OmniboxCreator/OmniBox/firmware/README.md

# OmniBox firmware

Bare-metal STM32H723 firmware for the OmniBox V1 board.

Version: 0.1 dev.

Public features:

- J2534 vendor bulk transport over WinUSB.
- ELM327-compatible CDC serial interface.
- USB identity selector with three empty public vendor slots.
- Board drivers for CAN/CAN-FD, K-line, J1850/SWCAN, FEPS and the routing matrix.

Current development status:

- Stable development path: J2534 CAN and ISO15765 over classic CAN.
- Implemented host/firmware capability negotiation for OmniBox protocol v2.
- Implemented OmniBox channel configuration hooks for physical bus selection,
  OBD routing, CAN termination, CAN polarity swap, SWCAN mode and CAN-FD flags.
- Implemented STM32 FDCAN and MCP2518FD CAN-FD framing paths with 64-byte DLC
  mapping and BRS/FDF flag propagation.
- Implemented ELM327 CAN single-frame transmit and multi-frame ISO-TP response
  reassembly.
- K-line init IOCTLs are wired through the host/firmware protocol; physical
  slow-init and fast-init timing still require bench validation.
- J1850, SWCAN and CAN-FD remain experimental until their physical-layer paths
  are validated on hardware.

The empty slots are intentionally protocol-free. They are placeholders for
non-commercial experiments without shipping any private identity implementation.

## Build

Prerequisites: `arm-none-eabi-gcc`, CMake and Ninja.

```bash
cmake -B build -G Ninja -DCMAKE_TOOLCHAIN_FILE=cmake/arm-gcc.cmake
cmake --build build
```

The first configure downloads CMSIS, STM32H7 HAL and TinyUSB through CMake
FetchContent. For offline builds, pre-populate `extern/` with the pinned
dependencies and configure with `-DFETCHCONTENT_FULLY_DISCONNECTED=ON`.
