OmniboxCreator/OmniBox/docs/README.md

# Public notes

This directory is reserved for public OmniBox notes. Private research material is
not part of this repository.
