OmniboxCreator/OmniBox/hardware/omnibox-v1/enclosure/sheetmetal/README.md

# Sheet-Metal Enclosure

This directory contains the V1 sheet-metal enclosure files:

- `out/bac.step`: base tray.
- `out/capot.step`: top cover.
- `out/laser_marking_capot.dxf`: laser-marking drawing.
- `preview.png`: generated preview.

Check connector clearances and bend constraints with the enclosure supplier
before ordering.
