OmniboxCreator/OmniBox/hardware/omnibox-v1/enclosure/sheetmetal/out/laser_marking_preview.png

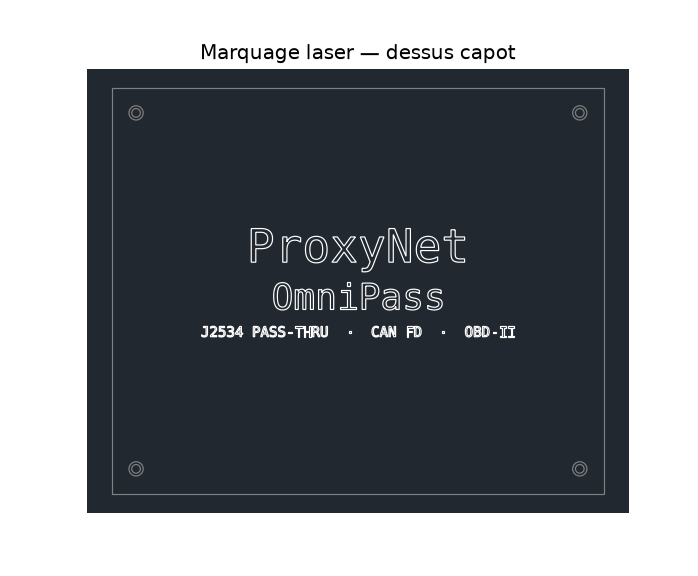
hardware/omnibox-v1/enclosure/sheetmetal/out/laser_marking_preview.png
