OmniboxCreator/OmniBox/hardware/omnibox-v1/enclosure/sheetmetal/preview.png

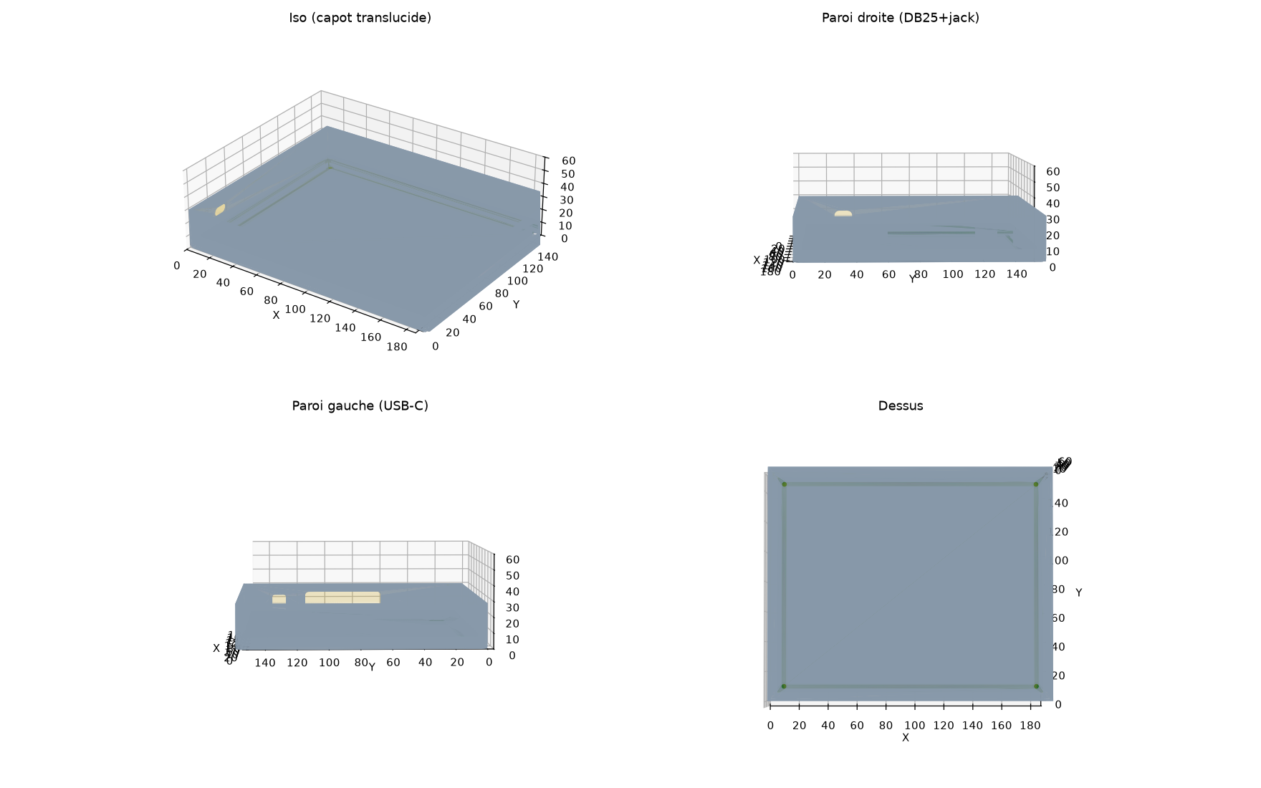
hardware/omnibox-v1/enclosure/sheetmetal/preview.png
