OmniboxCreator/OmniBox/hardware/omnibox-v1/enclosure/print3d/out/panneau.step

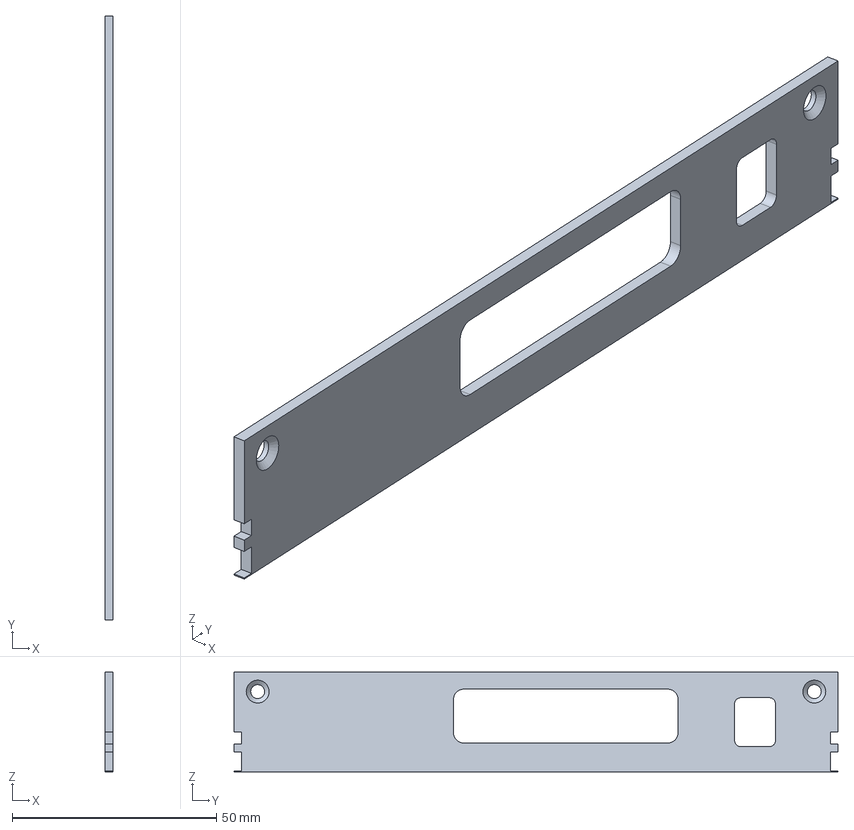
[picture p4: CAD file, 2026-07-20]
hardware/omnibox-v1/enclosure/print3d/out/panneau.step
2.00 x 148.0 x 24.5 mm
