OmniboxCreator/OmniBox/hardware/omnibox-v1/enclosure/sheetmetal/out/laser_marking_capot.dxf

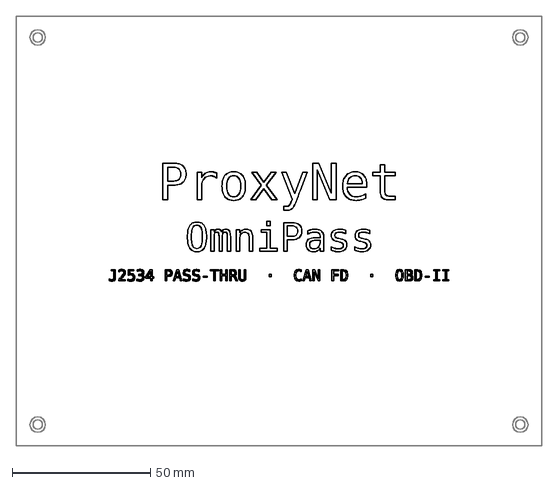
[picture p5: CAD file, 2026-07-20]
hardware/omnibox-v1/enclosure/sheetmetal/out/laser_marking_capot.dxf
189.8 x 155.3 mm
