OmniboxCreator/OmniBox/hardware/omnibox-v1/enclosure/print3d/out/fourreau.step

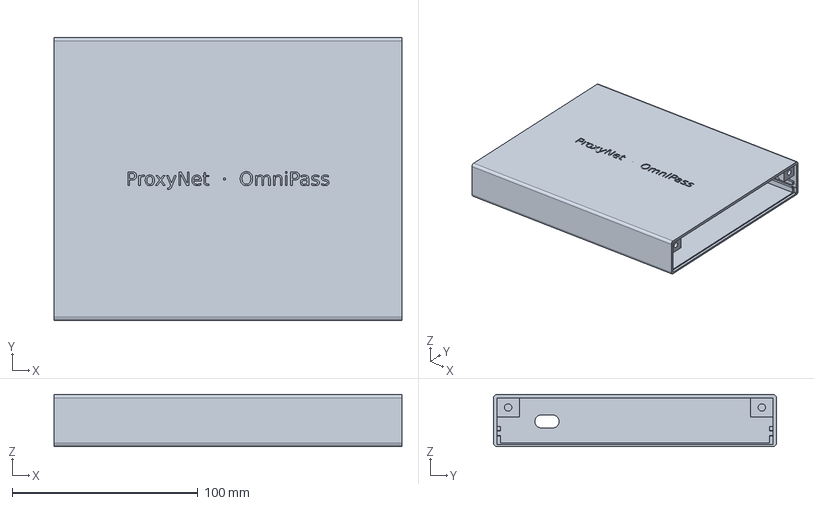
[picture p6: CAD file, 2026-07-20]
hardware/omnibox-v1/enclosure/print3d/out/fourreau.step
187.2 x 152.4 x 28.0 mm
