OmniboxCreator/OmniBox/hardware/omnibox-v1/enclosure/sheetmetal/out/capot.step

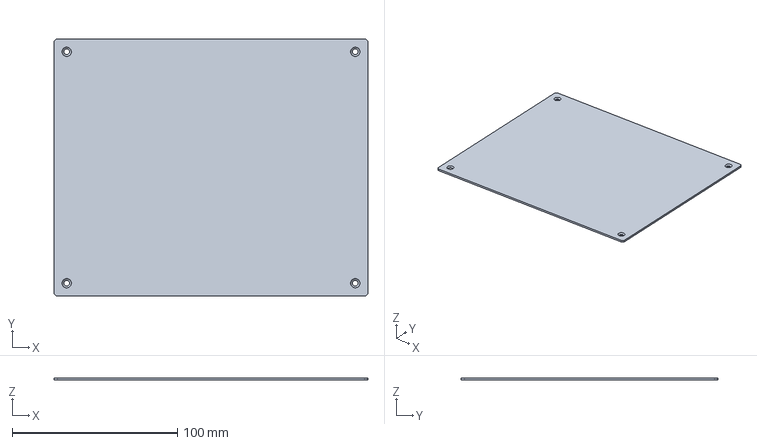
[picture p7: CAD file, 2026-07-20]
hardware/omnibox-v1/enclosure/sheetmetal/out/capot.step
189.8 x 155.3 x 1.50 mm
