OmniboxCreator/OmniBox/hardware/omnibox-v1/enclosure/sheetmetal/out/bac.step

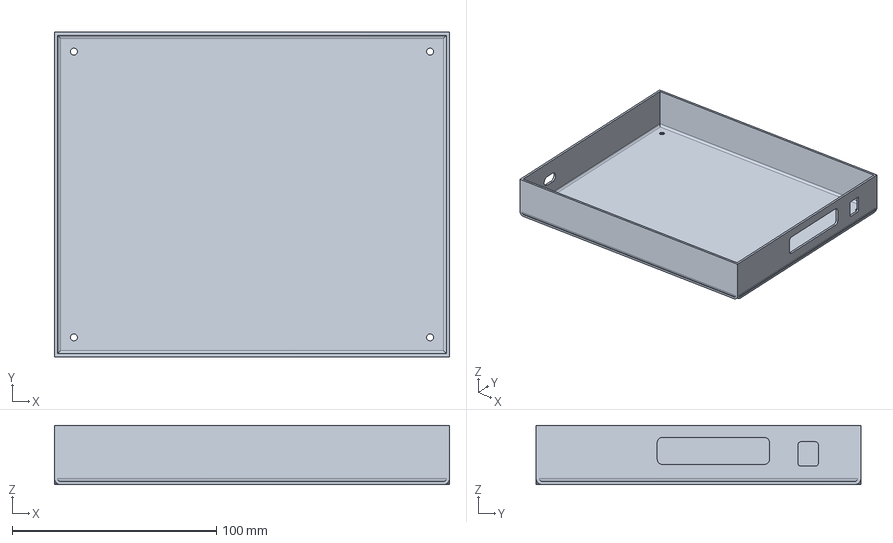
[picture p8: CAD file, 2026-07-20]
hardware/omnibox-v1/enclosure/sheetmetal/out/bac.step
193.4 x 158.9 x 29.0 mm
