OmniboxCreator/OmniBox/(list of files, cad)

Other CAD files:
hardware/omnibox-v1/enclosure/print3d/out/fourreau.stl
hardware/omnibox-v1/enclosure/print3d/out/panneau.stl
hardware/omnibox-v1/enclosure/sheetmetal/out/bac.stl
hardware/omnibox-v1/enclosure/sheetmetal/out/capot.stl
