OmniboxCreator/OmniBox/hardware/omnibox-v1/enclosure/print3d/README.md

# 3D-Printed Accessories

This directory contains auxiliary printable enclosure parts:

- `out/fourreau.step` / `out/fourreau.stl`
- `out/panneau.step` / `out/panneau.stl`

These parts complement the sheet-metal enclosure and should be checked against
the assembled PCB before production.
