OmniboxCreator/OmniBox/hardware/omnibox-v1/production/j2534-schematics.pdf

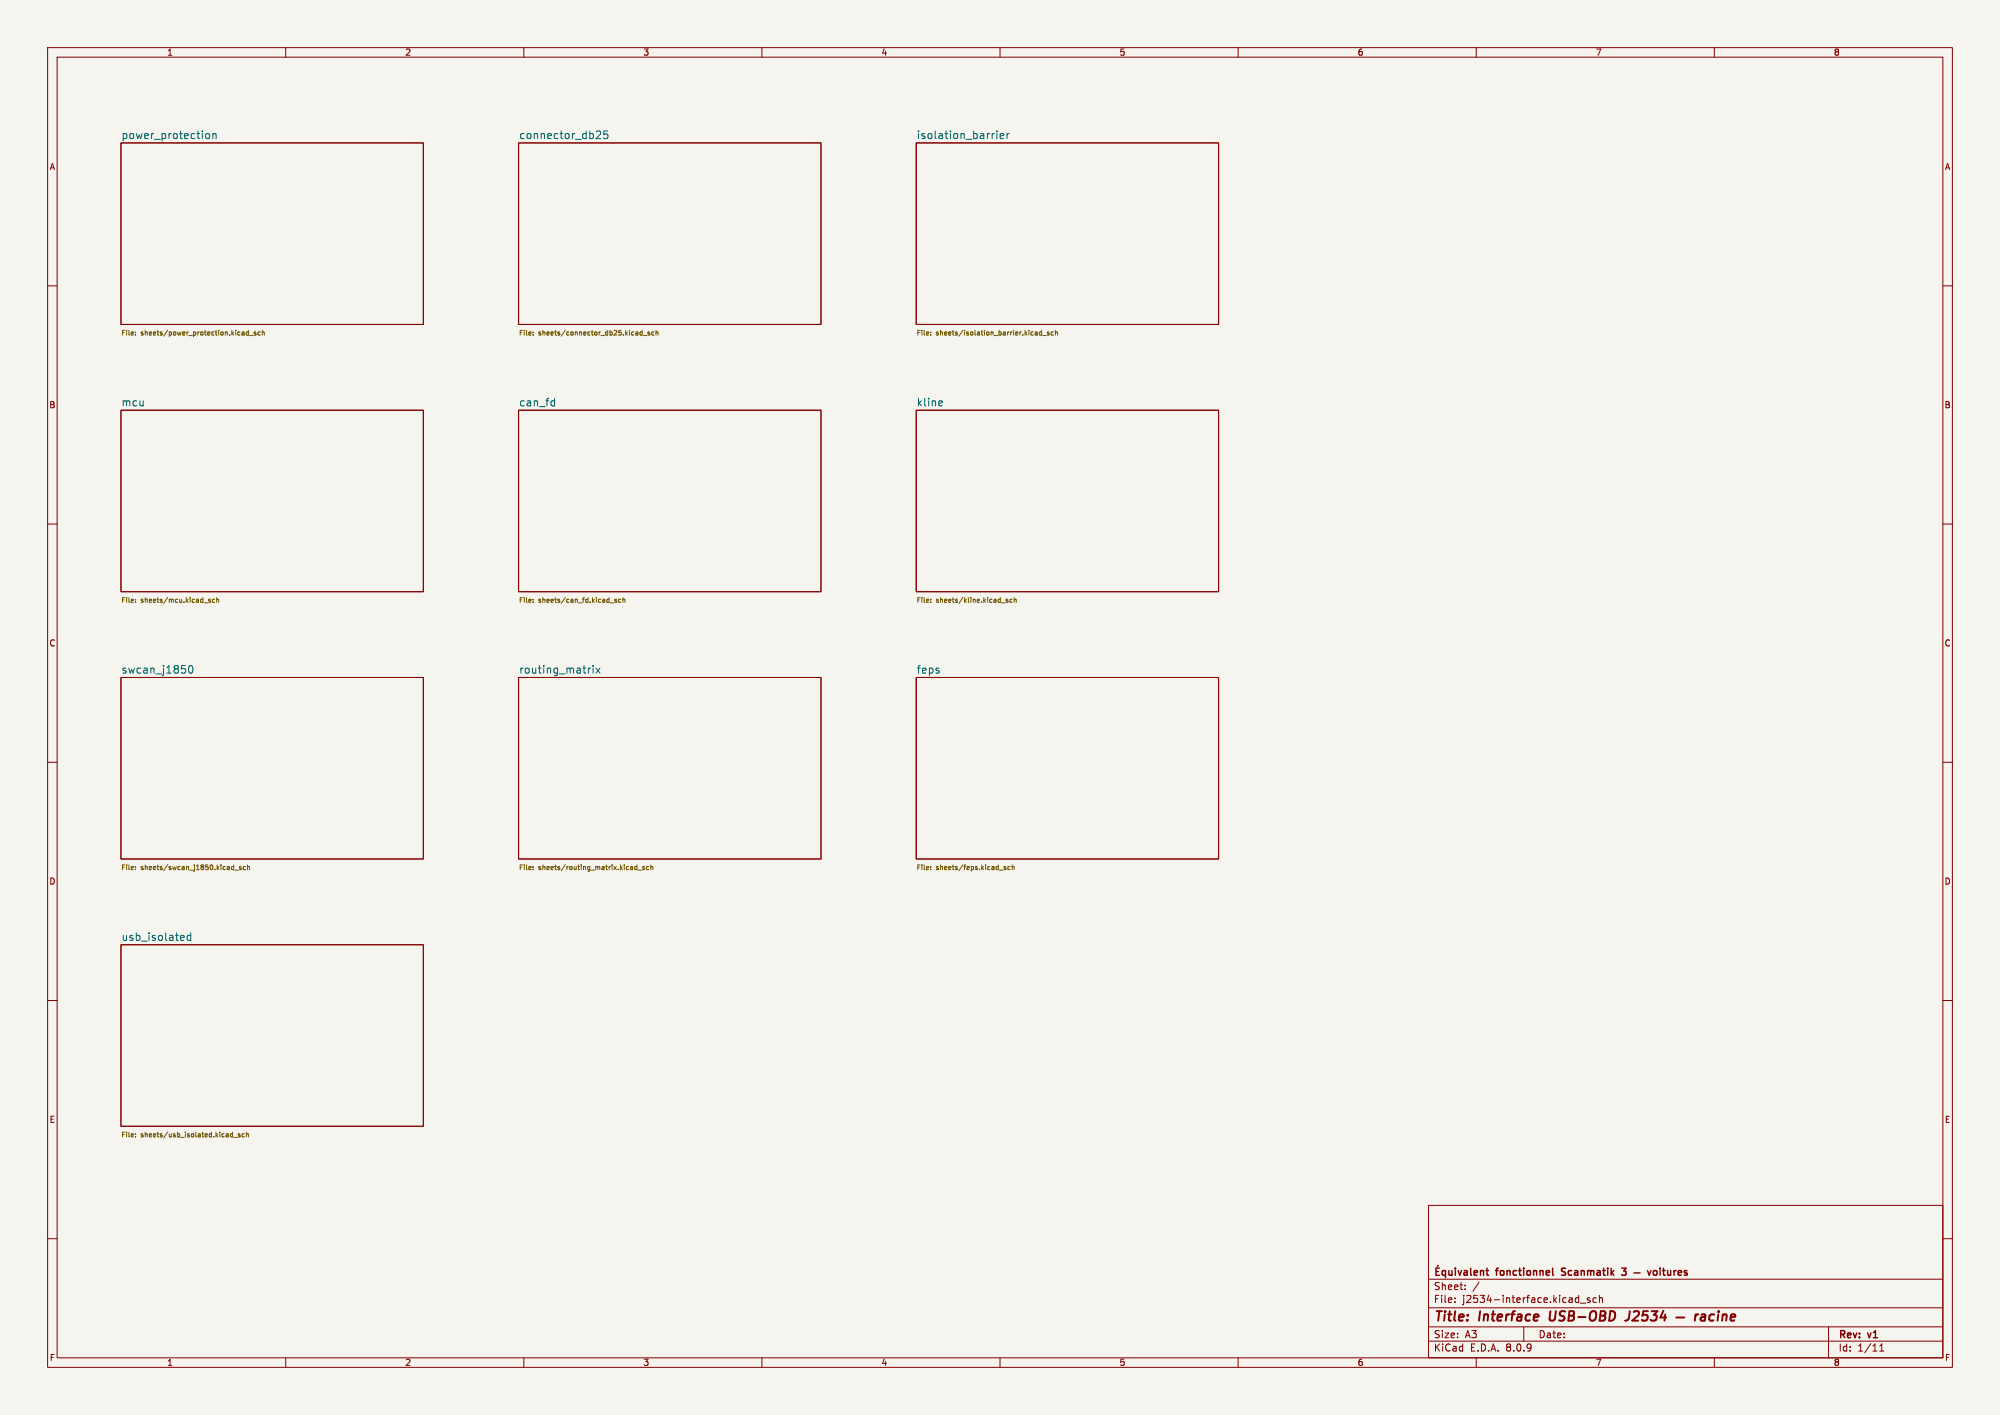
[picture p9: page 1]

Id: 1/11 Title: Interface USB-OBD J2534 þÿ racine

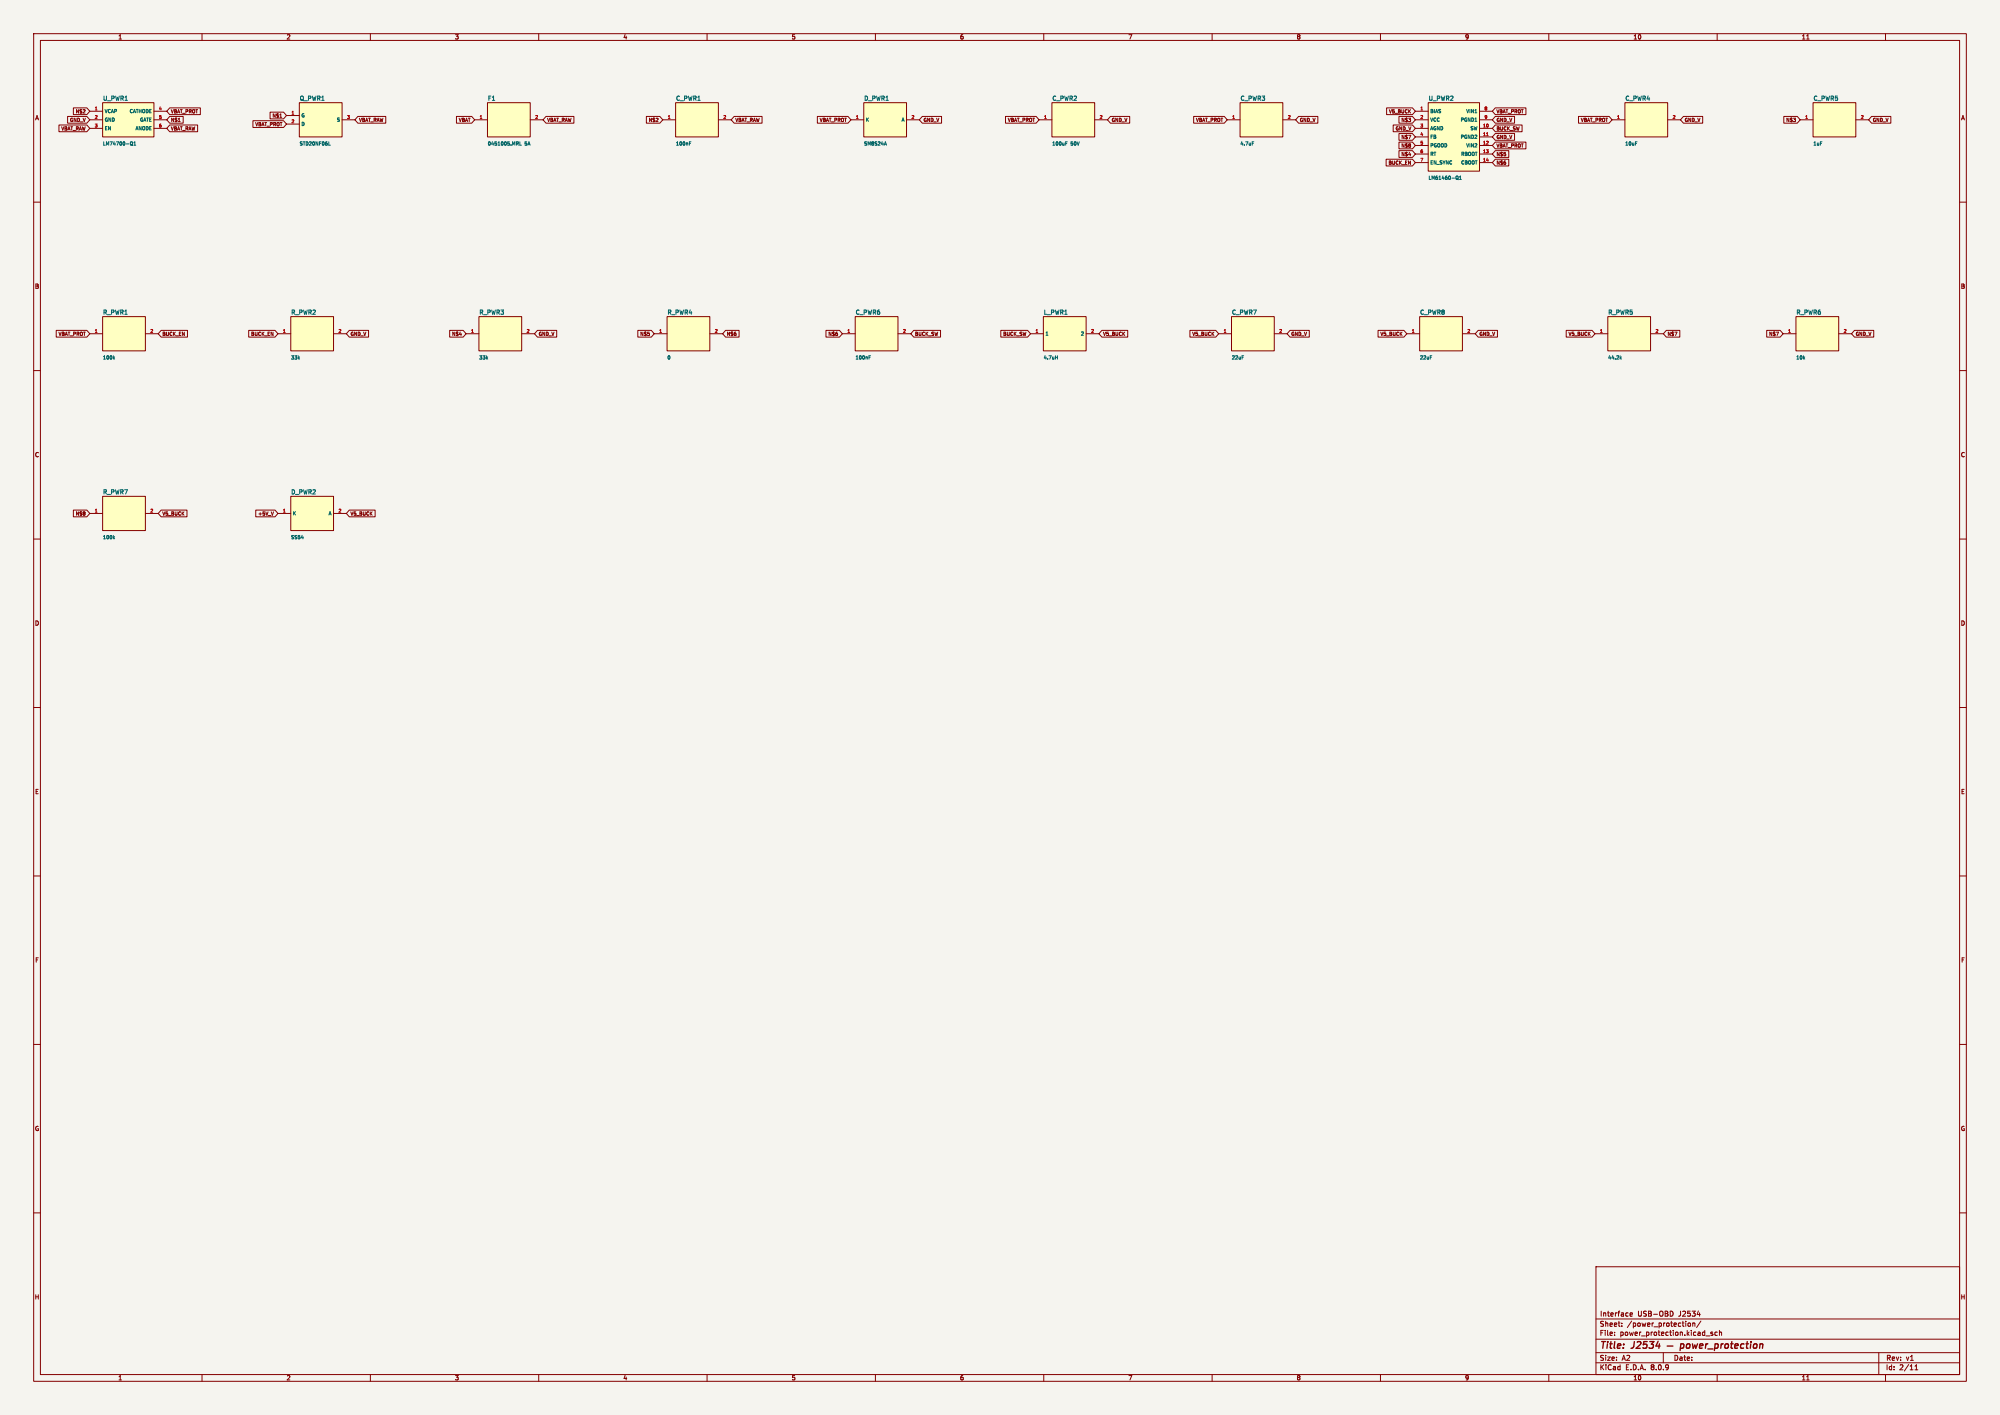
[picture p10: page 2]

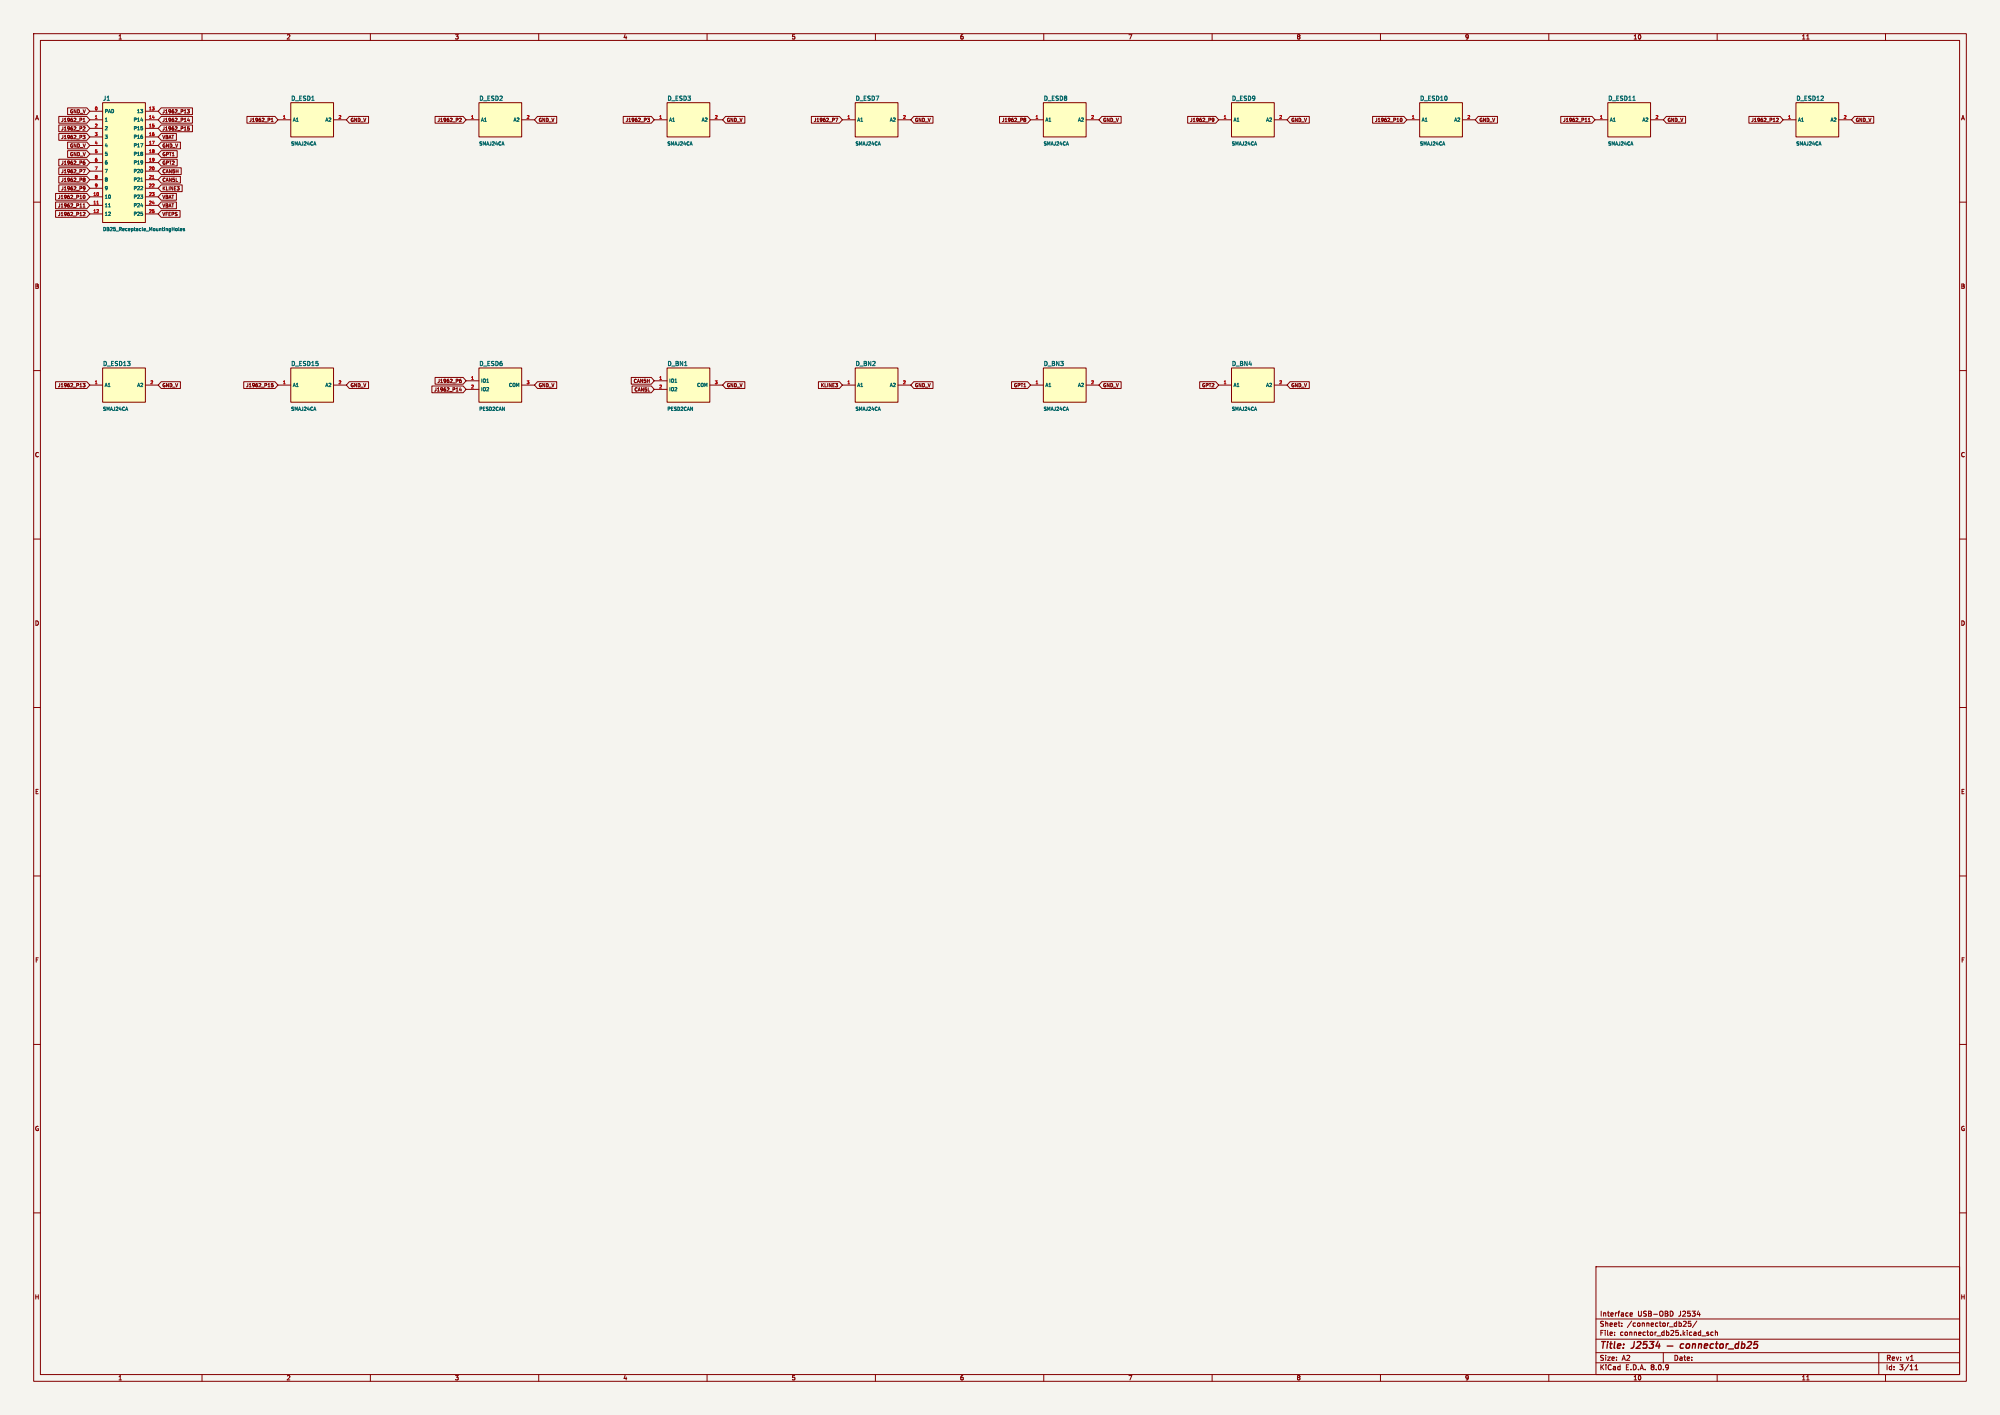
[picture p11: page 3]

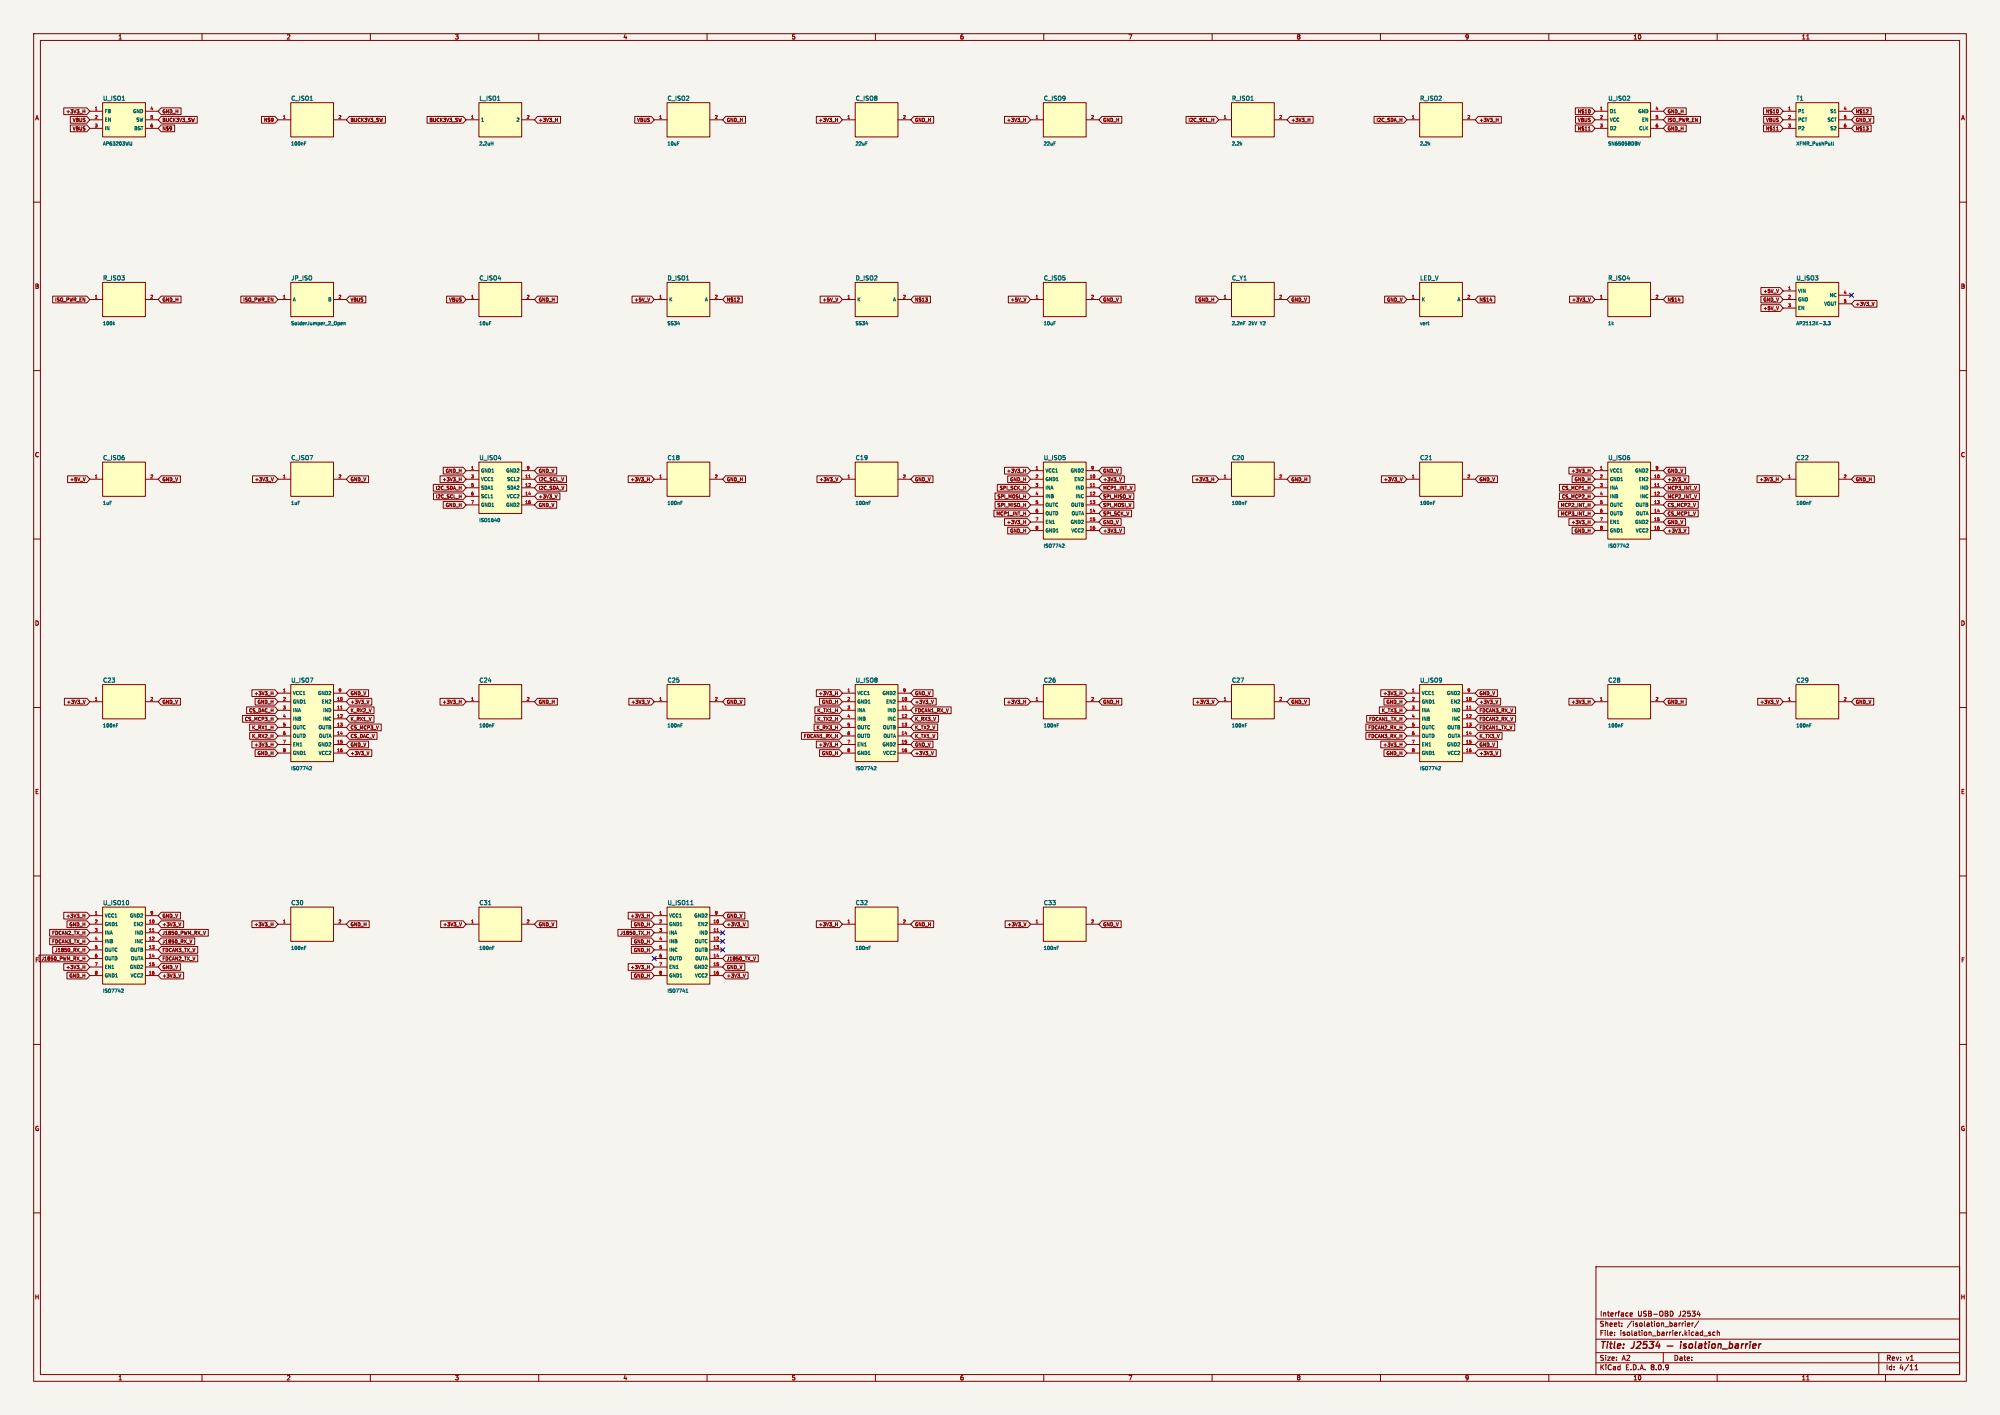
[picture p12: page 4]

IND 11 OUTC 12 OUTB 13 OUTA 14 GND2 15 VCC2 16 GND1 2
INA 3
INB 4

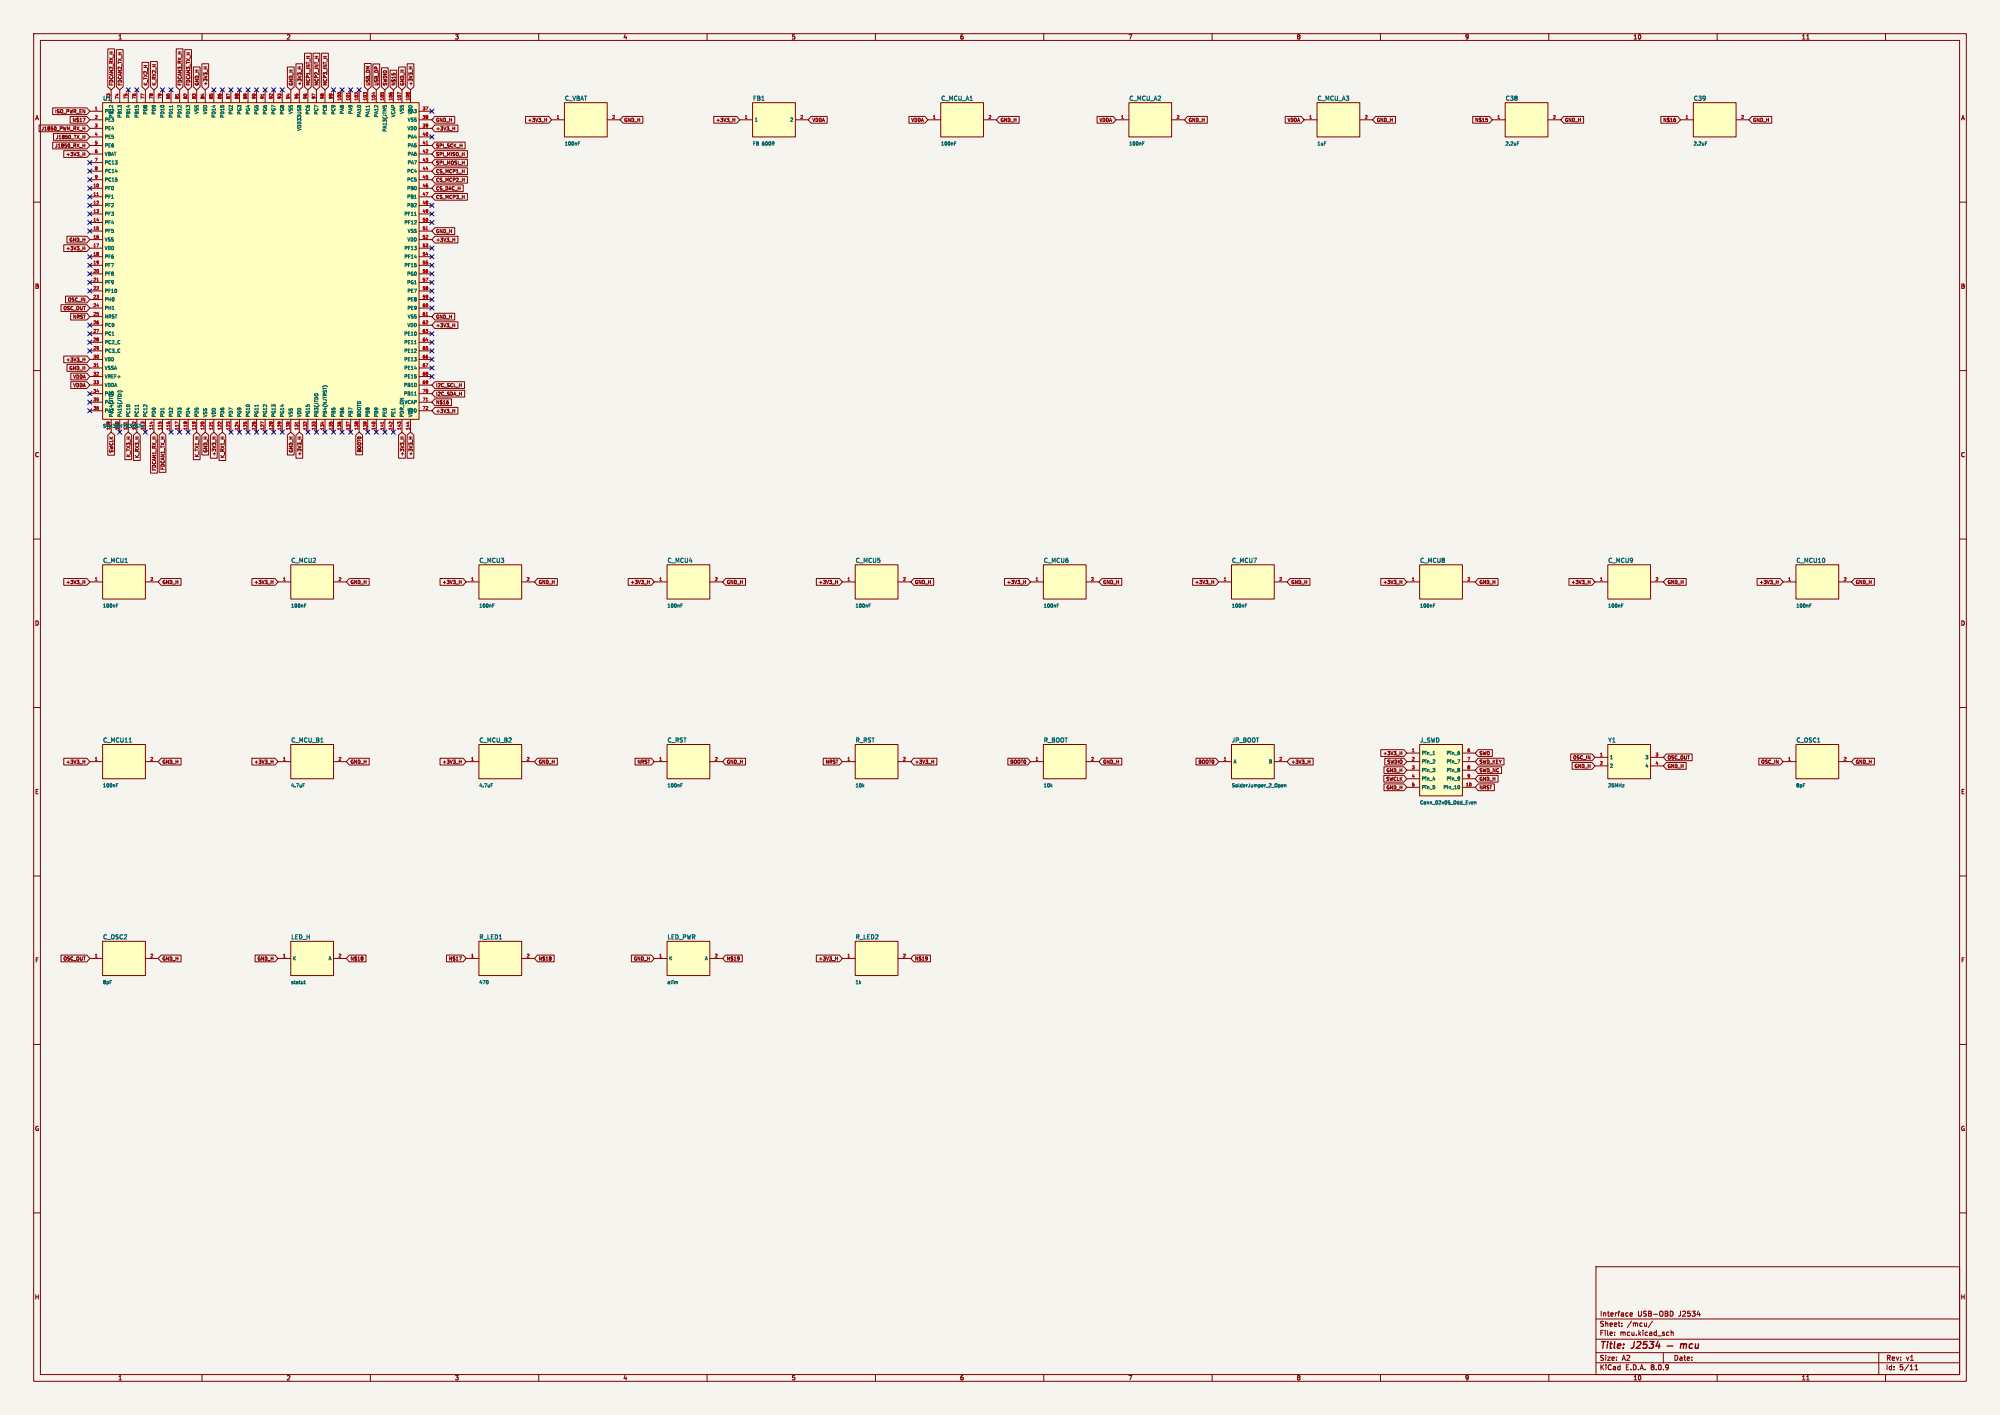
[picture p13: page 5]

File: mcu.kicad_sch Sheet: /mcu/

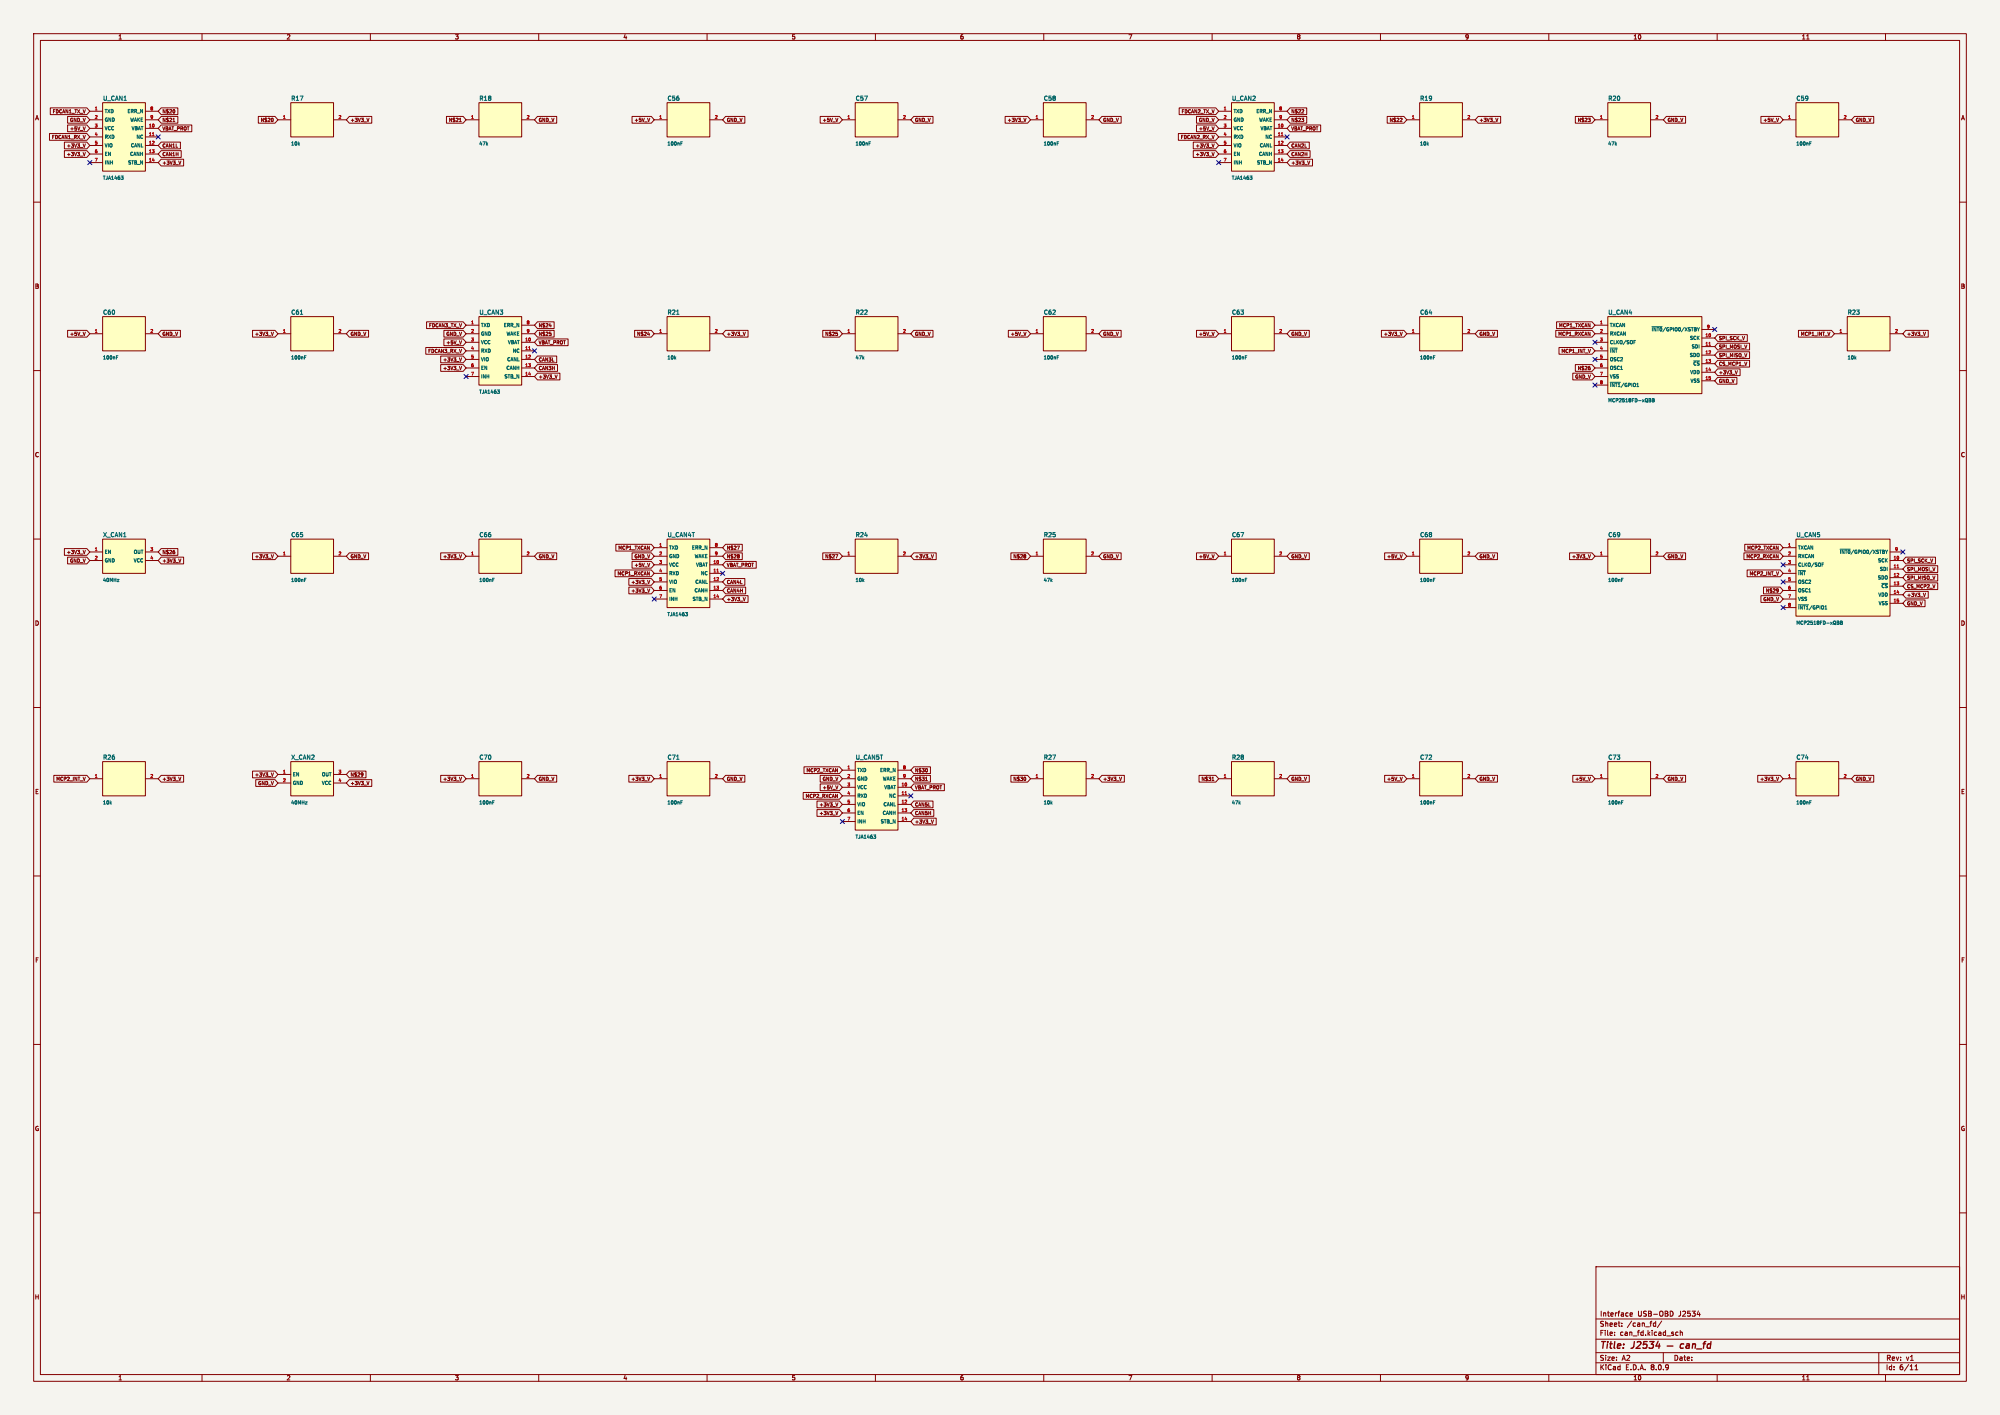
[picture p14: page 6]

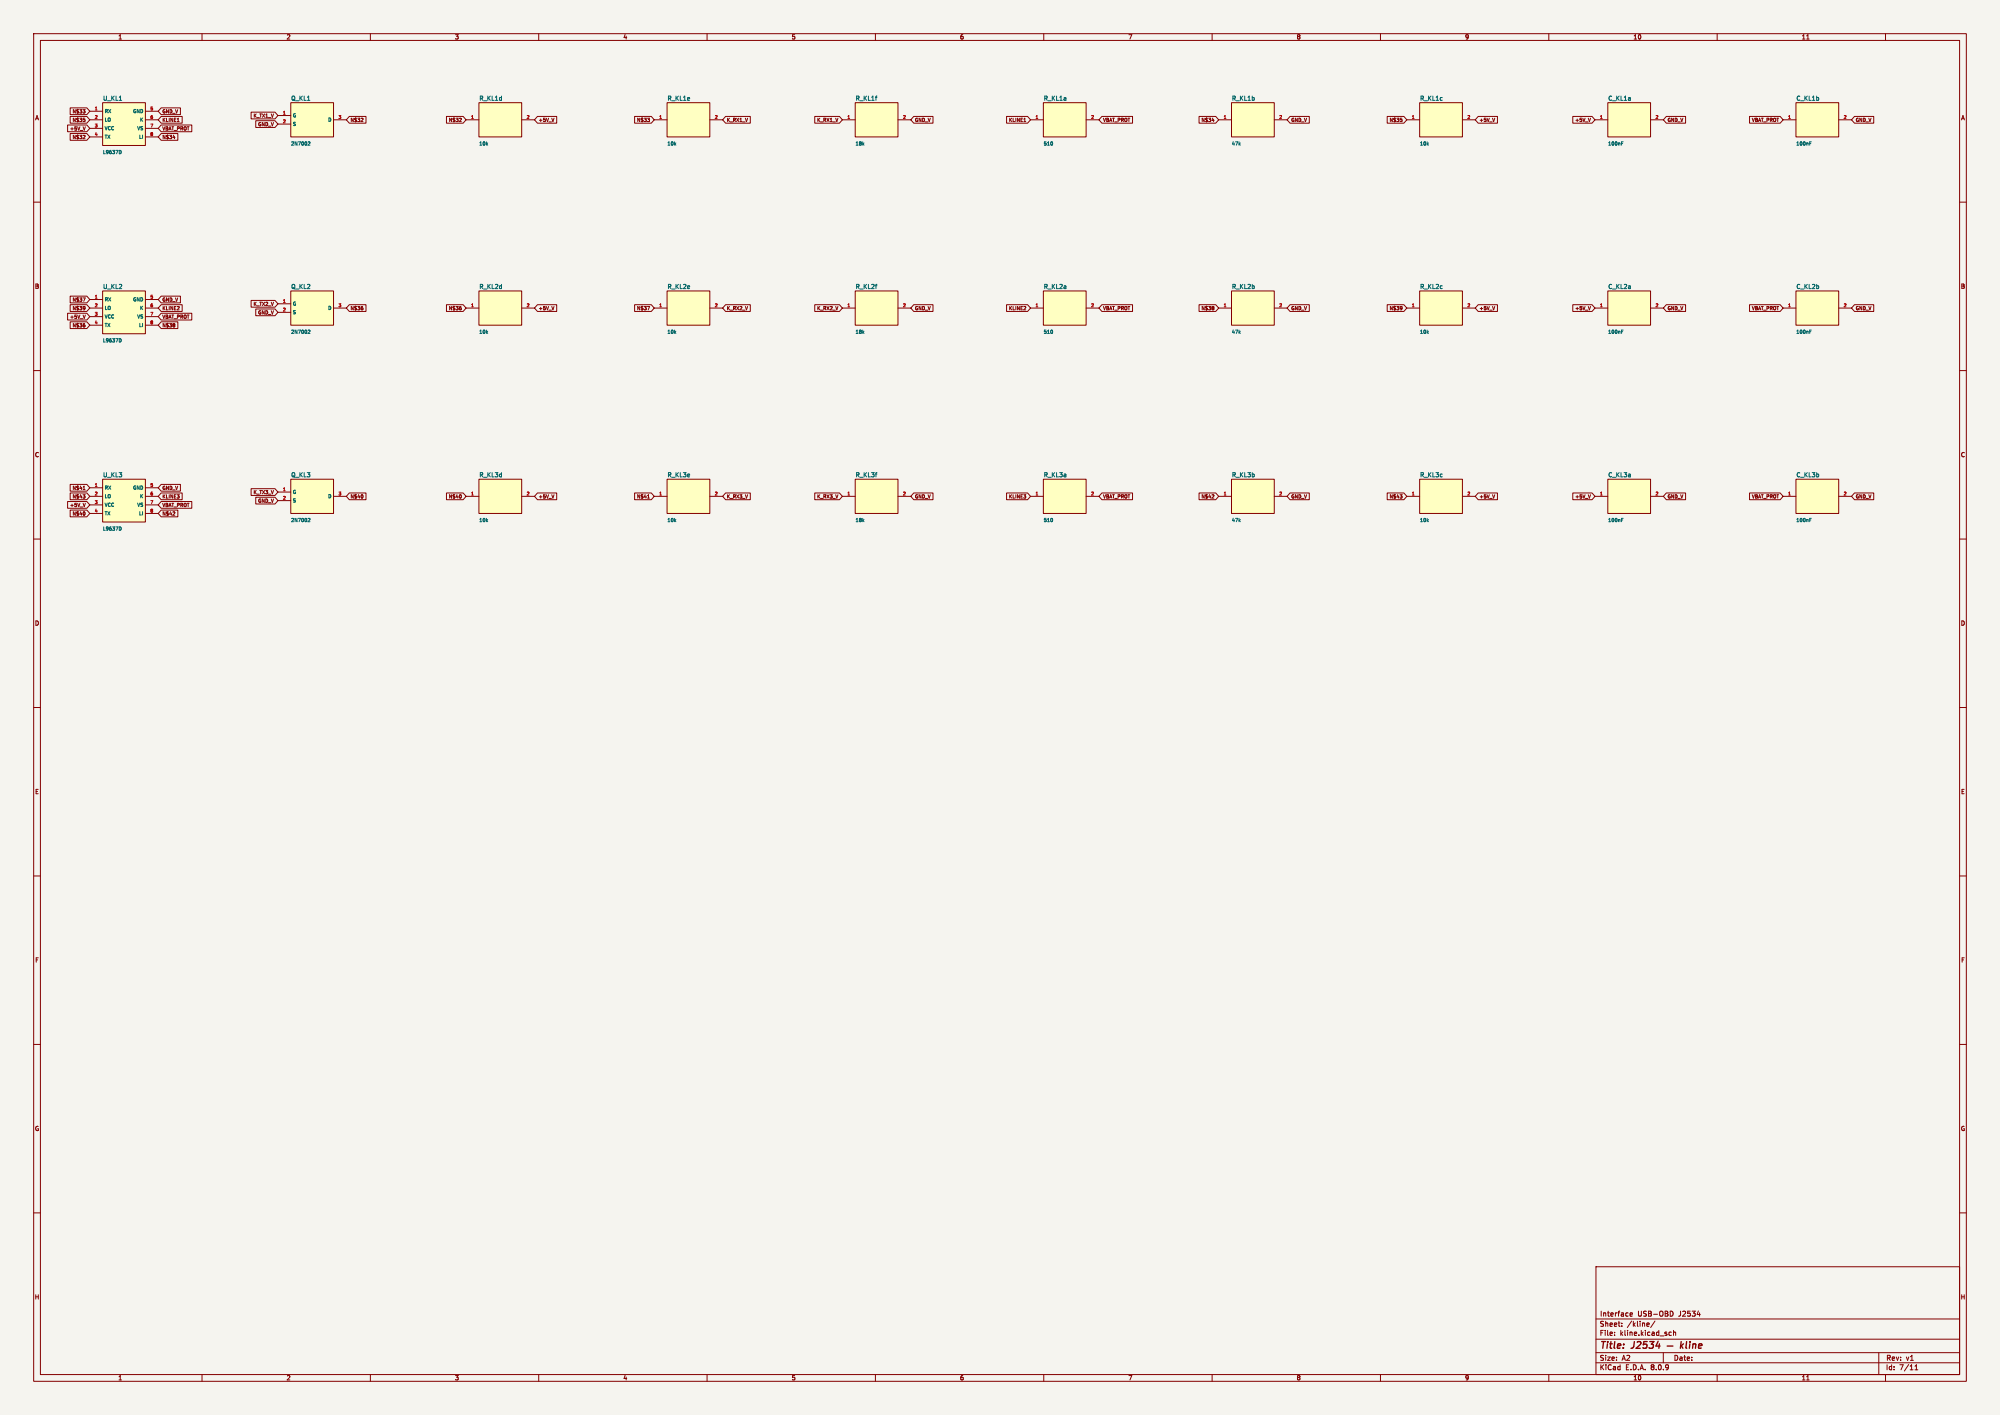
[picture p15: page 7]

File: kline.kicad_sch Sheet: /kline/

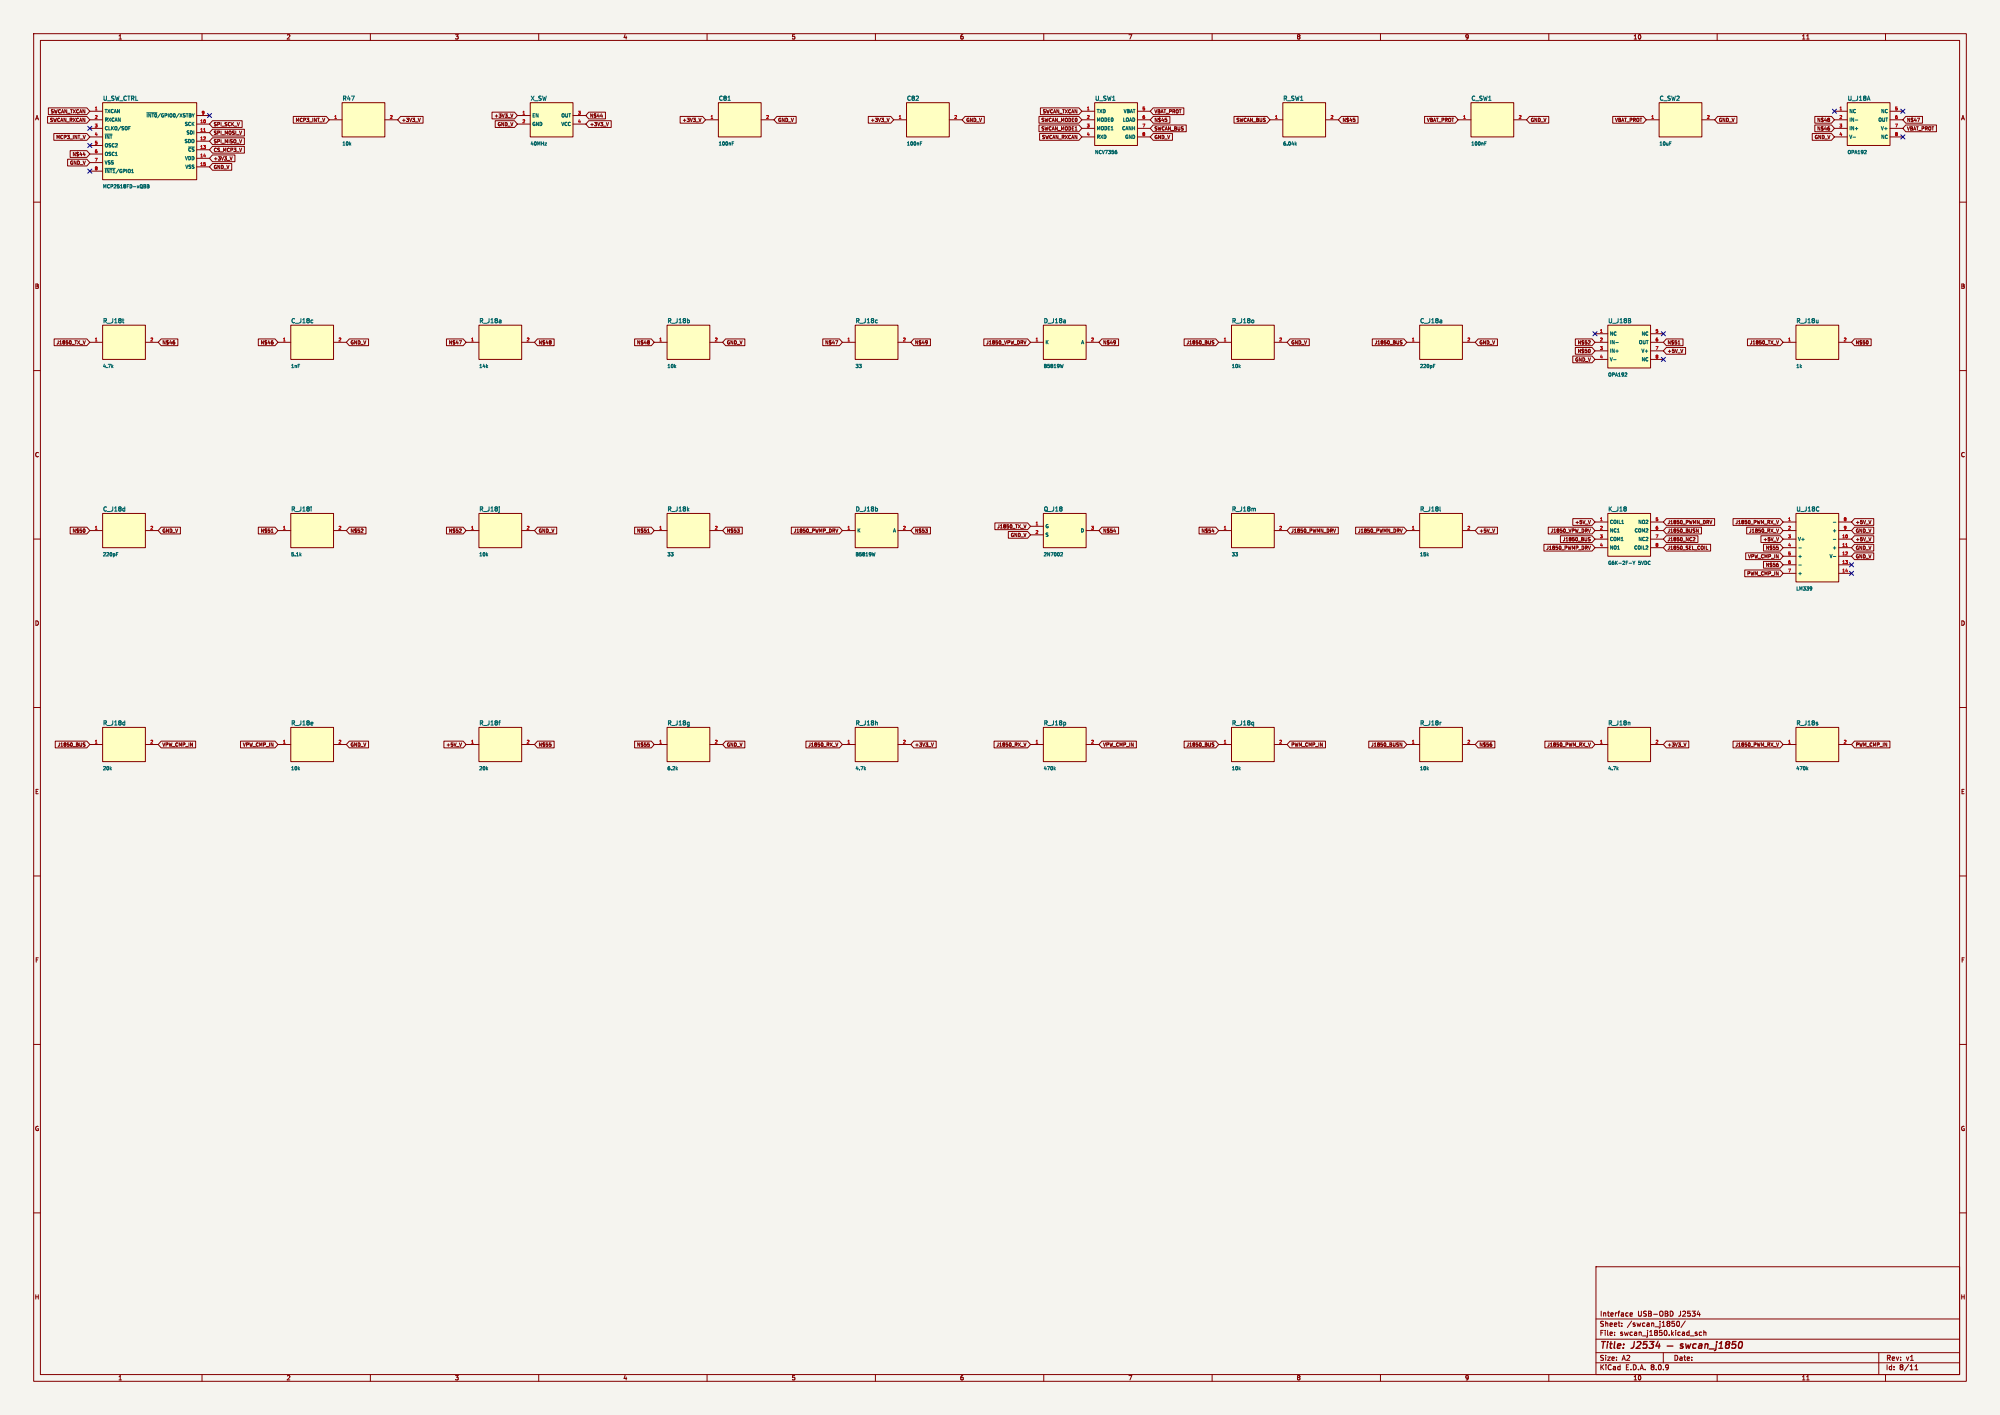
[picture p16: page 8]

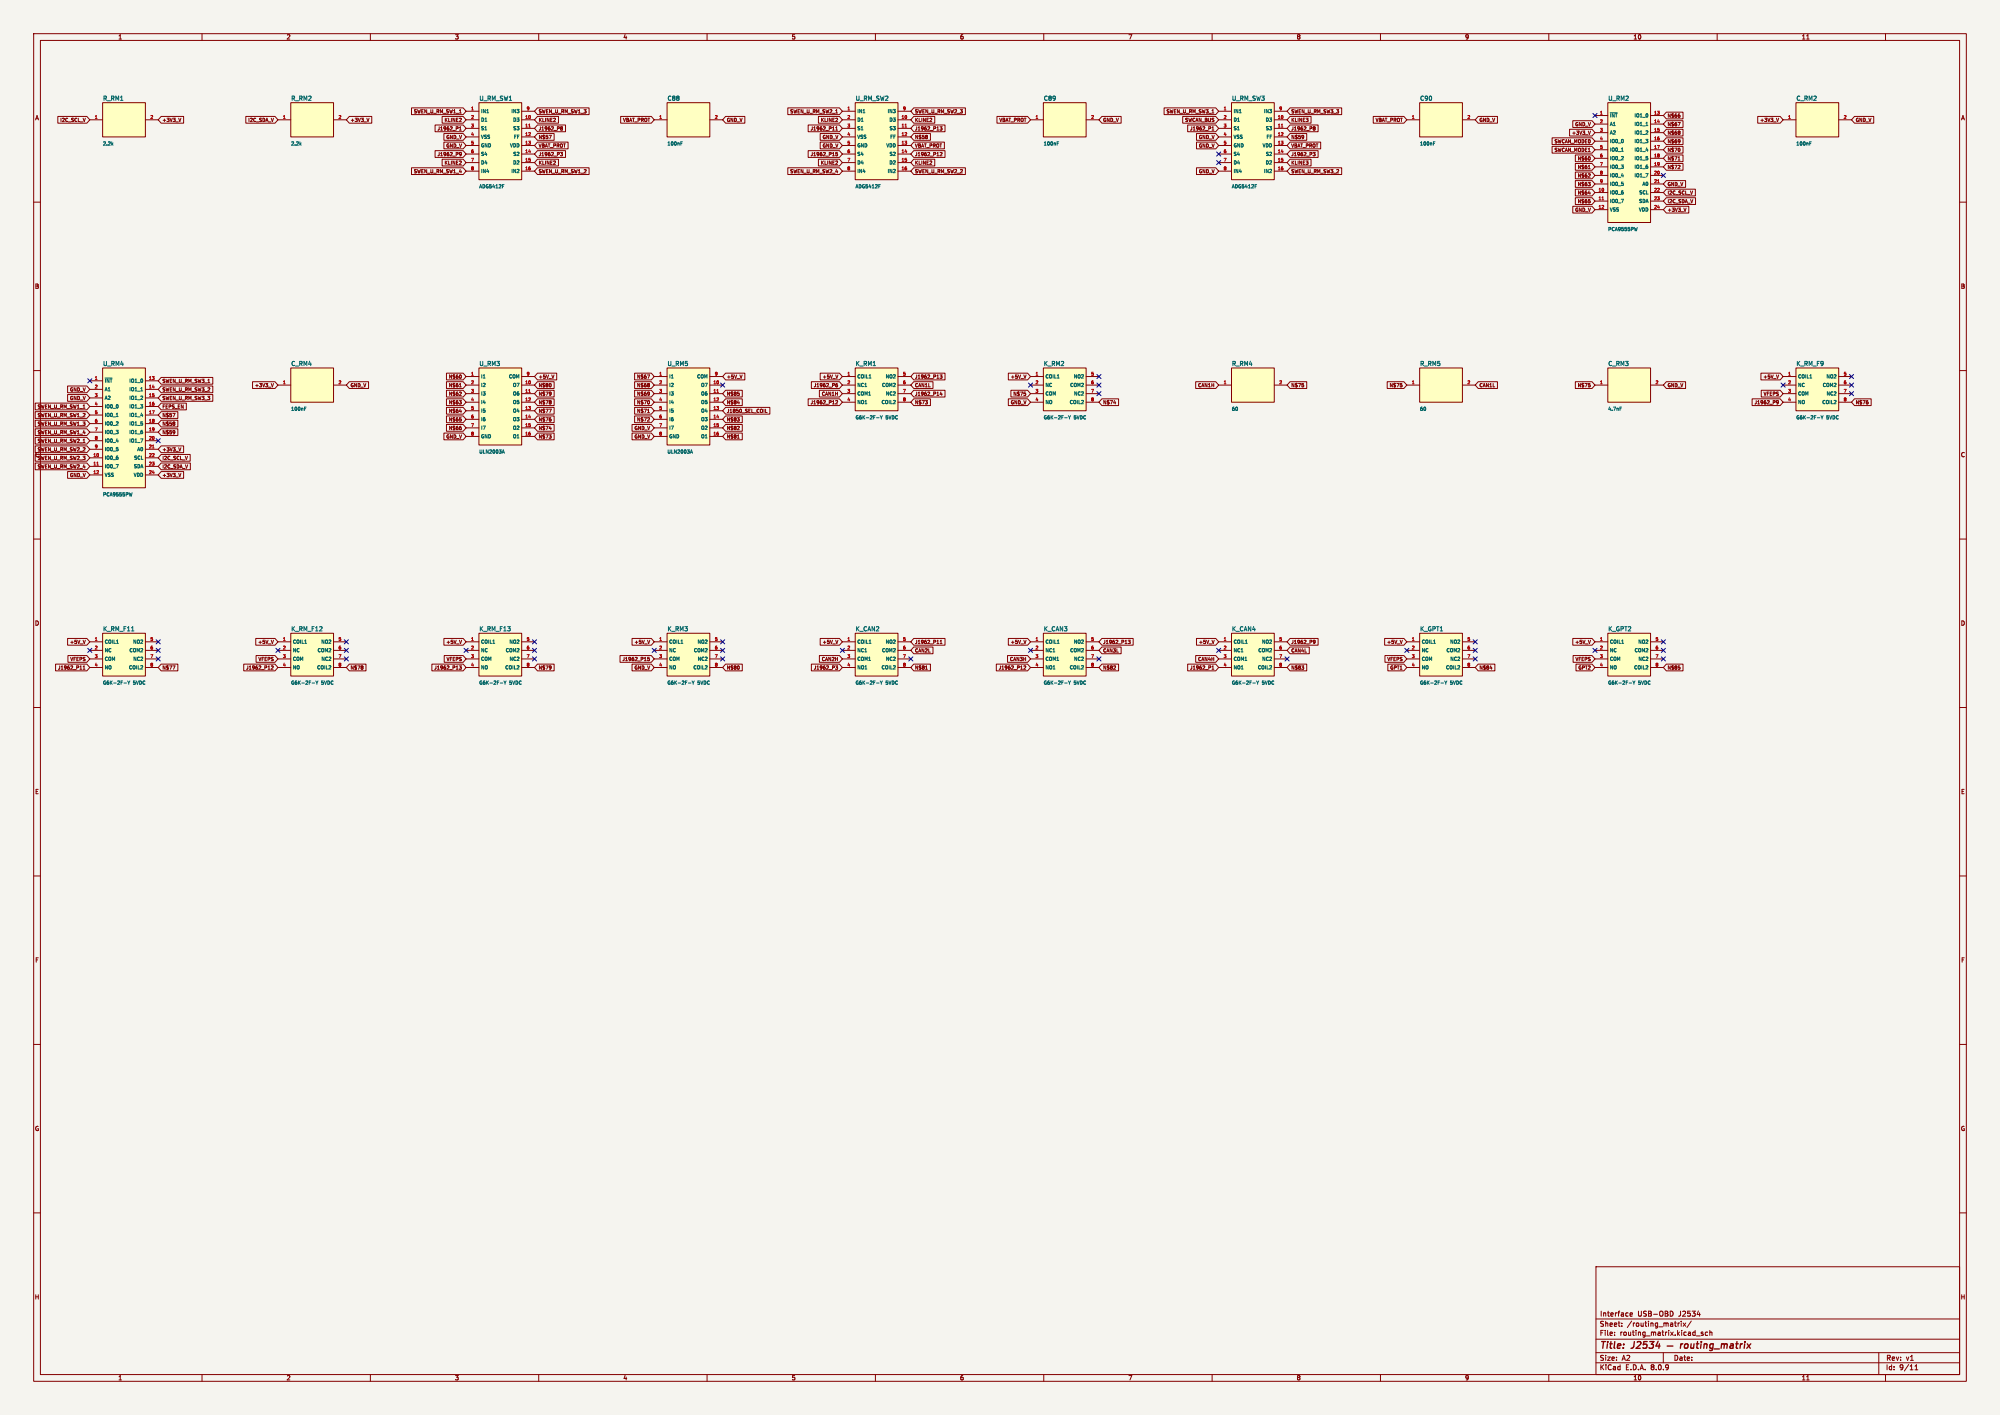
[picture p17: page 9]

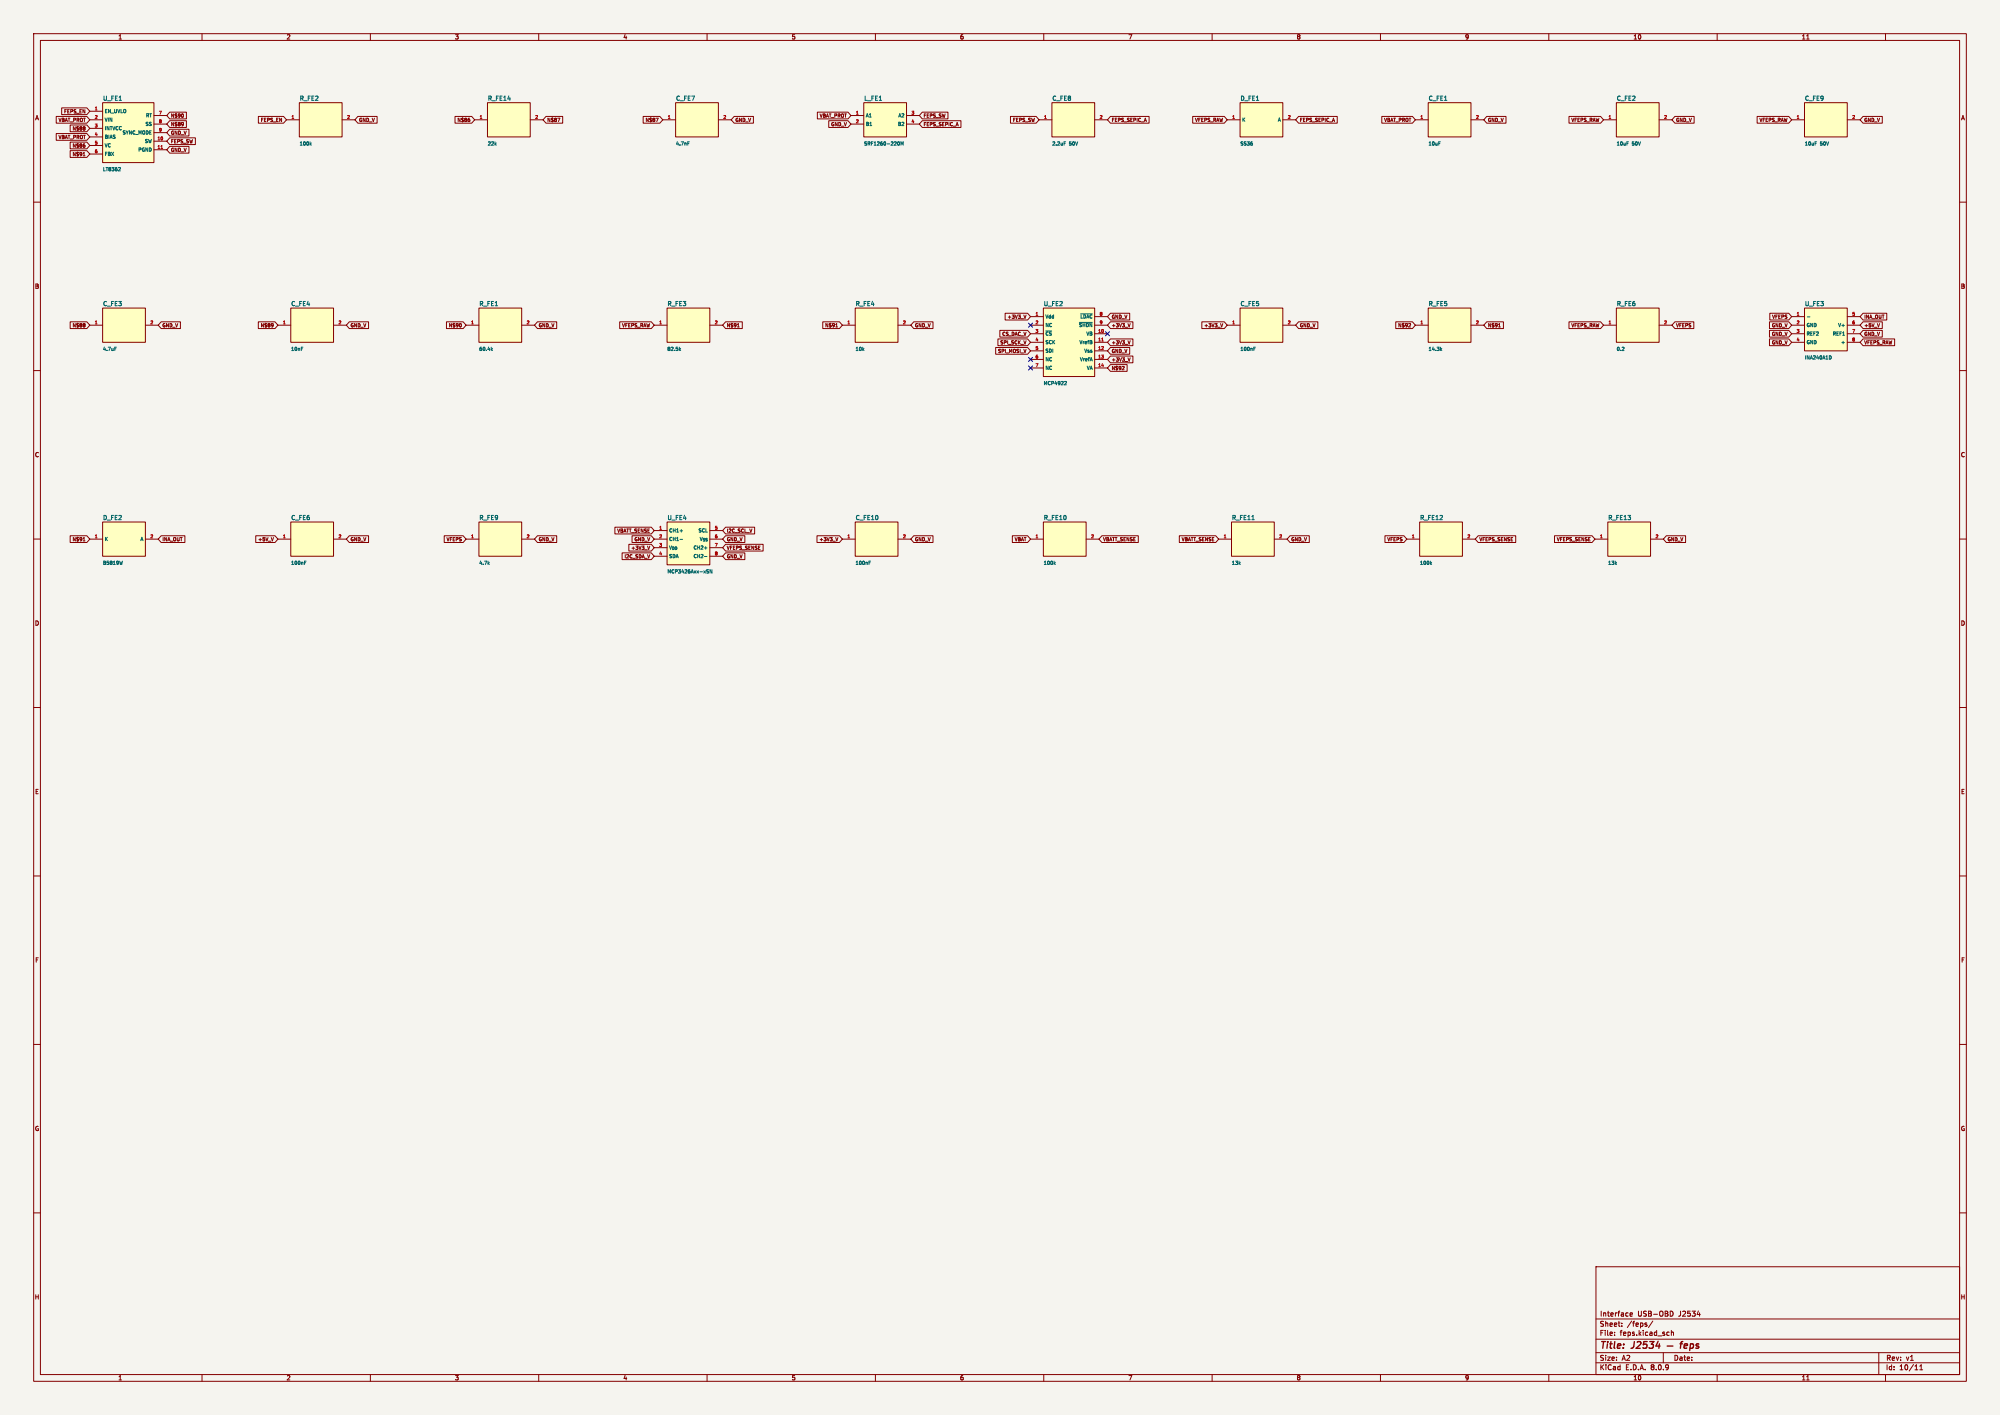
[picture p18: page 10]

File: feps.kicad_sch Sheet: /feps/

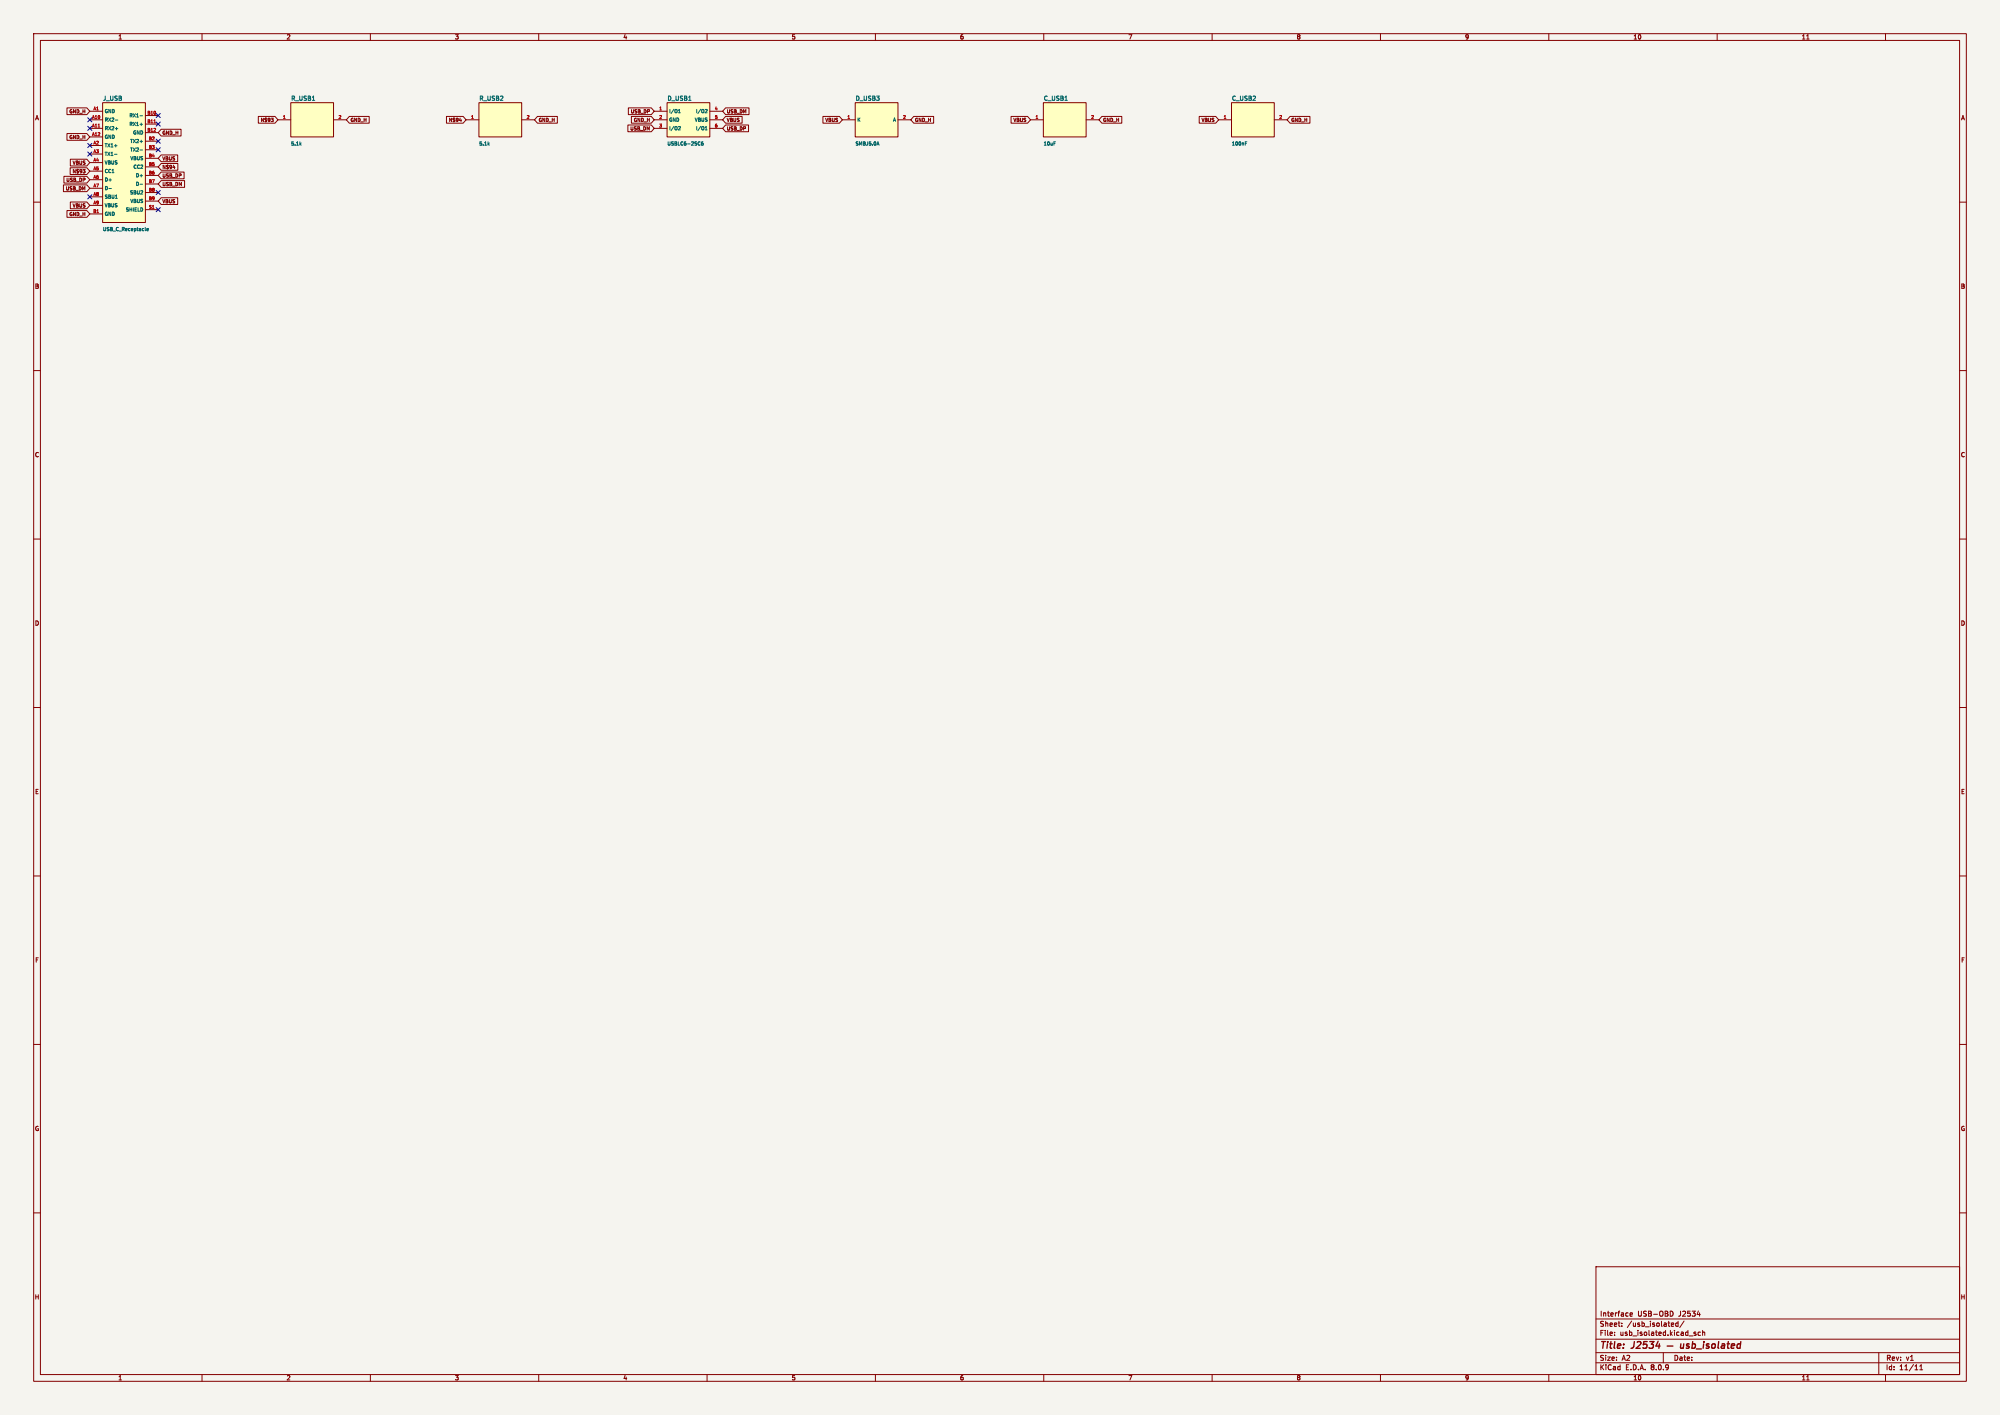
[picture p19: page 11]
