OmniboxCreator/OmniBox/hardware/omnibox-v1/sheets/can_fd.kicad_sch

## KiCad design hardware/omnibox-v1/sheets/can_fd.kicad_sch (2026-07-20)

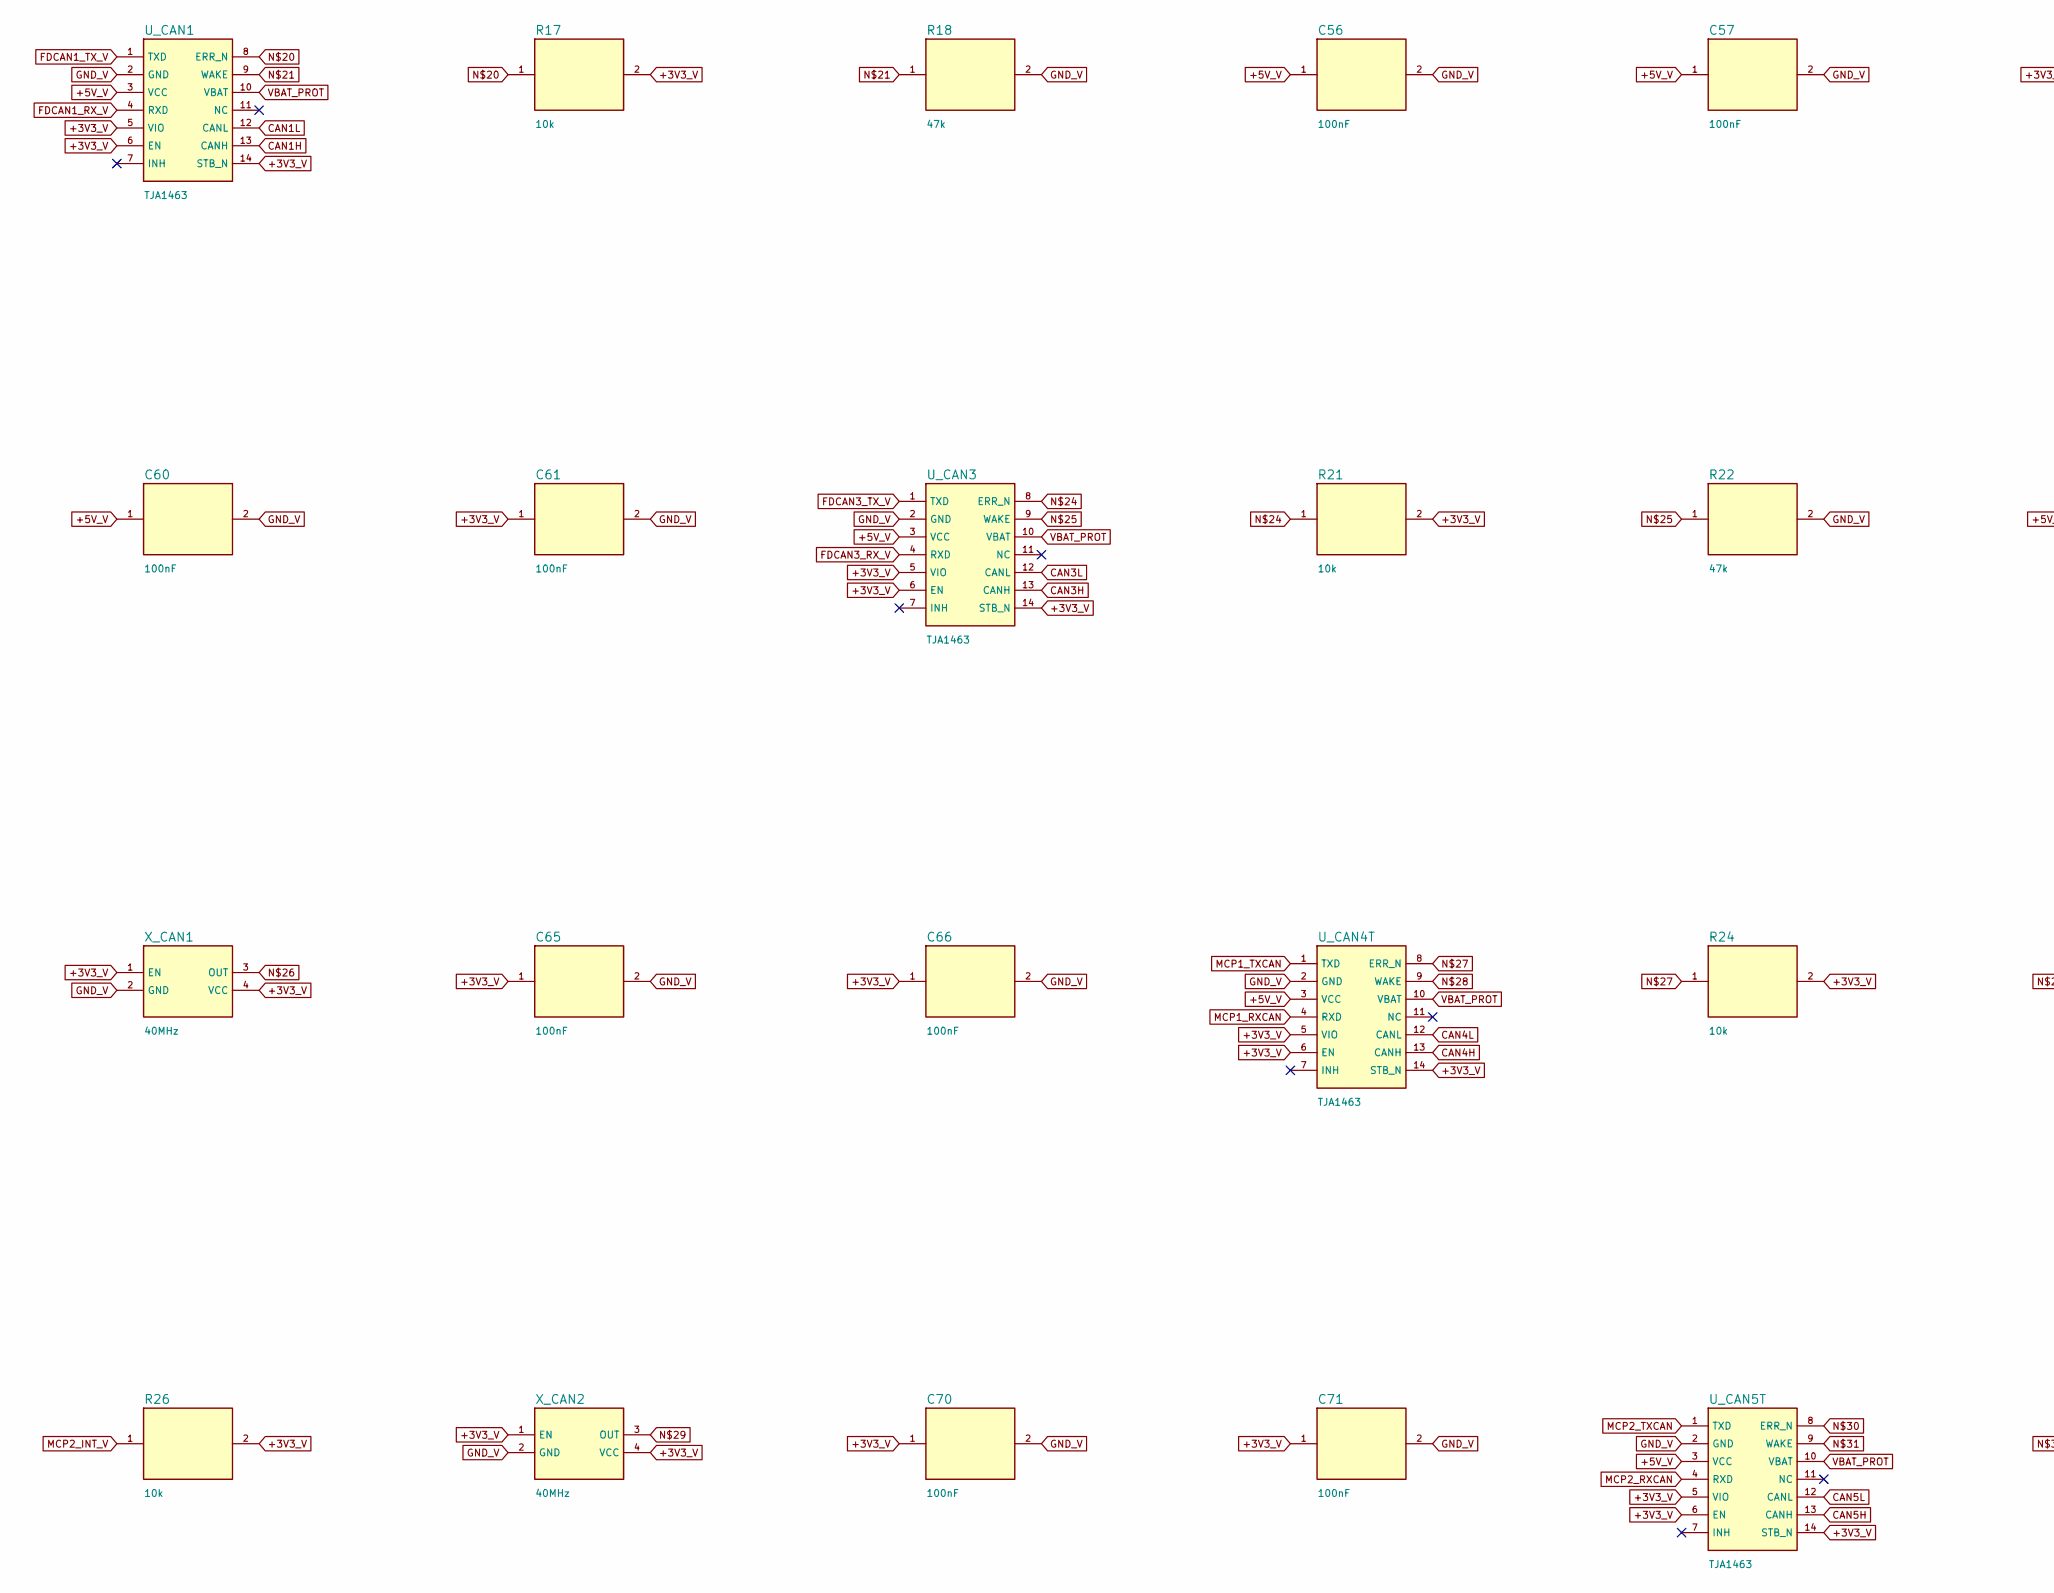
[picture p20: schematic can_fd.kicad_sch, part in row 1, column 1]

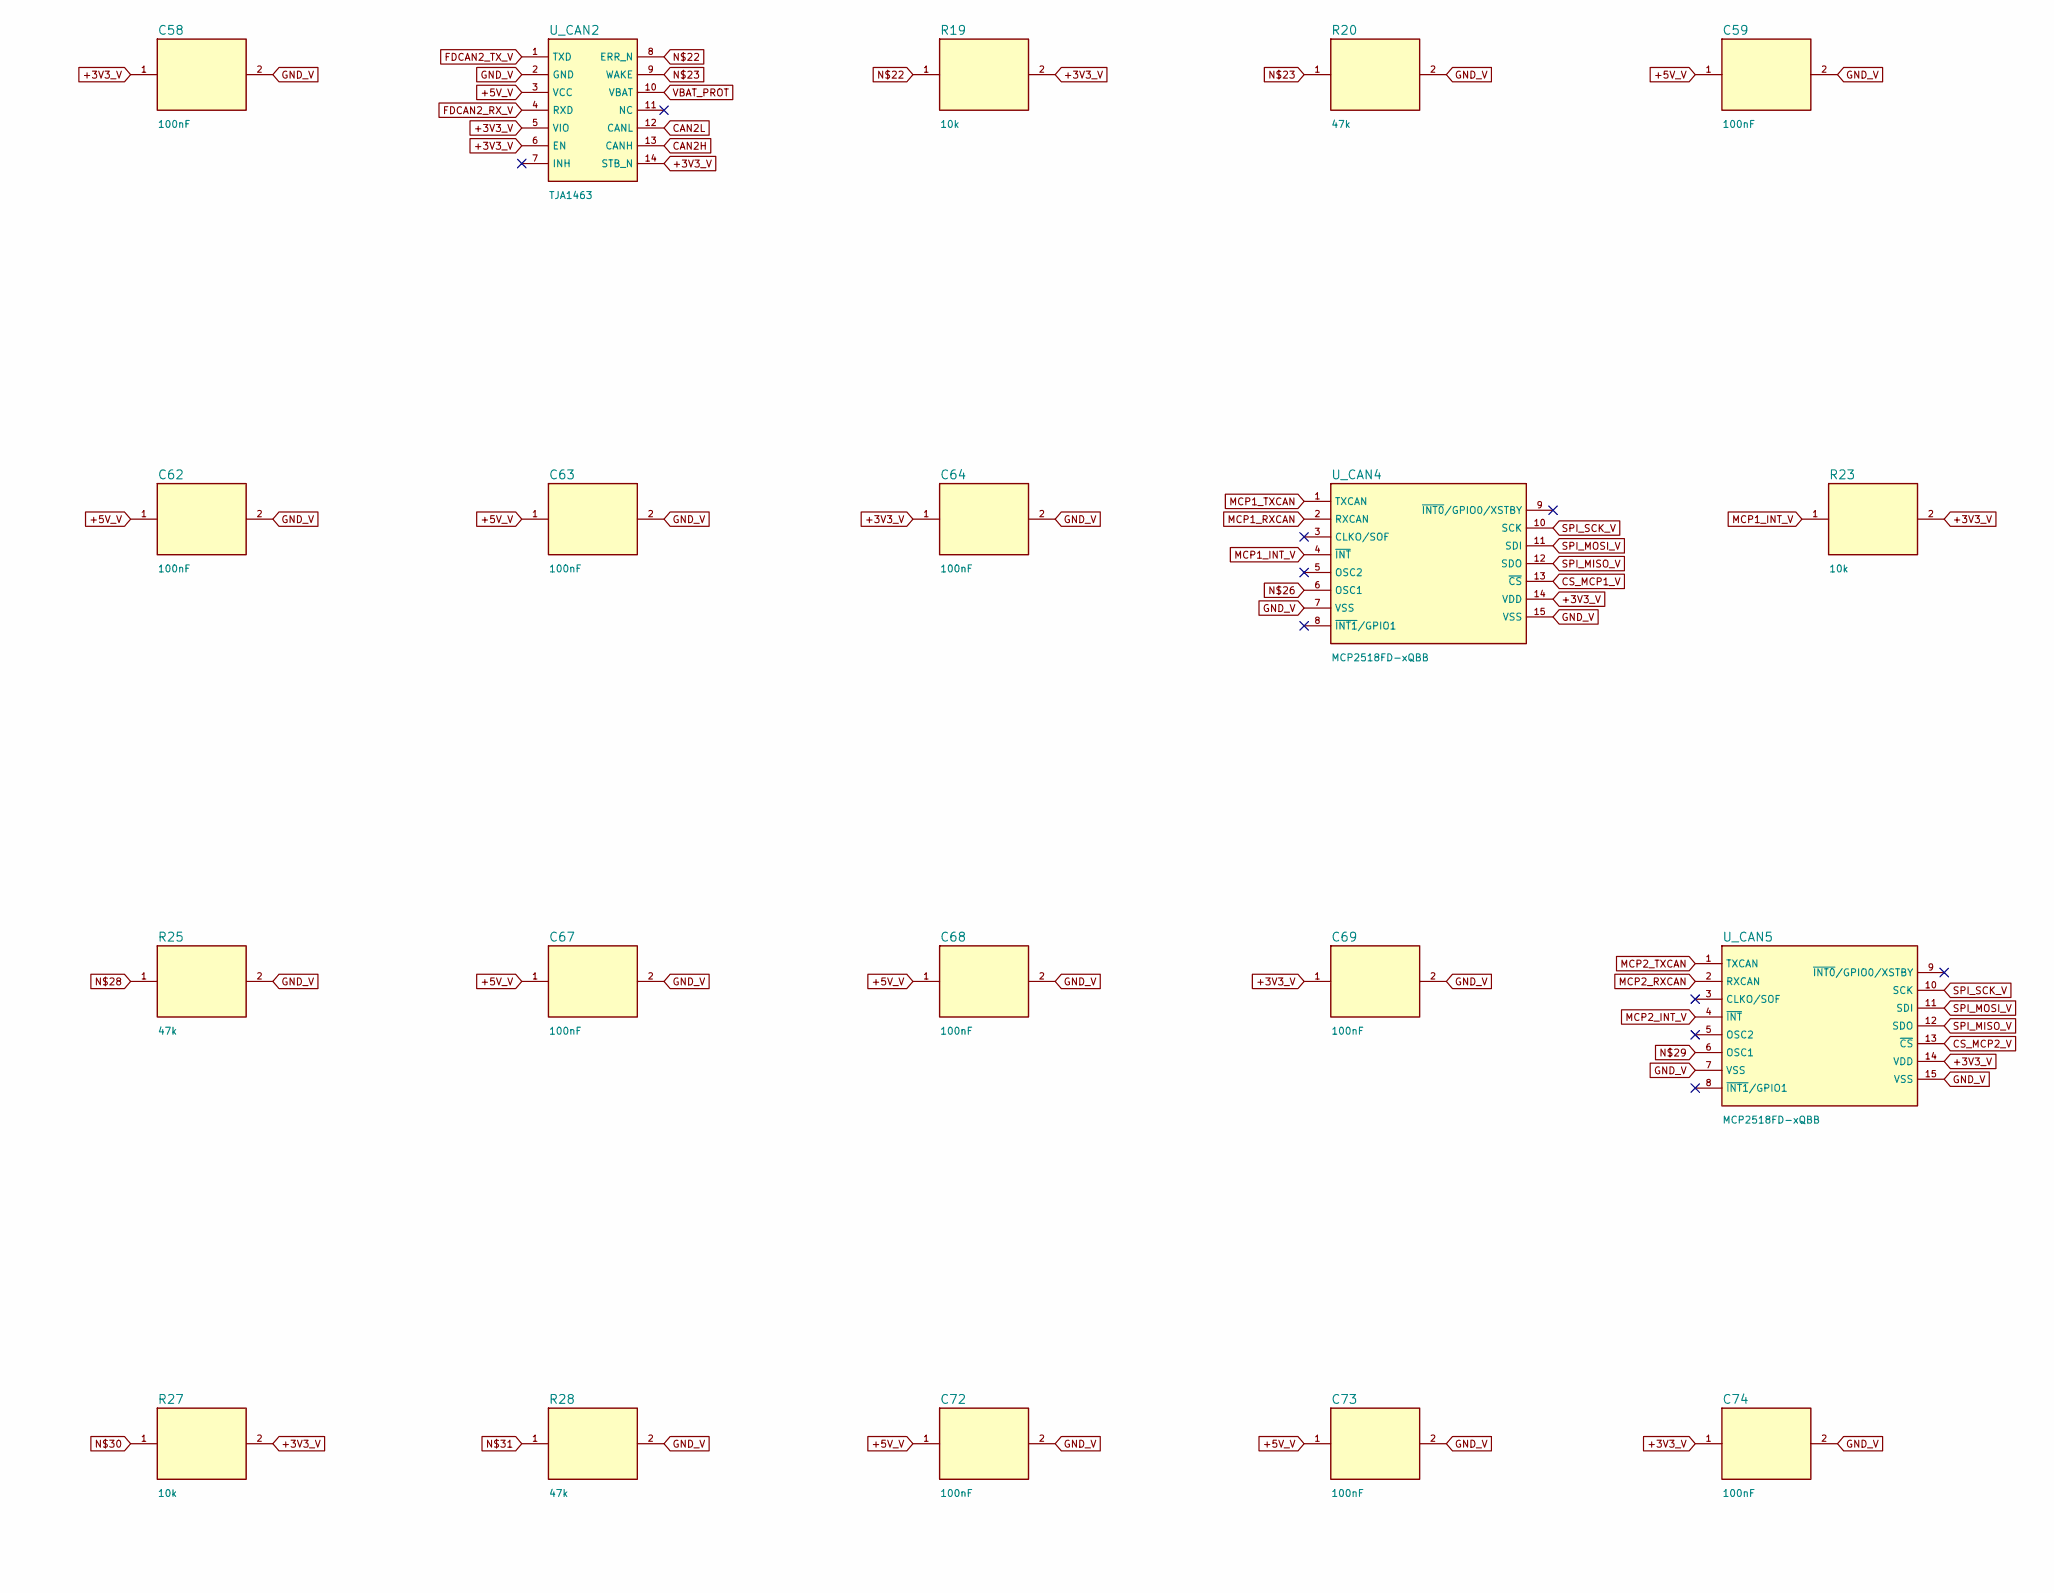
[picture p21: schematic can_fd.kicad_sch, part in row 1, column 2]

Parts:
C56, C57, C58, C59, C60, C61, C62, C63, C64, C65, C66, C67, C68, C69, C70, C71, C72, C73, C74: 100nF; C_0603_1608Metric
R17, R19, R21, R23, R24, R26, R27: 10k; R_0603_1608Metric
R18, R20, R22, R25, R28: 47k; R_0603_1608Metric
U_CAN1, U_CAN2, U_CAN3, U_CAN4T, U_CAN5T: TJA1463; SOIC-14_3.9x8.7mm_P1.27mm
U_CAN4, U_CAN5: MCP2518FD-xQBB; SOIC-14_3.9x8.7mm_P1.27mm
X_CAN1, X_CAN2: 40MHz; Oscillator_SMD_Abracon_ASE-4Pin_3.2x2.5mm

Connections:
+3V3_V: C58.1, C61.1, C64.1, C65.1, C66.1, C69.1, C70.1, C71.1, C74.1, R17.2, R19.2, R21.2, R23.2, R24.2, R26.2, R27.2, U_CAN1.5 (VIO), U_CAN1.6 (EN), U_CAN1.14 (STB_N), U_CAN2.5 (VIO), U_CAN2.6 (EN), U_CAN2.14 (STB_N), U_CAN3.5 (VIO), U_CAN3.6 (EN), U_CAN3.14 (STB_N), U_CAN4.14 (VDD), U_CAN4T.5 (VIO), U_CAN4T.6 (EN), U_CAN4T.14 (STB_N), U_CAN5.14 (VDD), U_CAN5T.5 (VIO), U_CAN5T.6 (EN), U_CAN5T.14 (STB_N), X_CAN1.1 (EN), X_CAN1.4 (VCC), X_CAN2.1 (EN), X_CAN2.4 (VCC)
+5V_V: C56.1, C57.1, C59.1, C60.1, C62.1, C63.1, C67.1, C68.1, C72.1, C73.1, U_CAN1.3 (VCC), U_CAN2.3 (VCC), U_CAN3.3 (VCC), U_CAN4T.3 (VCC), U_CAN5T.3 (VCC)
CAN1H: U_CAN1.13 (CANH)
CAN1L: U_CAN1.12 (CANL)
CAN2H: U_CAN2.13 (CANH)
CAN2L: U_CAN2.12 (CANL)
CAN3H: U_CAN3.13 (CANH)
CAN3L: U_CAN3.12 (CANL)
CAN4H: U_CAN4T.13 (CANH)
CAN4L: U_CAN4T.12 (CANL)
CAN5H: U_CAN5T.13 (CANH)
CAN5L: U_CAN5T.12 (CANL)
CS_MCP1_V: U_CAN4.13 (~CS)
CS_MCP2_V: U_CAN5.13 (~CS)
FDCAN1_RX_V: U_CAN1.4 (RXD)
FDCAN1_TX_V: U_CAN1.1 (TXD)
FDCAN2_RX_V: U_CAN2.4 (RXD)
FDCAN2_TX_V: U_CAN2.1 (TXD)
FDCAN3_RX_V: U_CAN3.4 (RXD)
FDCAN3_TX_V: U_CAN3.1 (TXD)
GND_V: C56.2, C57.2, C58.2, C59.2, C60.2, C61.2, C62.2, C63.2, C64.2, C65.2, C66.2, C67.2, C68.2, C69.2, C70.2, C71.2, C72.2, C73.2, C74.2, R18.2, R20.2, R22.2, R25.2, R28.2, U_CAN1.2 (GND), U_CAN2.2 (GND), U_CAN3.2 (GND), U_CAN4.7 (VSS), U_CAN4.15 (VSS), U_CAN4T.2 (GND), U_CAN5.7 (VSS), U_CAN5.15 (VSS), U_CAN5T.2 (GND), X_CAN1.2 (GND), X_CAN2.2 (GND)
MCP1_INT_V: R23.1, U_CAN4.4 (~INT)
MCP1_RXCAN: U_CAN4.2 (RXCAN), U_CAN4T.4 (RXD)
MCP1_TXCAN: U_CAN4.1 (TXCAN), U_CAN4T.1 (TXD)
MCP2_INT_V: R26.1, U_CAN5.4 (~INT)
MCP2_RXCAN: U_CAN5.2 (RXCAN), U_CAN5T.4 (RXD)
MCP2_TXCAN: U_CAN5.1 (TXCAN), U_CAN5T.1 (TXD)
unnamed: R17.1, U_CAN1.8 (ERR_N)
unnamed: R18.1, U_CAN1.9 (WAKE)
unnamed: R19.1, U_CAN2.8 (ERR_N)
unnamed: R20.1, U_CAN2.9 (WAKE)
unnamed: R21.1, U_CAN3.8 (ERR_N)
unnamed: R22.1, U_CAN3.9 (WAKE)
unnamed: U_CAN4.6 (OSC1), X_CAN1.3 (OUT)
unnamed: R24.1, U_CAN4T.8 (ERR_N)
unnamed: R25.1, U_CAN4T.9 (WAKE)
unnamed: U_CAN5.6 (OSC1), X_CAN2.3 (OUT)
unnamed: R27.1, U_CAN5T.8 (ERR_N)
unnamed: R28.1, U_CAN5T.9 (WAKE)
SPI_MISO_V: U_CAN4.12 (SDO), U_CAN5.12 (SDO)
SPI_MOSI_V: U_CAN4.11 (SDI), U_CAN5.11 (SDI)
SPI_SCK_V: U_CAN4.10 (SCK), U_CAN5.10 (SCK)
VBAT_PROT: U_CAN1.10 (VBAT), U_CAN2.10 (VBAT), U_CAN3.10 (VBAT), U_CAN4T.10 (VBAT), U_CAN5T.10 (VBAT)
