OmniboxCreator/OmniBox/hardware/omnibox-v1/sheets/connector_db25.kicad_sch

## KiCad design hardware/omnibox-v1/sheets/connector_db25.kicad_sch (2026-07-20)

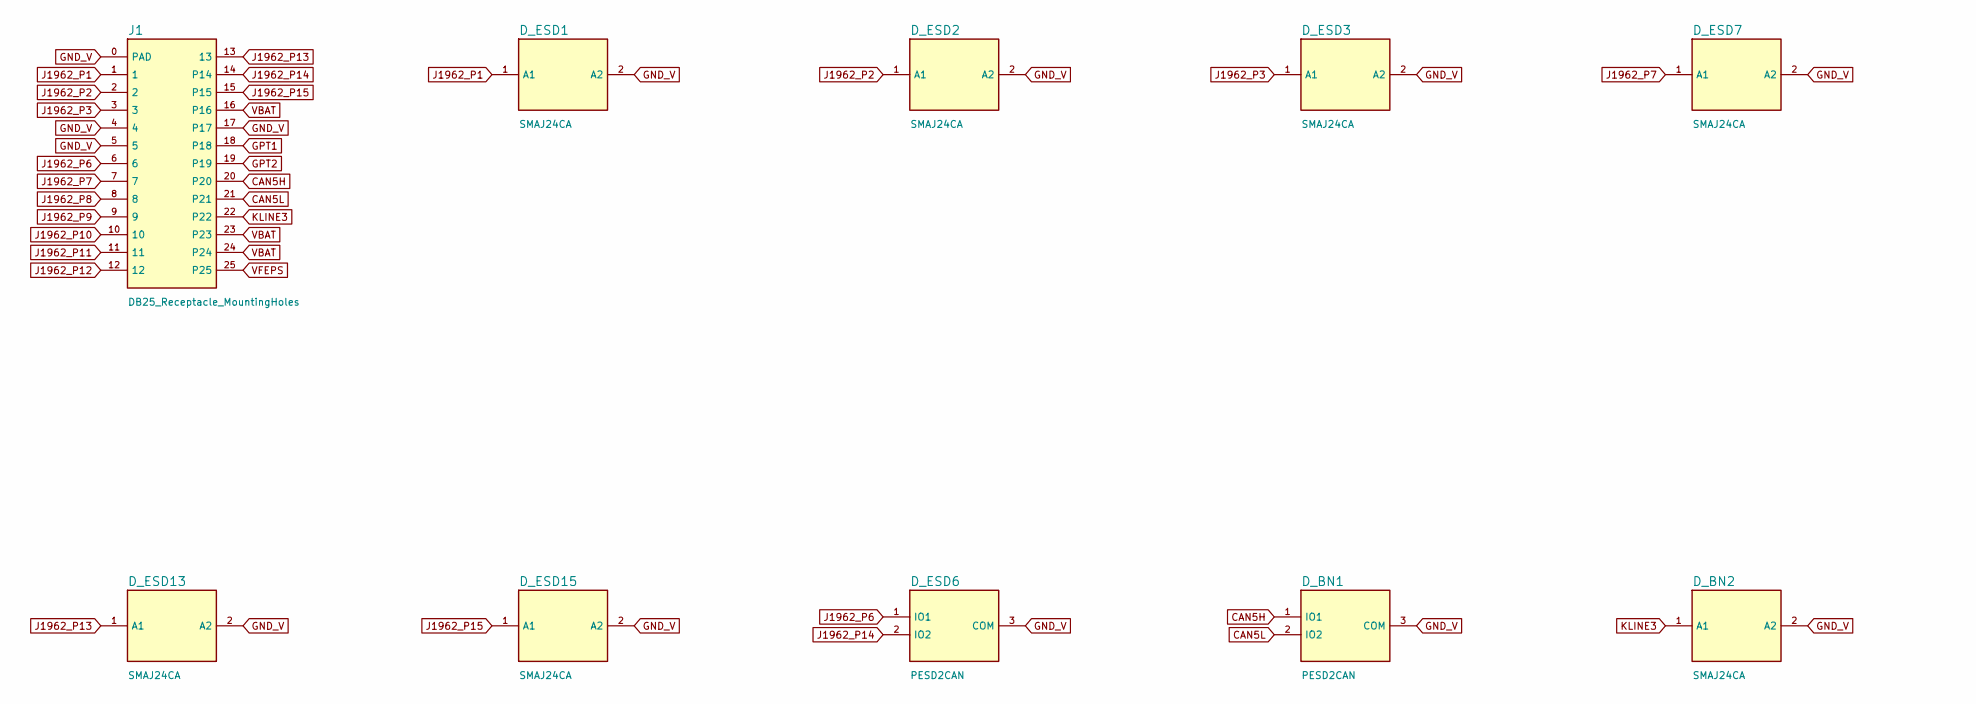
[picture p22: schematic connector_db25.kicad_sch, part in row 1, column 1]

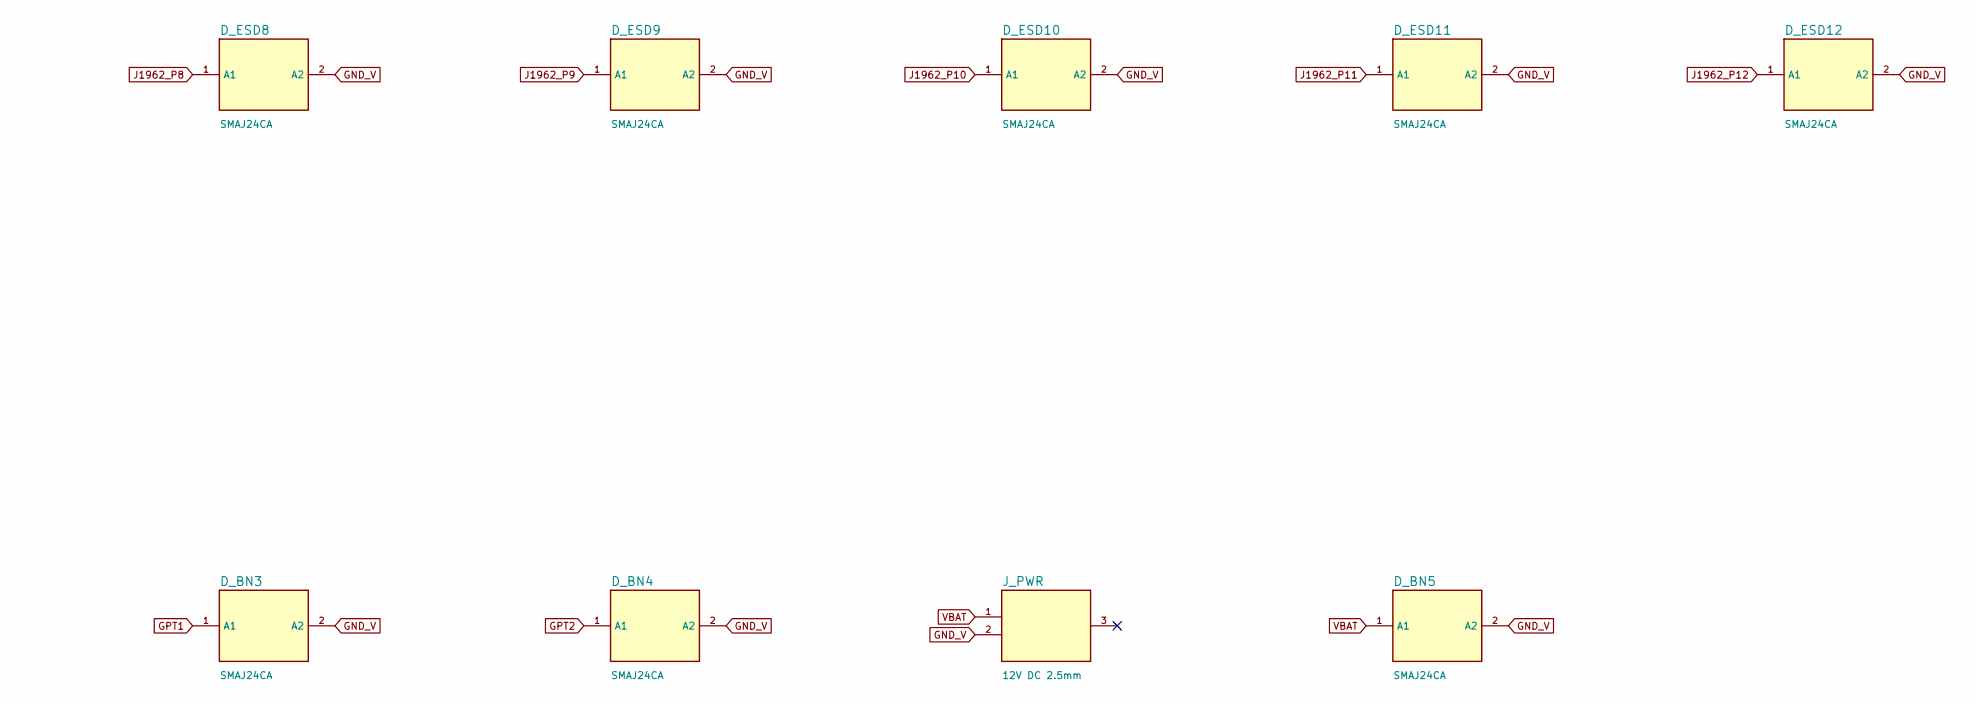
[picture p23: schematic connector_db25.kicad_sch, part in row 1, column 2]

Parts:
D_BN1: PESD2CAN; SOT-23
D_BN2, D_BN3, D_BN4, D_BN5: SMAJ24CA; D_SMB
D_ESD1, D_ESD2, D_ESD3, D_ESD7, D_ESD8, D_ESD9, D_ESD10, D_ESD11, D_ESD12, D_ESD13, D_ESD15: SMAJ24CA; D_SMB
D_ESD6: PESD2CAN; SOT-23
J1: DB25_Receptacle_MountingHoles; DSUB-25_Female_Horizontal_P2.77x2.84mm_EdgePinOffset7.70mm_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
J_PWR: 12V DC 2.5mm; BarrelJack_CUI_PJ-102AH_Horizontal

Connections:
CAN5H: D_BN1.1 (IO1), J1.20
CAN5L: D_BN1.2 (IO2), J1.21
GND_V: D_BN1.3 (COM), D_BN2.2 (A2), D_BN3.2 (A2), D_BN4.2 (A2), D_BN5.2 (A2), D_ESD1.2 (A2), D_ESD2.2 (A2), D_ESD3.2 (A2), D_ESD6.3 (COM), D_ESD7.2 (A2), D_ESD8.2 (A2), D_ESD9.2 (A2), D_ESD10.2 (A2), D_ESD11.2 (A2), D_ESD12.2 (A2), D_ESD13.2 (A2), D_ESD15.2 (A2), J1.0 (PAD), J1.4, J1.5, J1.17, J_PWR.2
GPT1: D_BN3.1 (A1), J1.18
GPT2: D_BN4.1 (A1), J1.19
J1962_P1: D_ESD1.1 (A1), J1.1
J1962_P2: D_ESD2.1 (A1), J1.2
J1962_P3: D_ESD3.1 (A1), J1.3
J1962_P6: D_ESD6.1 (IO1), J1.6
J1962_P7: D_ESD7.1 (A1), J1.7
J1962_P8: D_ESD8.1 (A1), J1.8
J1962_P9: D_ESD9.1 (A1), J1.9
J1962_P10: D_ESD10.1 (A1), J1.10
J1962_P11: D_ESD11.1 (A1), J1.11
J1962_P12: D_ESD12.1 (A1), J1.12
J1962_P13: D_ESD13.1 (A1), J1.13
J1962_P14: D_ESD6.2 (IO2), J1.14
J1962_P15: D_ESD15.1 (A1), J1.15
KLINE3: D_BN2.1 (A1), J1.22
VBAT: D_BN5.1 (A1), J1.16, J1.23, J1.24, J_PWR.1
VFEPS: J1.25
