OmniboxCreator/OmniBox/hardware/omnibox-v1/sheets/feps.kicad_sch

## KiCad design hardware/omnibox-v1/sheets/feps.kicad_sch (2026-07-20)

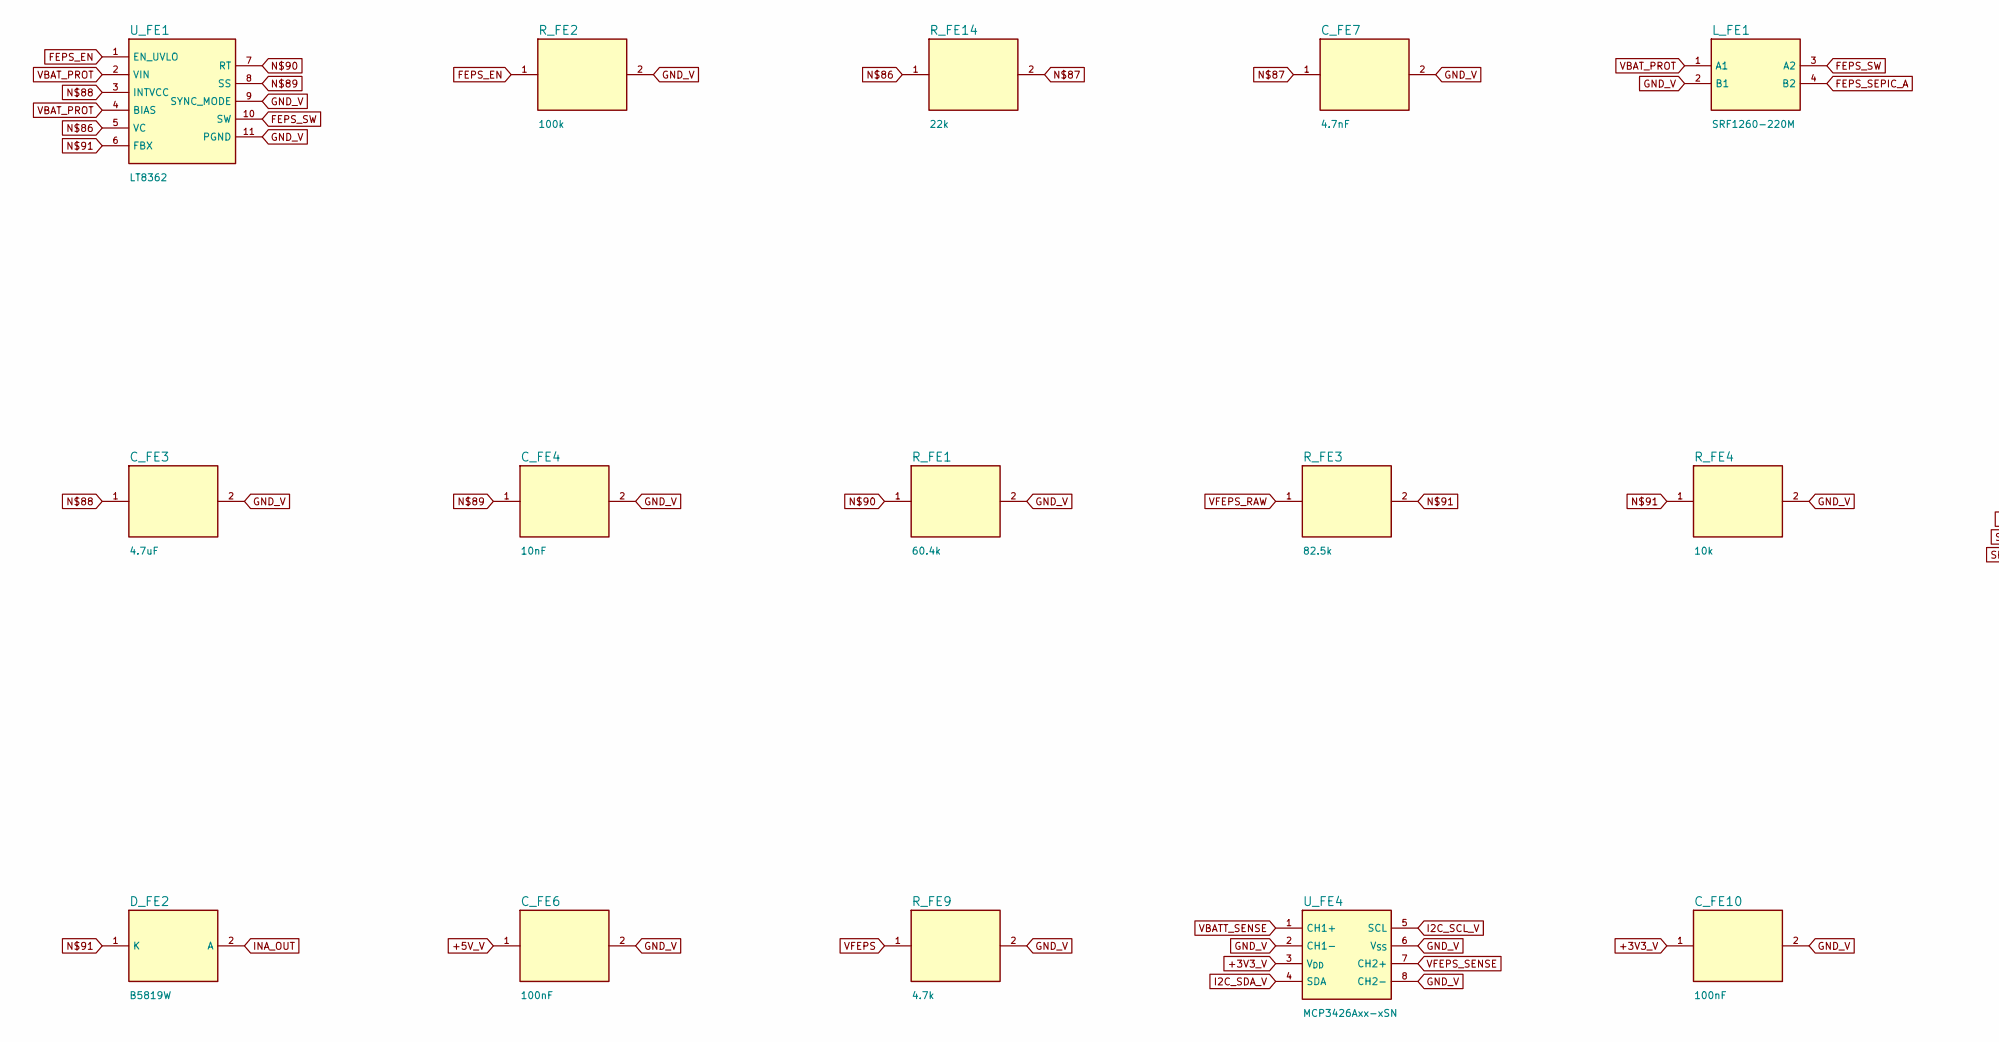
[picture p24: schematic feps.kicad_sch, part in row 1, column 1]

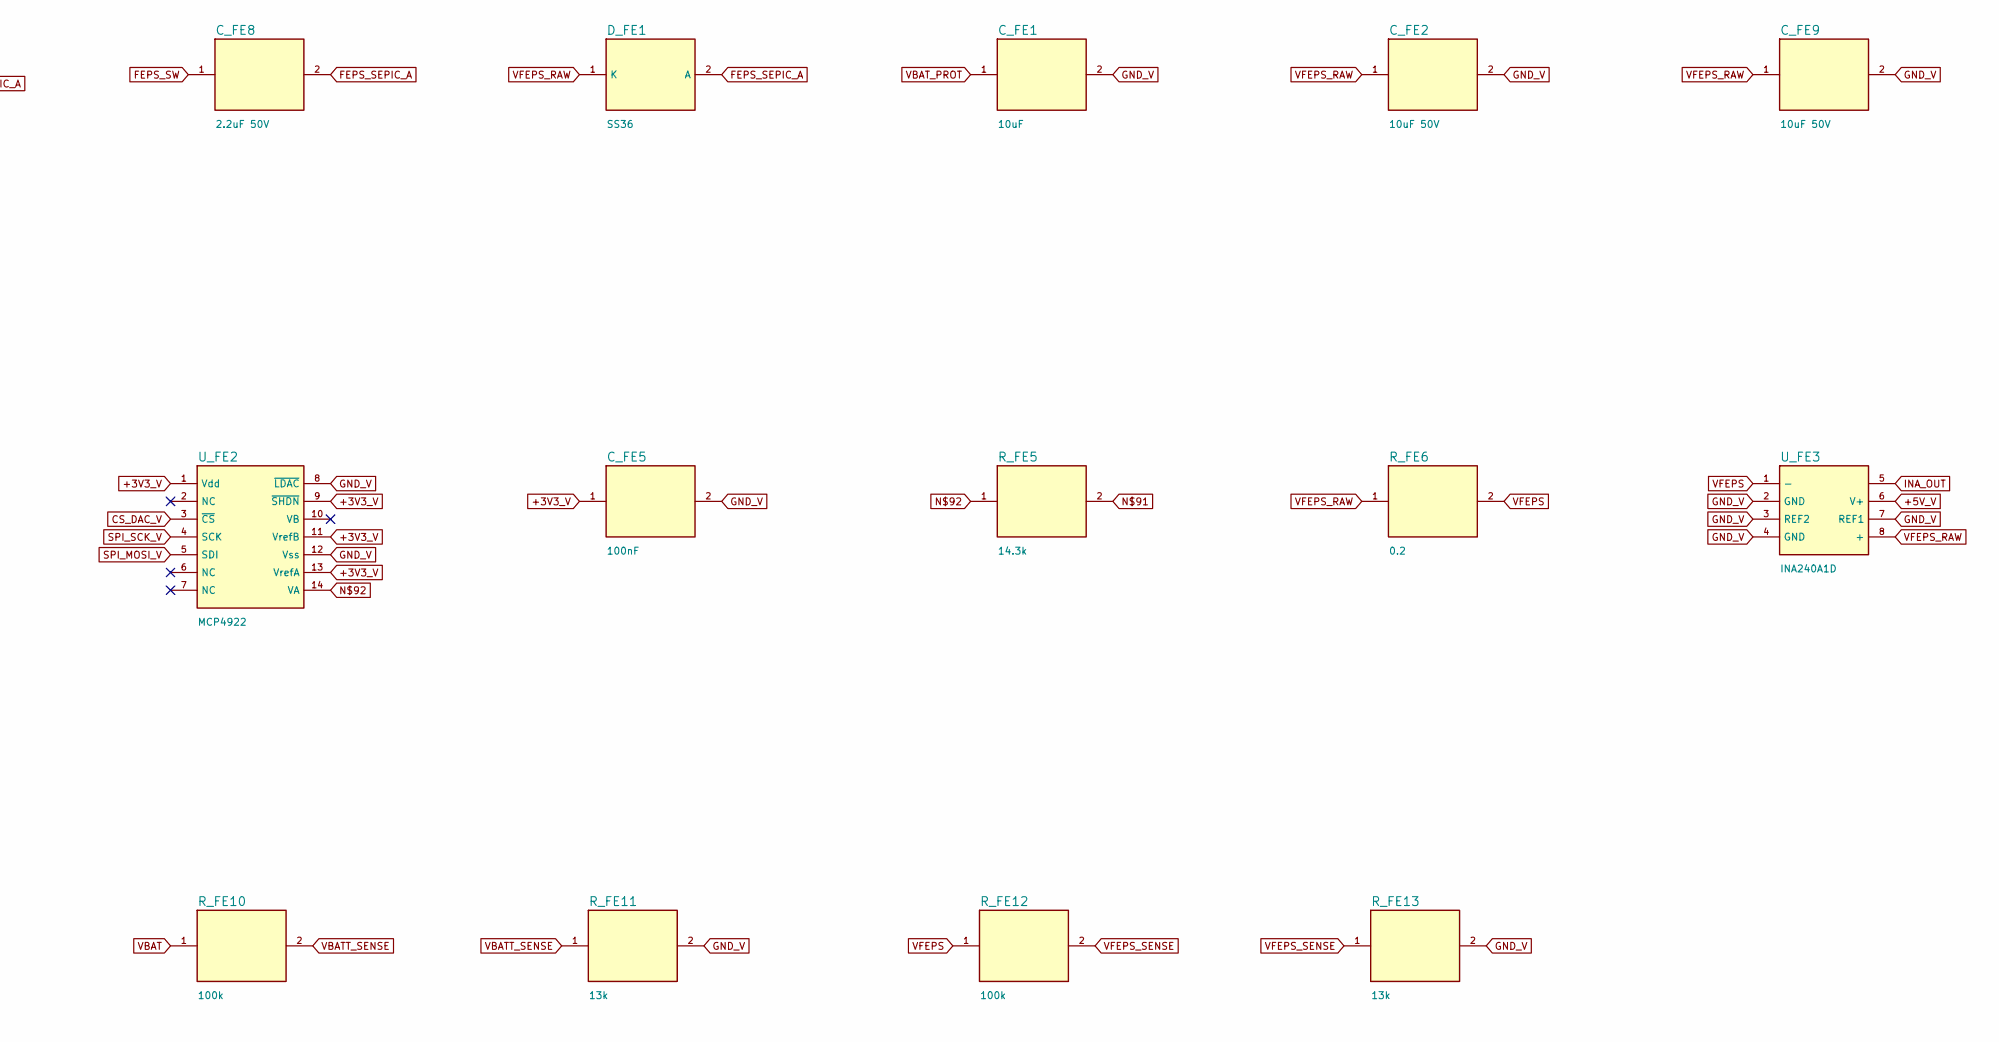
[picture p25: schematic feps.kicad_sch, part in row 1, column 2]

Parts:
C_FE1: 10uF; C_0805_2012Metric
C_FE2, C_FE9: 10uF 50V; C_1210_3225Metric
C_FE3: 4.7uF; C_0603_1608Metric
C_FE4: 10nF; C_0603_1608Metric
C_FE5, C_FE6, C_FE10: 100nF; C_0603_1608Metric
C_FE7: 4.7nF; C_0603_1608Metric
C_FE8: 2.2uF 50V; C_1210_3225Metric
D_FE1: SS36; D_SMA
D_FE2: B5819W; D_SOD-123
L_FE1: SRF1260-220M; L_Coupled_1260
R_FE1: 60.4k; R_0603_1608Metric
R_FE2, R_FE10, R_FE12: 100k; R_0603_1608Metric
R_FE3: 82.5k; R_0603_1608Metric
R_FE4: 10k; R_0603_1608Metric
R_FE5: 14.3k; R_0603_1608Metric
R_FE6: 0.2; R_2512_6332Metric
R_FE9: 4.7k; R_1206_3216Metric
R_FE11, R_FE13: 13k; R_0603_1608Metric
R_FE14: 22k; R_0603_1608Metric
U_FE1: LT8362; DFN-10-1EP_3x3mm_P0.5mm_EP1.65x2.38mm
U_FE2: MCP4922; SOIC-14_3.9x8.7mm_P1.27mm
U_FE3: INA240A1D; SOIC-8_3.9x4.9mm_P1.27mm
U_FE4: MCP3426Axx-xSN; SOIC-8_3.9x4.9mm_P1.27mm

Connections:
+3V3_V: C_FE5.1, C_FE10.1, U_FE2.1 (Vdd), U_FE2.9 (~SHDN), U_FE2.11 (VrefB), U_FE2.13 (VrefA), U_FE4.3 (V_{DD})
+5V_V: C_FE6.1, U_FE3.6 (V+)
CS_DAC_V: U_FE2.3 (~CS)
FEPS_EN: R_FE2.1, U_FE1.1 (EN_UVLO)
FEPS_SEPIC_A: C_FE8.2, D_FE1.2 (A), L_FE1.4 (B2)
FEPS_SW: C_FE8.1, L_FE1.3 (A2), U_FE1.10 (SW)
GND_V: C_FE1.2, C_FE2.2, C_FE3.2, C_FE4.2, C_FE5.2, C_FE6.2, C_FE7.2, C_FE9.2, C_FE10.2, L_FE1.2 (B1), R_FE1.2, R_FE2.2, R_FE4.2, R_FE9.2, R_FE11.2, R_FE13.2, U_FE1.9 (SYNC_MODE), U_FE1.11 (PGND), U_FE2.8 (~LDAC), U_FE2.12 (Vss), U_FE3.2 (GND), U_FE3.3 (REF2), U_FE3.4 (GND), U_FE3.7 (REF1), U_FE4.2 (CH1-), U_FE4.6 (V_{SS}), U_FE4.8 (CH2-)
I2C_SCL_V: U_FE4.5 (SCL)
I2C_SDA_V: U_FE4.4 (SDA)
INA_OUT: D_FE2.2 (A), U_FE3.5
unnamed: R_FE14.1, U_FE1.5 (VC)
unnamed: C_FE7.1, R_FE14.2
unnamed: C_FE3.1, U_FE1.3 (INTVCC)
unnamed: C_FE4.1, U_FE1.8 (SS)
unnamed: R_FE1.1, U_FE1.7 (RT)
unnamed: D_FE2.1 (K), R_FE3.2, R_FE4.1, R_FE5.2, U_FE1.6 (FBX)
unnamed: R_FE5.1, U_FE2.14 (VA)
SPI_MOSI_V: U_FE2.5 (SDI)
SPI_SCK_V: U_FE2.4 (SCK)
VBAT: R_FE10.1
VBATT_SENSE: R_FE10.2, R_FE11.1, U_FE4.1 (CH1+)
VBAT_PROT: C_FE1.1, L_FE1.1 (A1), U_FE1.2 (VIN), U_FE1.4 (BIAS)
VFEPS: R_FE6.2, R_FE9.1, R_FE12.1, U_FE3.1 (-)
VFEPS_RAW: C_FE2.1, C_FE9.1, D_FE1.1 (K), R_FE3.1, R_FE6.1, U_FE3.8 (+)
VFEPS_SENSE: R_FE12.2, R_FE13.1, U_FE4.7 (CH2+)
