OmniboxCreator/OmniBox/hardware/omnibox-v1/sheets/isolation_barrier.kicad_sch

## KiCad design hardware/omnibox-v1/sheets/isolation_barrier.kicad_sch (2026-07-20)

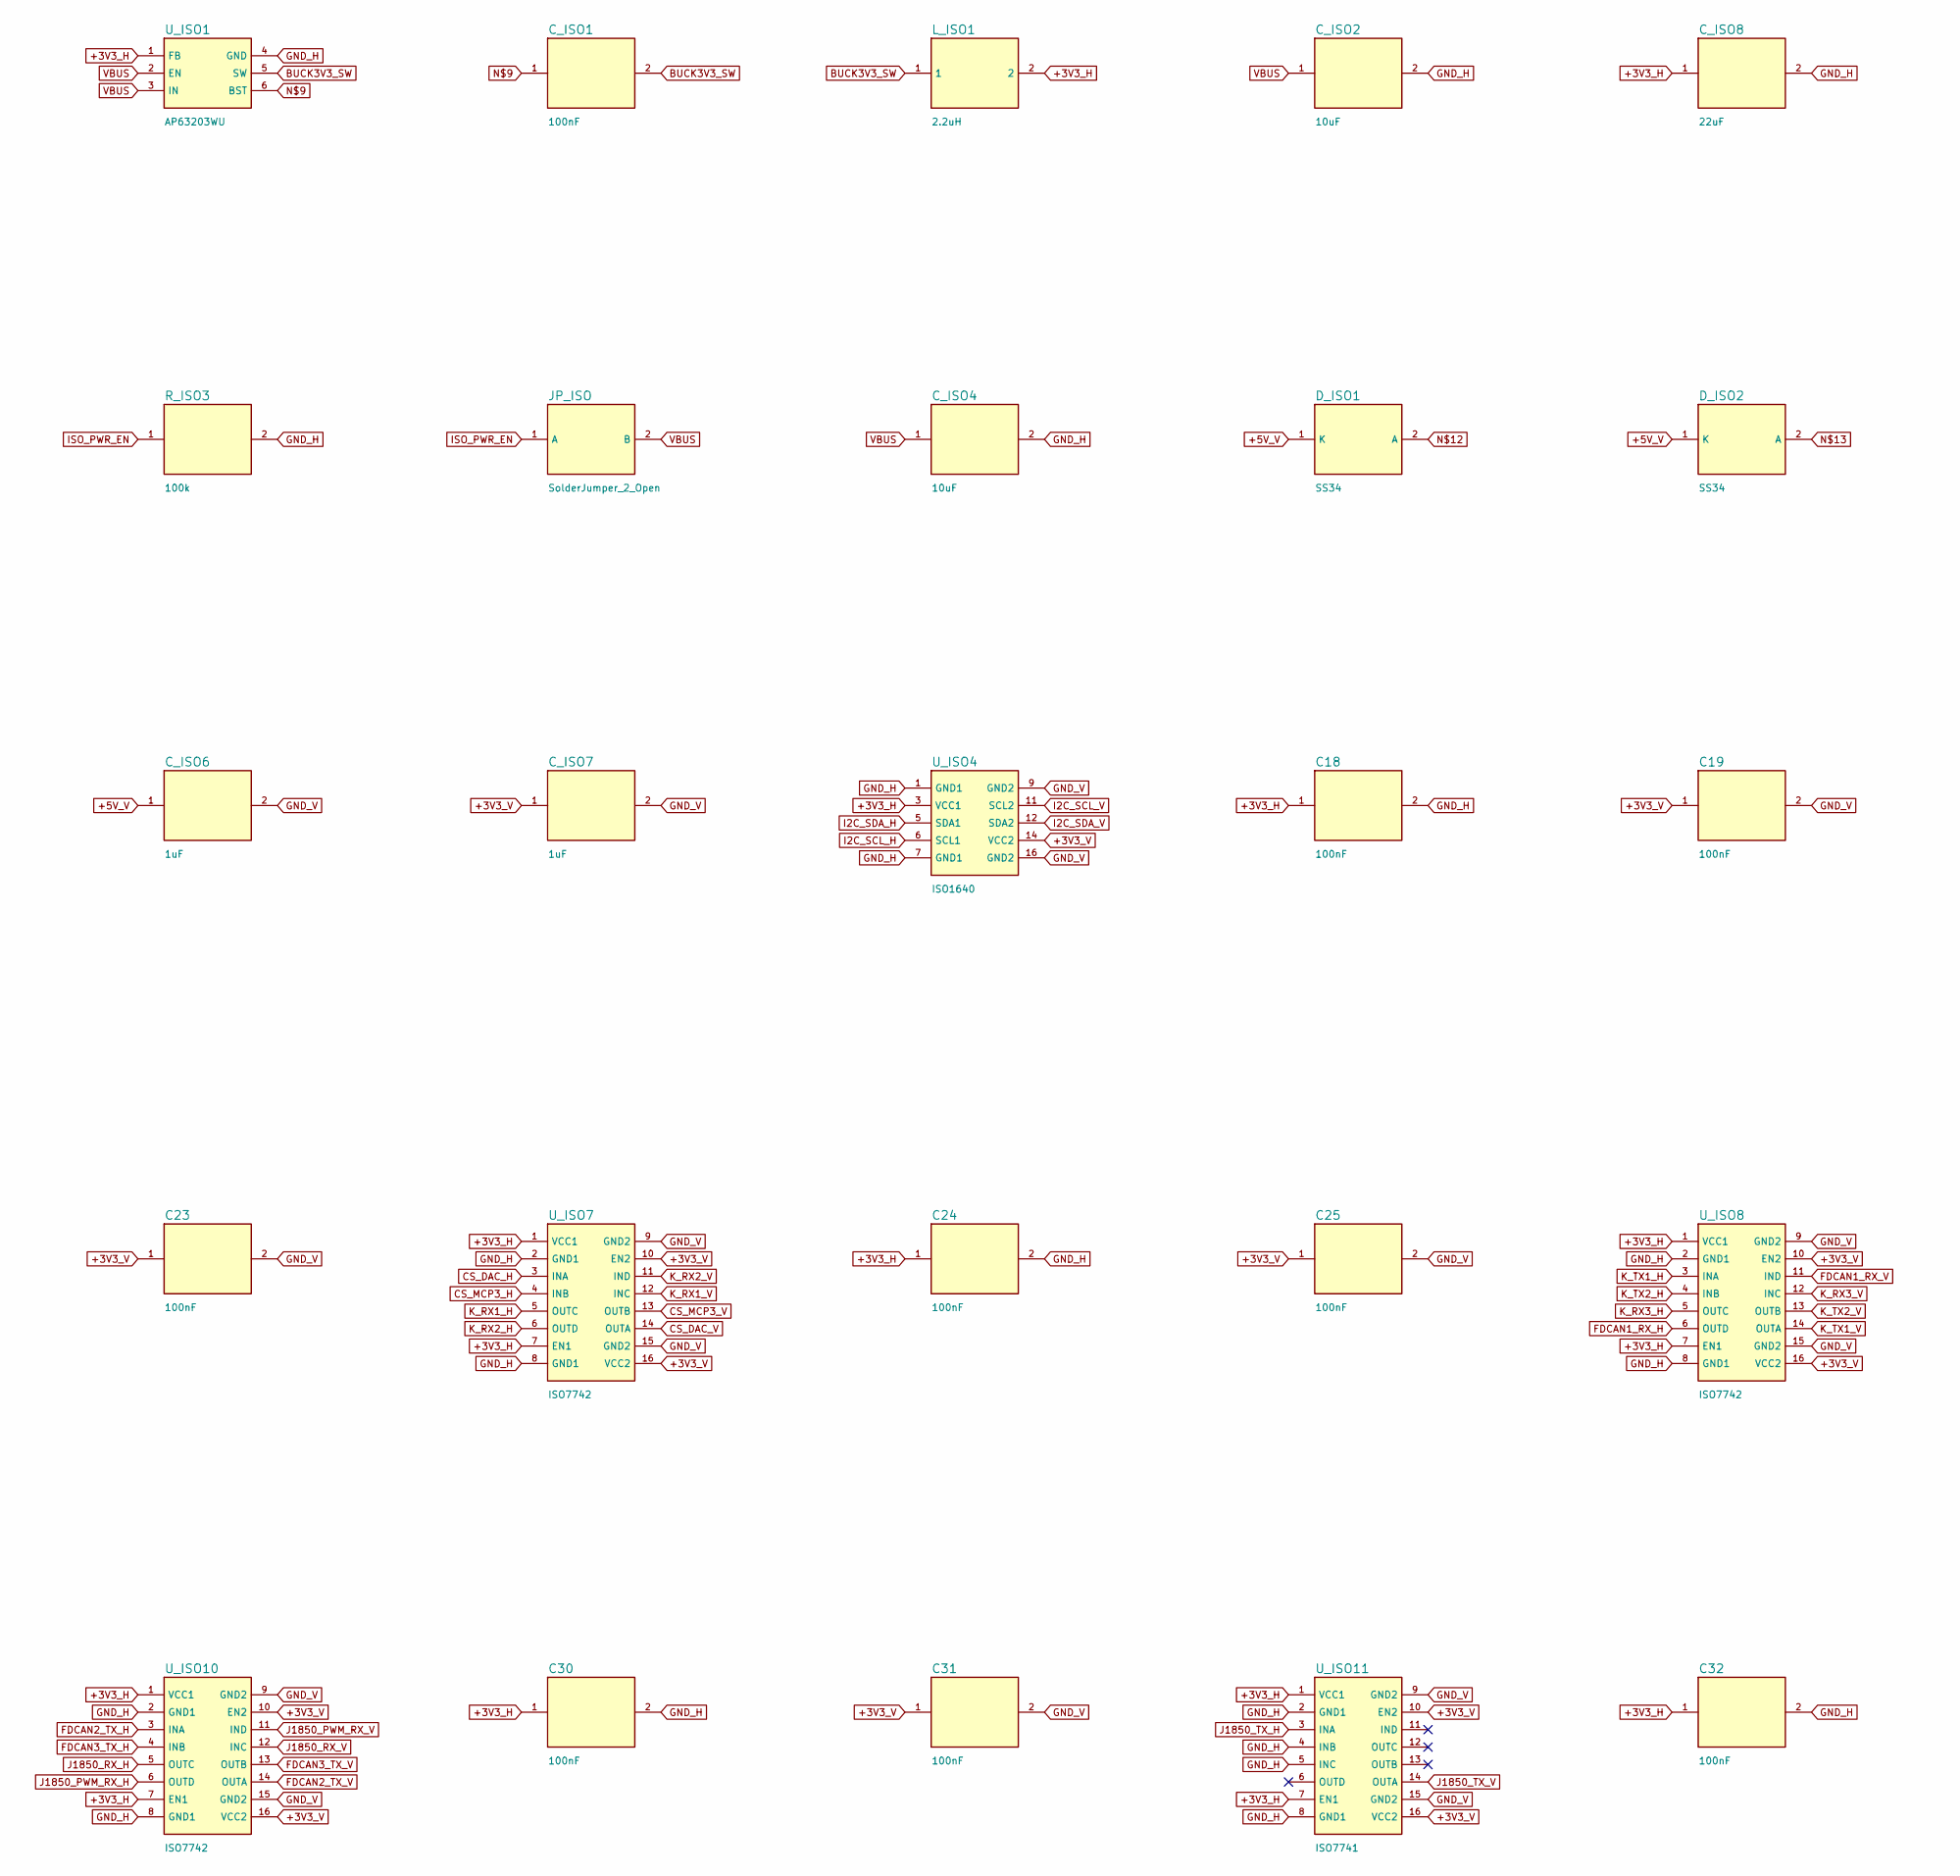
[picture p26: schematic isolation_barrier.kicad_sch, part in row 1, column 1]

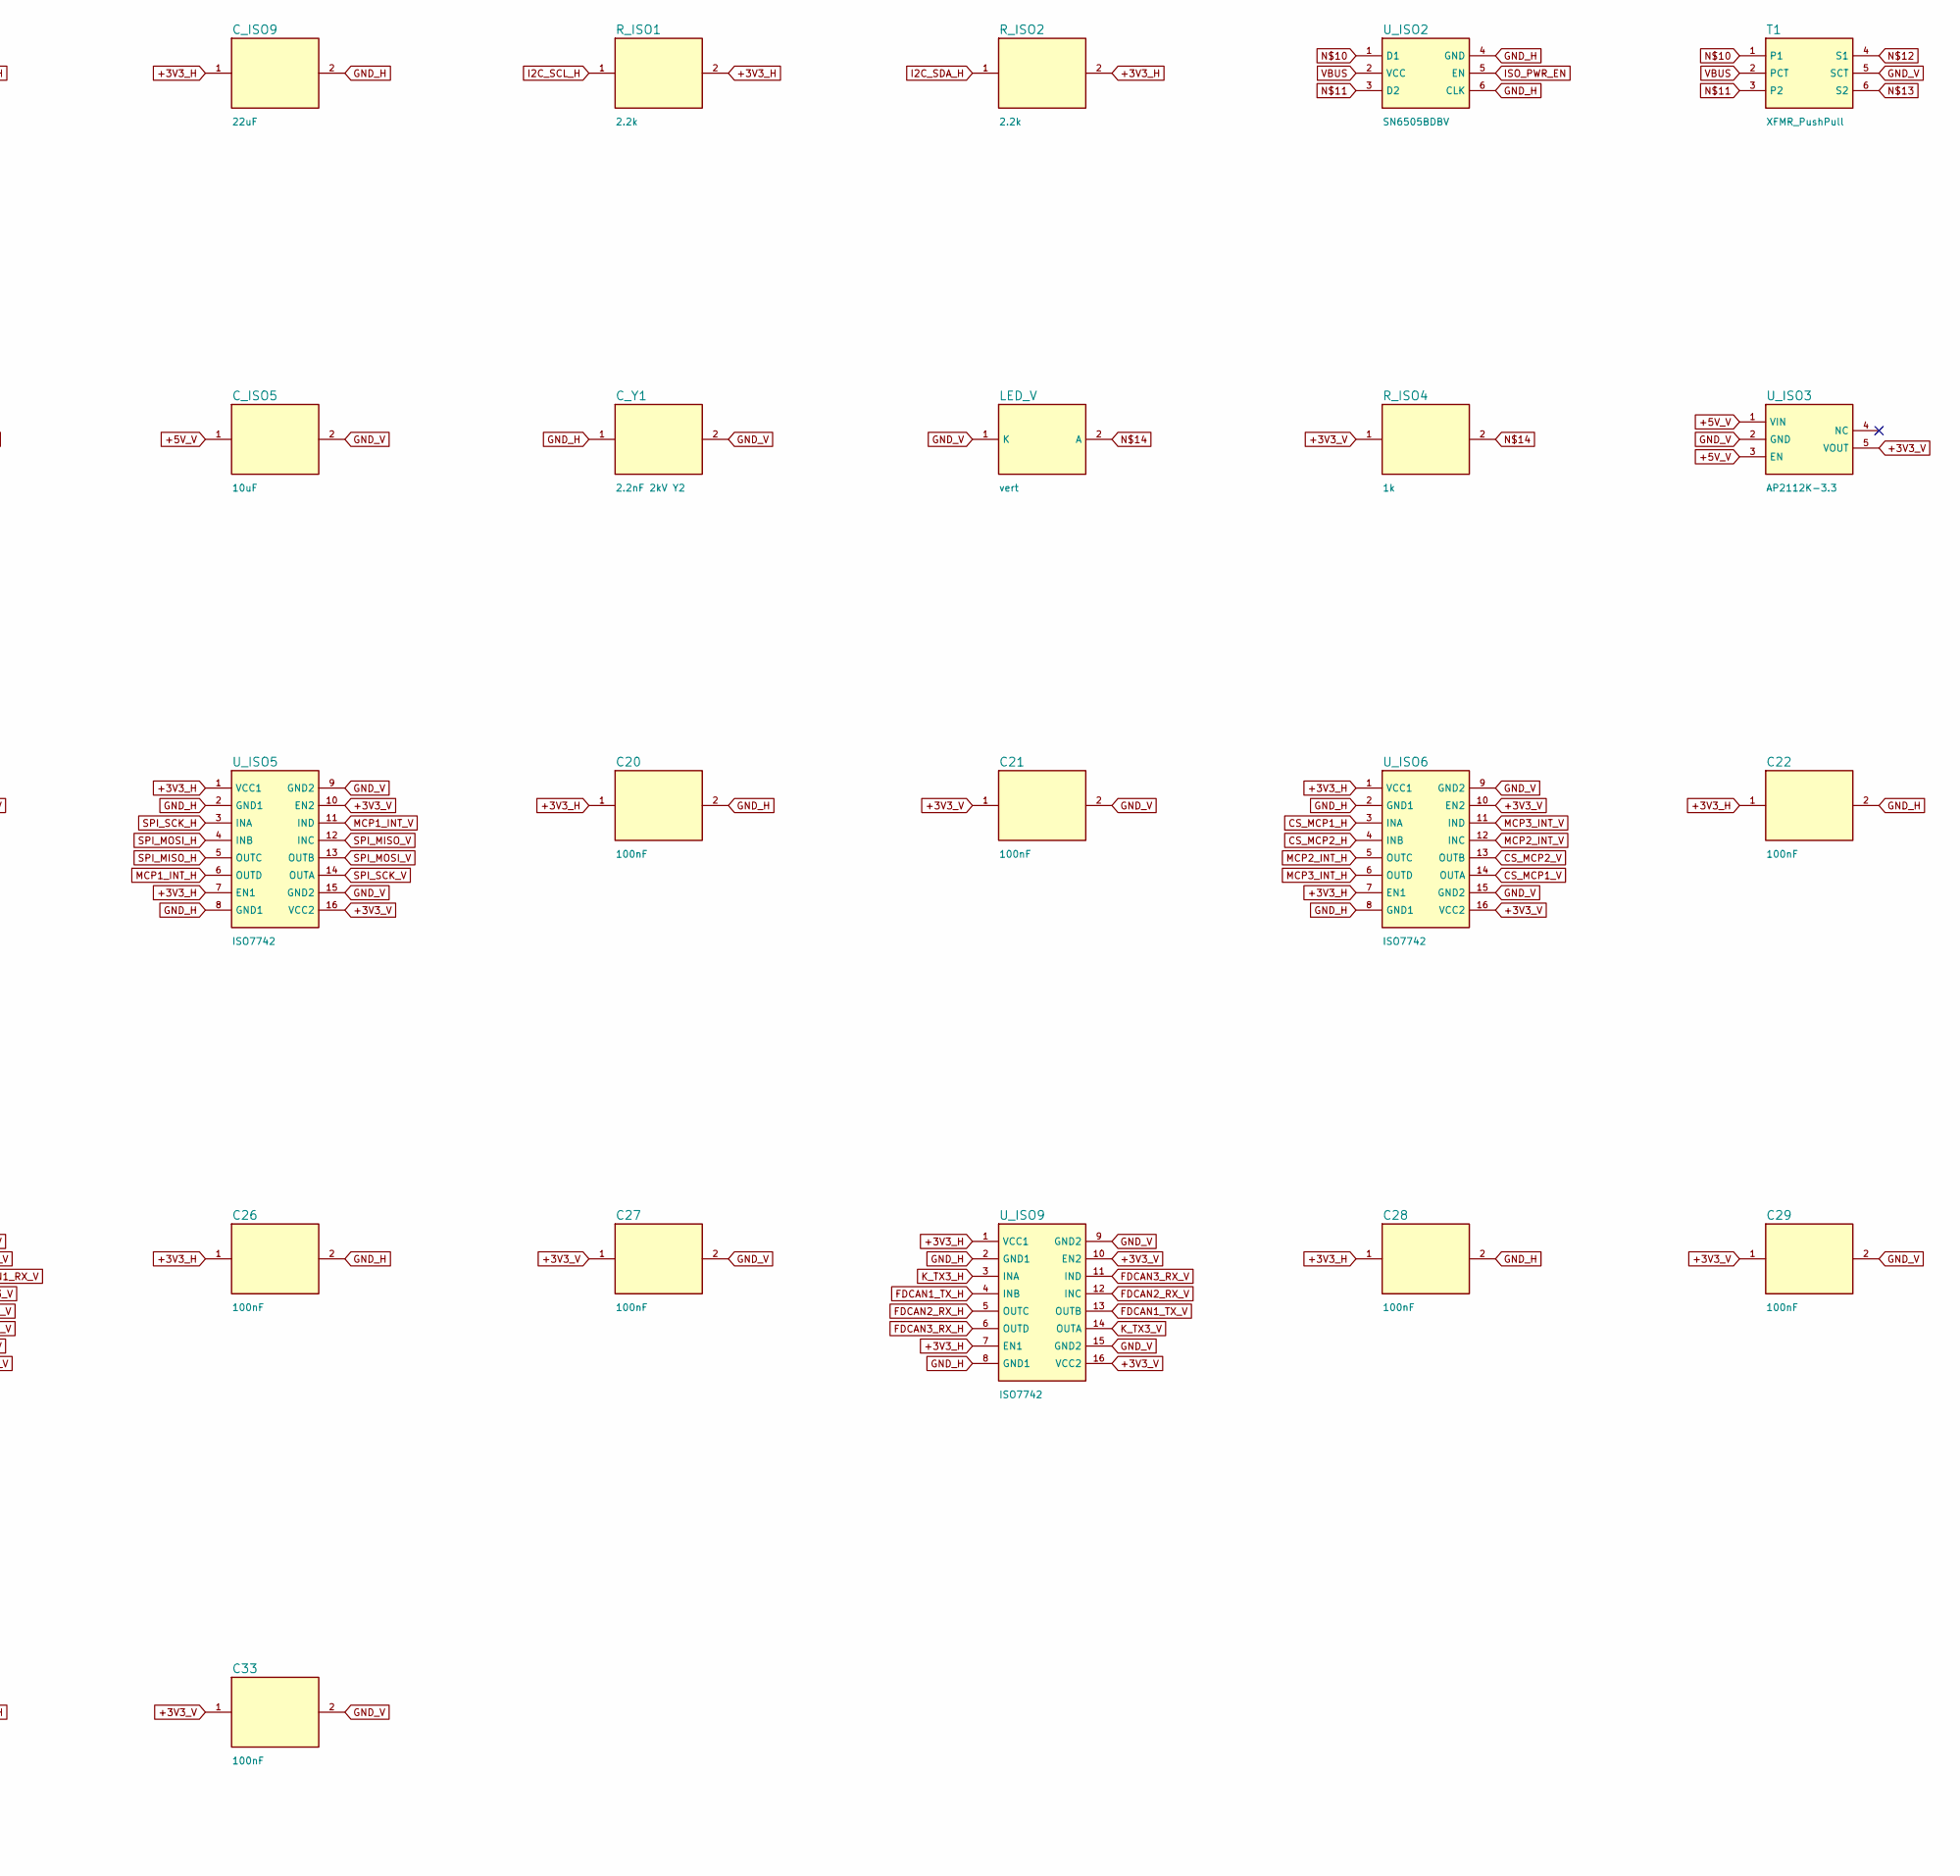
[picture p27: schematic isolation_barrier.kicad_sch, part in row 1, column 2]

Parts:
C18, C19, C20, C21, C22, C23, C24, C25, C26, C27, C28, C29, C30, C31, C32, C33: 100nF; C_0603_1608Metric
C_ISO1: 100nF; C_0603_1608Metric
C_ISO2: 10uF; C_0805_2012Metric
C_ISO4, C_ISO5: 10uF; C_0603_1608Metric
C_ISO6, C_ISO7: 1uF; C_0603_1608Metric
C_ISO8, C_ISO9: 22uF; C_0805_2012Metric
C_Y1: 2.2nF 2kV Y2; C_1812_4532Metric
D_ISO1, D_ISO2: SS34; D_SMA
JP_ISO: SolderJumper_2_Open; SolderJumper-2_P1.3mm_Open_Pad1.0x1.5mm
LED_V: vert; LED_0603_1608Metric
L_ISO1: 2.2uH; L_Taiyo-Yuden_NR-40xx
R_ISO1, R_ISO2: 2.2k; R_0603_1608Metric
R_ISO3: 100k; R_0603_1608Metric
R_ISO4: 1k; R_0603_1608Metric
T1: XFMR_PushPull; Transformer_Wuerth_750315371
U_ISO1: AP63203WU; TSOT-23-6
U_ISO2: SN6505BDBV; SOT-23-6
U_ISO3: AP2112K-3.3; SOT-23-5
U_ISO4: ISO1640; SOIC-16W_7.5x10.3mm_P1.27mm
U_ISO5, U_ISO6, U_ISO7, U_ISO8, U_ISO9, U_ISO10: ISO7742; SOIC-16W_7.5x10.3mm_P1.27mm
U_ISO11: ISO7741; SOIC-16W_7.5x10.3mm_P1.27mm

Connections:
+3V3_H: C18.1, C20.1, C22.1, C24.1, C26.1, C28.1, C30.1, C32.1, C_ISO8.1, C_ISO9.1, L_ISO1.2, R_ISO1.2, R_ISO2.2, U_ISO1.1 (FB), U_ISO4.3 (VCC1), U_ISO5.1 (VCC1), U_ISO5.7 (EN1), U_ISO6.1 (VCC1), U_ISO6.7 (EN1), U_ISO7.1 (VCC1), U_ISO7.7 (EN1), U_ISO8.1 (VCC1), U_ISO8.7 (EN1), U_ISO9.1 (VCC1), U_ISO9.7 (EN1), U_ISO10.1 (VCC1), U_ISO10.7 (EN1), U_ISO11.1 (VCC1), U_ISO11.7 (EN1)
+3V3_V: C19.1, C21.1, C23.1, C25.1, C27.1, C29.1, C31.1, C33.1, C_ISO7.1, R_ISO4.1, U_ISO3.5 (VOUT), U_ISO4.14 (VCC2), U_ISO5.10 (EN2), U_ISO5.16 (VCC2), U_ISO6.10 (EN2), U_ISO6.16 (VCC2), U_ISO7.10 (EN2), U_ISO7.16 (VCC2), U_ISO8.10 (EN2), U_ISO8.16 (VCC2), U_ISO9.10 (EN2), U_ISO9.16 (VCC2), U_ISO10.10 (EN2), U_ISO10.16 (VCC2), U_ISO11.10 (EN2), U_ISO11.16 (VCC2)
+5V_V: C_ISO5.1, C_ISO6.1, D_ISO1.1 (K), D_ISO2.1 (K), U_ISO3.1 (VIN), U_ISO3.3 (EN)
BUCK3V3_SW: C_ISO1.2, L_ISO1.1, U_ISO1.5 (SW)
CS_DAC_H: U_ISO7.3 (INA)
CS_DAC_V: U_ISO7.14 (OUTA)
CS_MCP1_H: U_ISO6.3 (INA)
CS_MCP1_V: U_ISO6.14 (OUTA)
CS_MCP2_H: U_ISO6.4 (INB)
CS_MCP2_V: U_ISO6.13 (OUTB)
CS_MCP3_H: U_ISO7.4 (INB)
CS_MCP3_V: U_ISO7.13 (OUTB)
FDCAN1_RX_H: U_ISO8.6 (OUTD)
FDCAN1_RX_V: U_ISO8.11 (IND)
FDCAN1_TX_H: U_ISO9.4 (INB)
FDCAN1_TX_V: U_ISO9.13 (OUTB)
FDCAN2_RX_H: U_ISO9.5 (OUTC)
FDCAN2_RX_V: U_ISO9.12 (INC)
FDCAN2_TX_H: U_ISO10.3 (INA)
FDCAN2_TX_V: U_ISO10.14 (OUTA)
FDCAN3_RX_H: U_ISO9.6 (OUTD)
FDCAN3_RX_V: U_ISO9.11 (IND)
FDCAN3_TX_H: U_ISO10.4 (INB)
FDCAN3_TX_V: U_ISO10.13 (OUTB)
GND_H: C18.2, C20.2, C22.2, C24.2, C26.2, C28.2, C30.2, C32.2, C_ISO2.2, C_ISO4.2, C_ISO8.2, C_ISO9.2, C_Y1.1, R_ISO3.2, U_ISO1.4 (GND), U_ISO2.4 (GND), U_ISO2.6 (CLK), U_ISO4.1 (GND1), U_ISO4.7 (GND1), U_ISO5.2 (GND1), U_ISO5.8 (GND1), U_ISO6.2 (GND1), U_ISO6.8 (GND1), U_ISO7.2 (GND1), U_ISO7.8 (GND1), U_ISO8.2 (GND1), U_ISO8.8 (GND1), U_ISO9.2 (GND1), U_ISO9.8 (GND1), U_ISO10.2 (GND1), U_ISO10.8 (GND1), U_ISO11.2 (GND1), U_ISO11.4 (INB), U_ISO11.5 (INC), U_ISO11.8 (GND1)
GND_V: C19.2, C21.2, C23.2, C25.2, C27.2, C29.2, C31.2, C33.2, C_ISO5.2, C_ISO6.2, C_ISO7.2, C_Y1.2, LED_V.1 (K), T1.5 (SCT), U_ISO3.2 (GND), U_ISO4.9 (GND2), U_ISO4.16 (GND2), U_ISO5.9 (GND2), U_ISO5.15 (GND2), U_ISO6.9 (GND2), U_ISO6.15 (GND2), U_ISO7.9 (GND2), U_ISO7.15 (GND2), U_ISO8.9 (GND2), U_ISO8.15 (GND2), U_ISO9.9 (GND2), U_ISO9.15 (GND2), U_ISO10.9 (GND2), U_ISO10.15 (GND2), U_ISO11.9 (GND2), U_ISO11.15 (GND2)
I2C_SCL_H: R_ISO1.1, U_ISO4.6 (SCL1)
I2C_SCL_V: U_ISO4.11 (SCL2)
I2C_SDA_H: R_ISO2.1, U_ISO4.5 (SDA1)
I2C_SDA_V: U_ISO4.12 (SDA2)
ISO_PWR_EN: JP_ISO.1 (A), R_ISO3.1, U_ISO2.5 (EN)
J1850_PWM_RX_H: U_ISO10.6 (OUTD)
J1850_PWM_RX_V: U_ISO10.11 (IND)
J1850_RX_H: U_ISO10.5 (OUTC)
J1850_RX_V: U_ISO10.12 (INC)
J1850_TX_H: U_ISO11.3 (INA)
J1850_TX_V: U_ISO11.14 (OUTA)
K_RX1_H: U_ISO7.5 (OUTC)
K_RX1_V: U_ISO7.12 (INC)
K_RX2_H: U_ISO7.6 (OUTD)
K_RX2_V: U_ISO7.11 (IND)
K_RX3_H: U_ISO8.5 (OUTC)
K_RX3_V: U_ISO8.12 (INC)
K_TX1_H: U_ISO8.3 (INA)
K_TX1_V: U_ISO8.14 (OUTA)
K_TX2_H: U_ISO8.4 (INB)
K_TX2_V: U_ISO8.13 (OUTB)
K_TX3_H: U_ISO9.3 (INA)
K_TX3_V: U_ISO9.14 (OUTA)
MCP1_INT_H: U_ISO5.6 (OUTD)
MCP1_INT_V: U_ISO5.11 (IND)
MCP2_INT_H: U_ISO6.5 (OUTC)
MCP2_INT_V: U_ISO6.12 (INC)
MCP3_INT_H: U_ISO6.6 (OUTD)
MCP3_INT_V: U_ISO6.11 (IND)
unnamed: C_ISO1.1, U_ISO1.6 (BST)
unnamed: T1.1, U_ISO2.1 (D1)
unnamed: T1.3 (P2), U_ISO2.3 (D2)
unnamed: D_ISO1.2 (A), T1.4 (S1)
unnamed: D_ISO2.2 (A), T1.6 (S2)
unnamed: LED_V.2 (A), R_ISO4.2
SPI_MISO_H: U_ISO5.5 (OUTC)
SPI_MISO_V: U_ISO5.12 (INC)
SPI_MOSI_H: U_ISO5.4 (INB)
SPI_MOSI_V: U_ISO5.13 (OUTB)
SPI_SCK_H: U_ISO5.3 (INA)
SPI_SCK_V: U_ISO5.14 (OUTA)
VBUS: C_ISO2.1, C_ISO4.1, JP_ISO.2 (B), T1.2 (PCT), U_ISO1.2 (EN), U_ISO1.3 (IN), U_ISO2.2 (VCC)
