OmniboxCreator/OmniBox/hardware/omnibox-v1/sheets/kline.kicad_sch

## KiCad design hardware/omnibox-v1/sheets/kline.kicad_sch (2026-07-20)

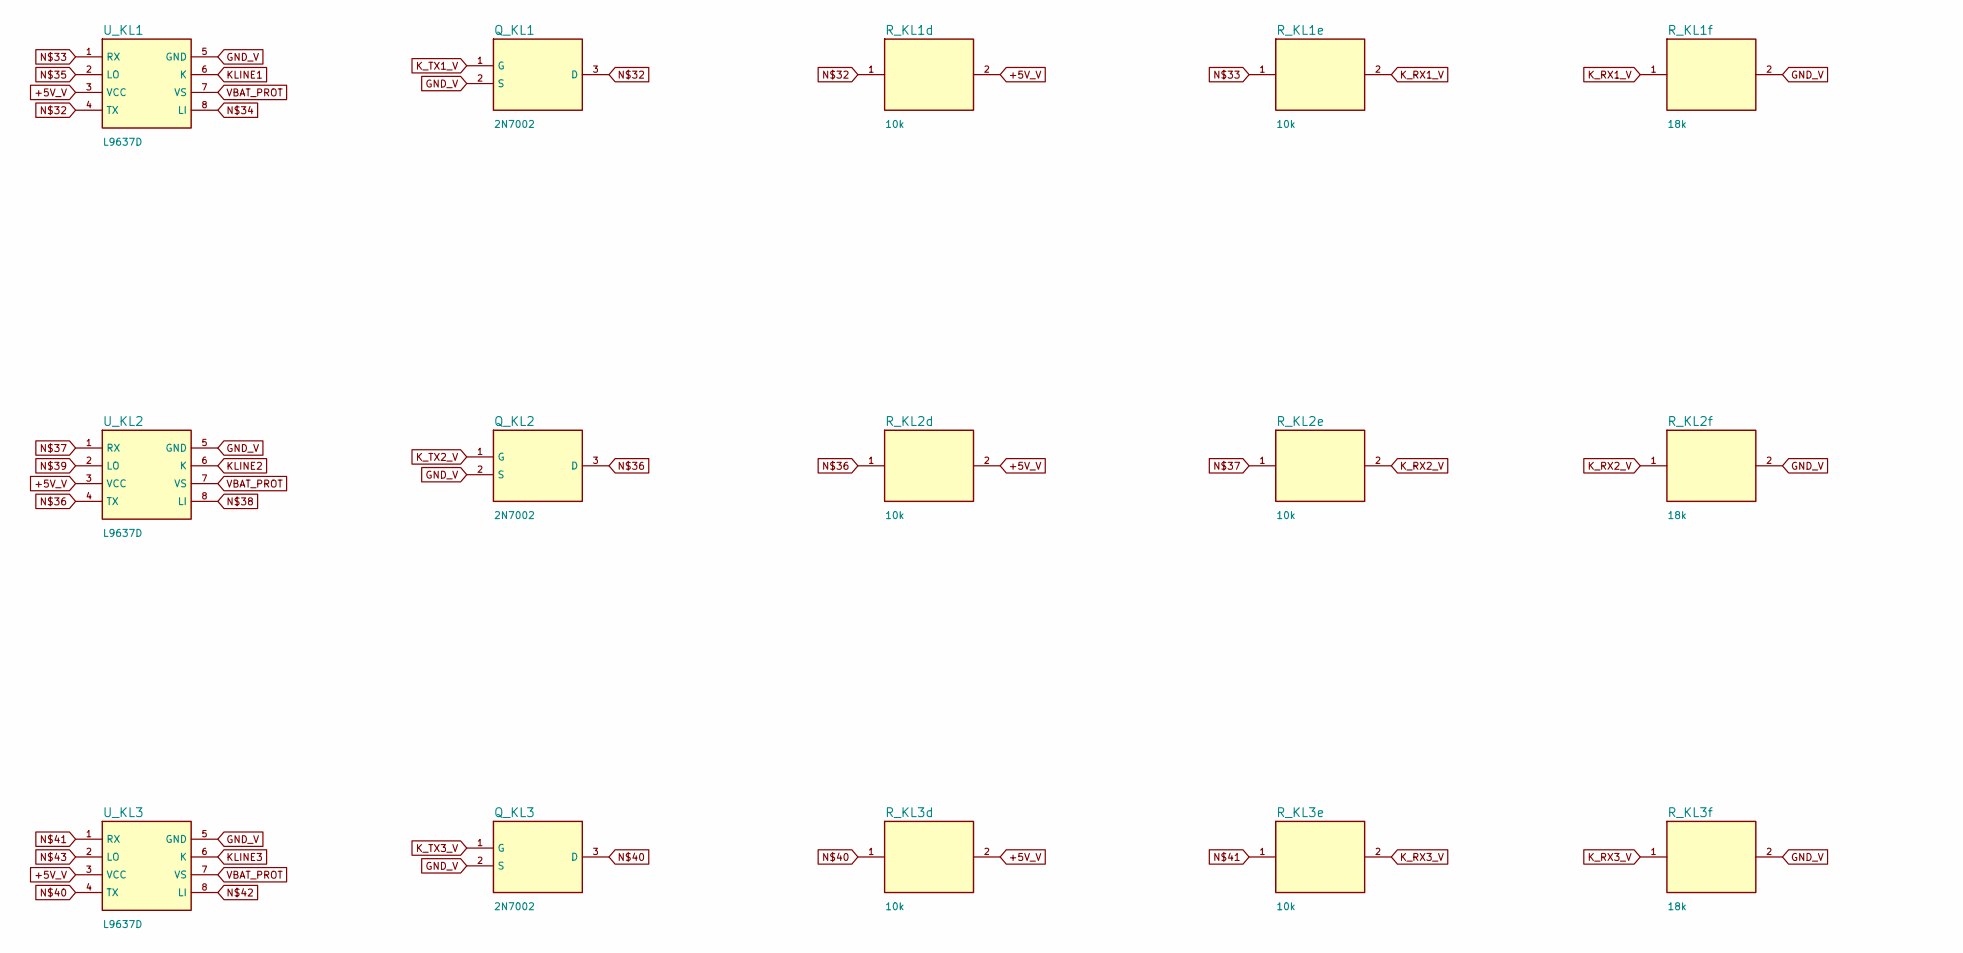
[picture p28: schematic kline.kicad_sch, part in row 1, column 1]

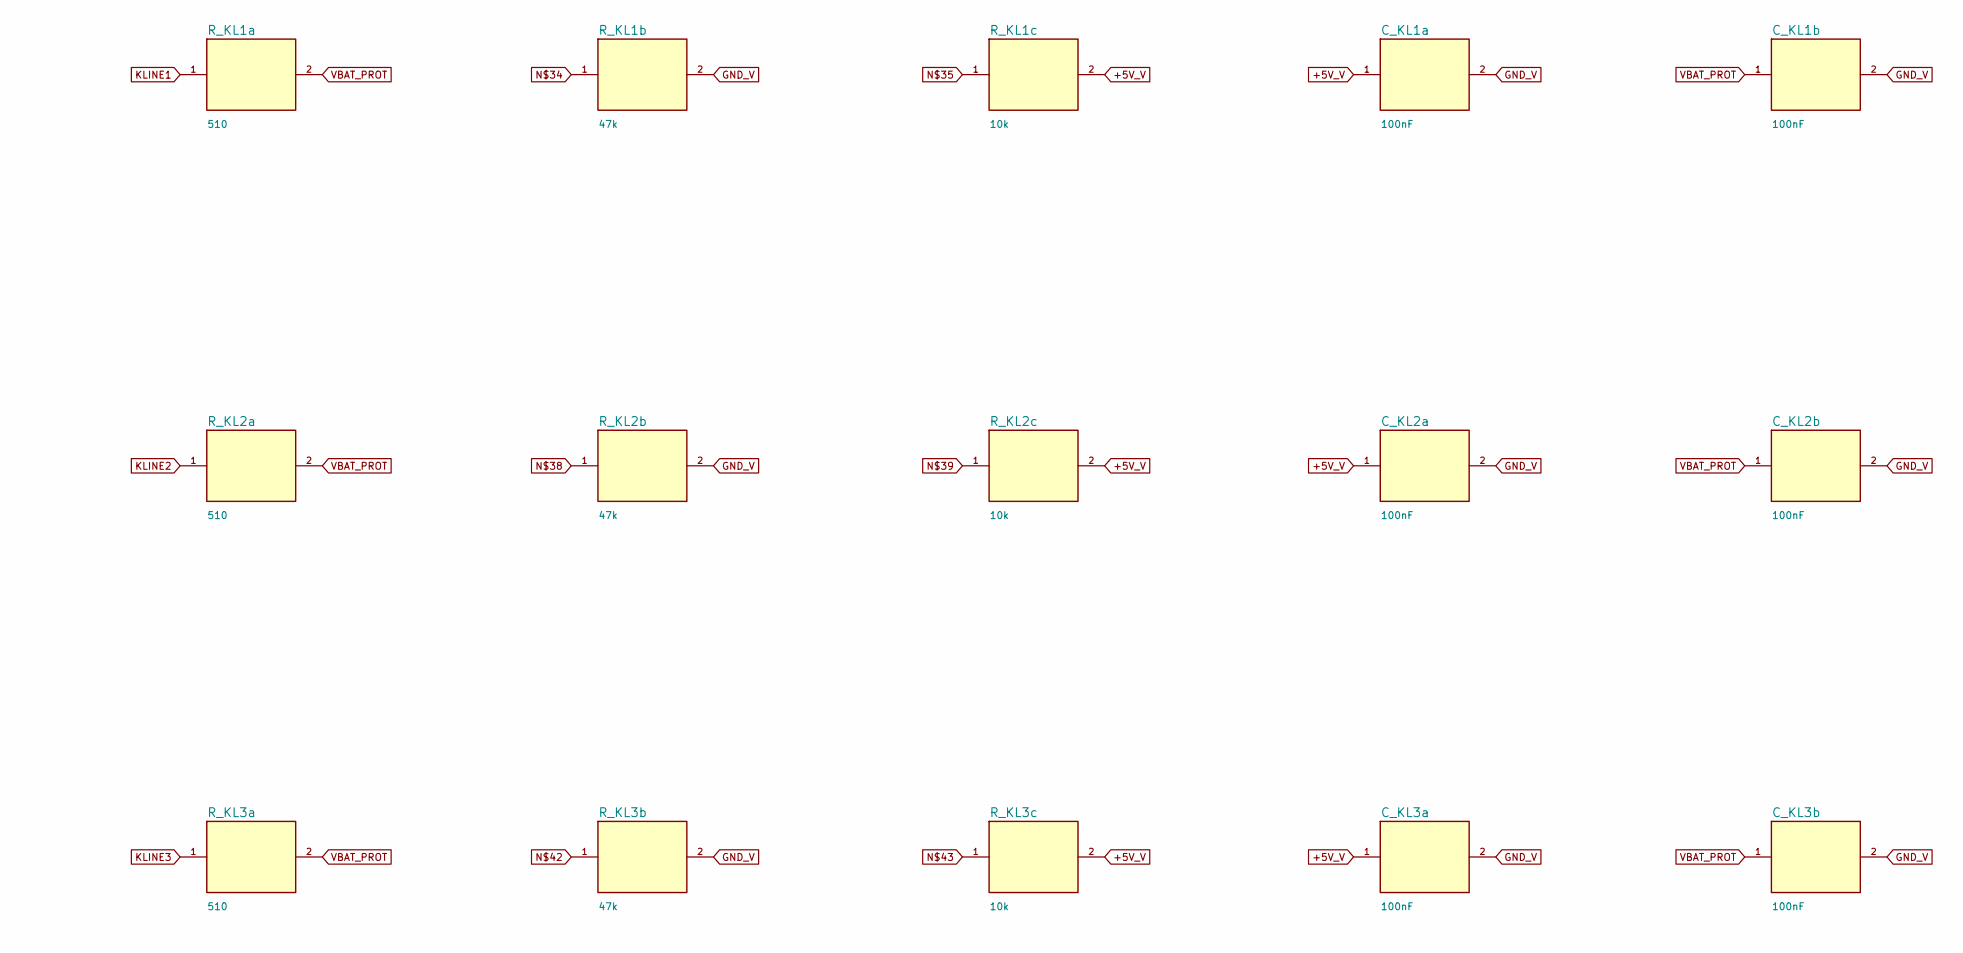
[picture p29: schematic kline.kicad_sch, part in row 1, column 2]

Parts:
C_KL1a, C_KL1b, C_KL2a, C_KL2b, C_KL3a, C_KL3b: 100nF; C_0603_1608Metric
Q_KL1, Q_KL2, Q_KL3: 2N7002; SOT-23
R_KL1a, R_KL2a, R_KL3a: 510; R_0603_1608Metric
R_KL1b, R_KL2b, R_KL3b: 47k; R_0603_1608Metric
R_KL1c, R_KL1d, R_KL1e, R_KL2c, R_KL2d, R_KL2e, R_KL3c, R_KL3d, R_KL3e: 10k; R_0603_1608Metric
R_KL1f, R_KL2f, R_KL3f: 18k; R_0603_1608Metric
U_KL1, U_KL2, U_KL3: L9637D; SOIC-8_3.9x4.9mm_P1.27mm

Connections:
+5V_V: C_KL1a.1, C_KL2a.1, C_KL3a.1, R_KL1c.2, R_KL1d.2, R_KL2c.2, R_KL2d.2, R_KL3c.2, R_KL3d.2, U_KL1.3 (VCC), U_KL2.3 (VCC), U_KL3.3 (VCC)
GND_V: C_KL1a.2, C_KL1b.2, C_KL2a.2, C_KL2b.2, C_KL3a.2, C_KL3b.2, Q_KL1.2 (S), Q_KL2.2 (S), Q_KL3.2 (S), R_KL1b.2, R_KL1f.2, R_KL2b.2, R_KL2f.2, R_KL3b.2, R_KL3f.2, U_KL1.5 (GND), U_KL2.5 (GND), U_KL3.5 (GND)
KLINE1: R_KL1a.1, U_KL1.6 (K)
KLINE2: R_KL2a.1, U_KL2.6 (K)
KLINE3: R_KL3a.1, U_KL3.6 (K)
K_RX1_V: R_KL1e.2, R_KL1f.1
K_RX2_V: R_KL2e.2, R_KL2f.1
K_RX3_V: R_KL3e.2, R_KL3f.1
K_TX1_V: Q_KL1.1 (G)
K_TX2_V: Q_KL2.1 (G)
K_TX3_V: Q_KL3.1 (G)
unnamed: Q_KL1.3 (D), R_KL1d.1, U_KL1.4 (TX)
unnamed: R_KL1e.1, U_KL1.1 (RX)
unnamed: R_KL1b.1, U_KL1.8 (LI)
unnamed: R_KL1c.1, U_KL1.2 (LO)
unnamed: Q_KL2.3 (D), R_KL2d.1, U_KL2.4 (TX)
unnamed: R_KL2e.1, U_KL2.1 (RX)
unnamed: R_KL2b.1, U_KL2.8 (LI)
unnamed: R_KL2c.1, U_KL2.2 (LO)
unnamed: Q_KL3.3 (D), R_KL3d.1, U_KL3.4 (TX)
unnamed: R_KL3e.1, U_KL3.1 (RX)
unnamed: R_KL3b.1, U_KL3.8 (LI)
unnamed: R_KL3c.1, U_KL3.2 (LO)
VBAT_PROT: C_KL1b.1, C_KL2b.1, C_KL3b.1, R_KL1a.2, R_KL2a.2, R_KL3a.2, U_KL1.7 (VS), U_KL2.7 (VS), U_KL3.7 (VS)
