OmniboxCreator/OmniBox/hardware/omnibox-v1/sheets/mcu.kicad_sch

## KiCad design hardware/omnibox-v1/sheets/mcu.kicad_sch (2026-07-20)

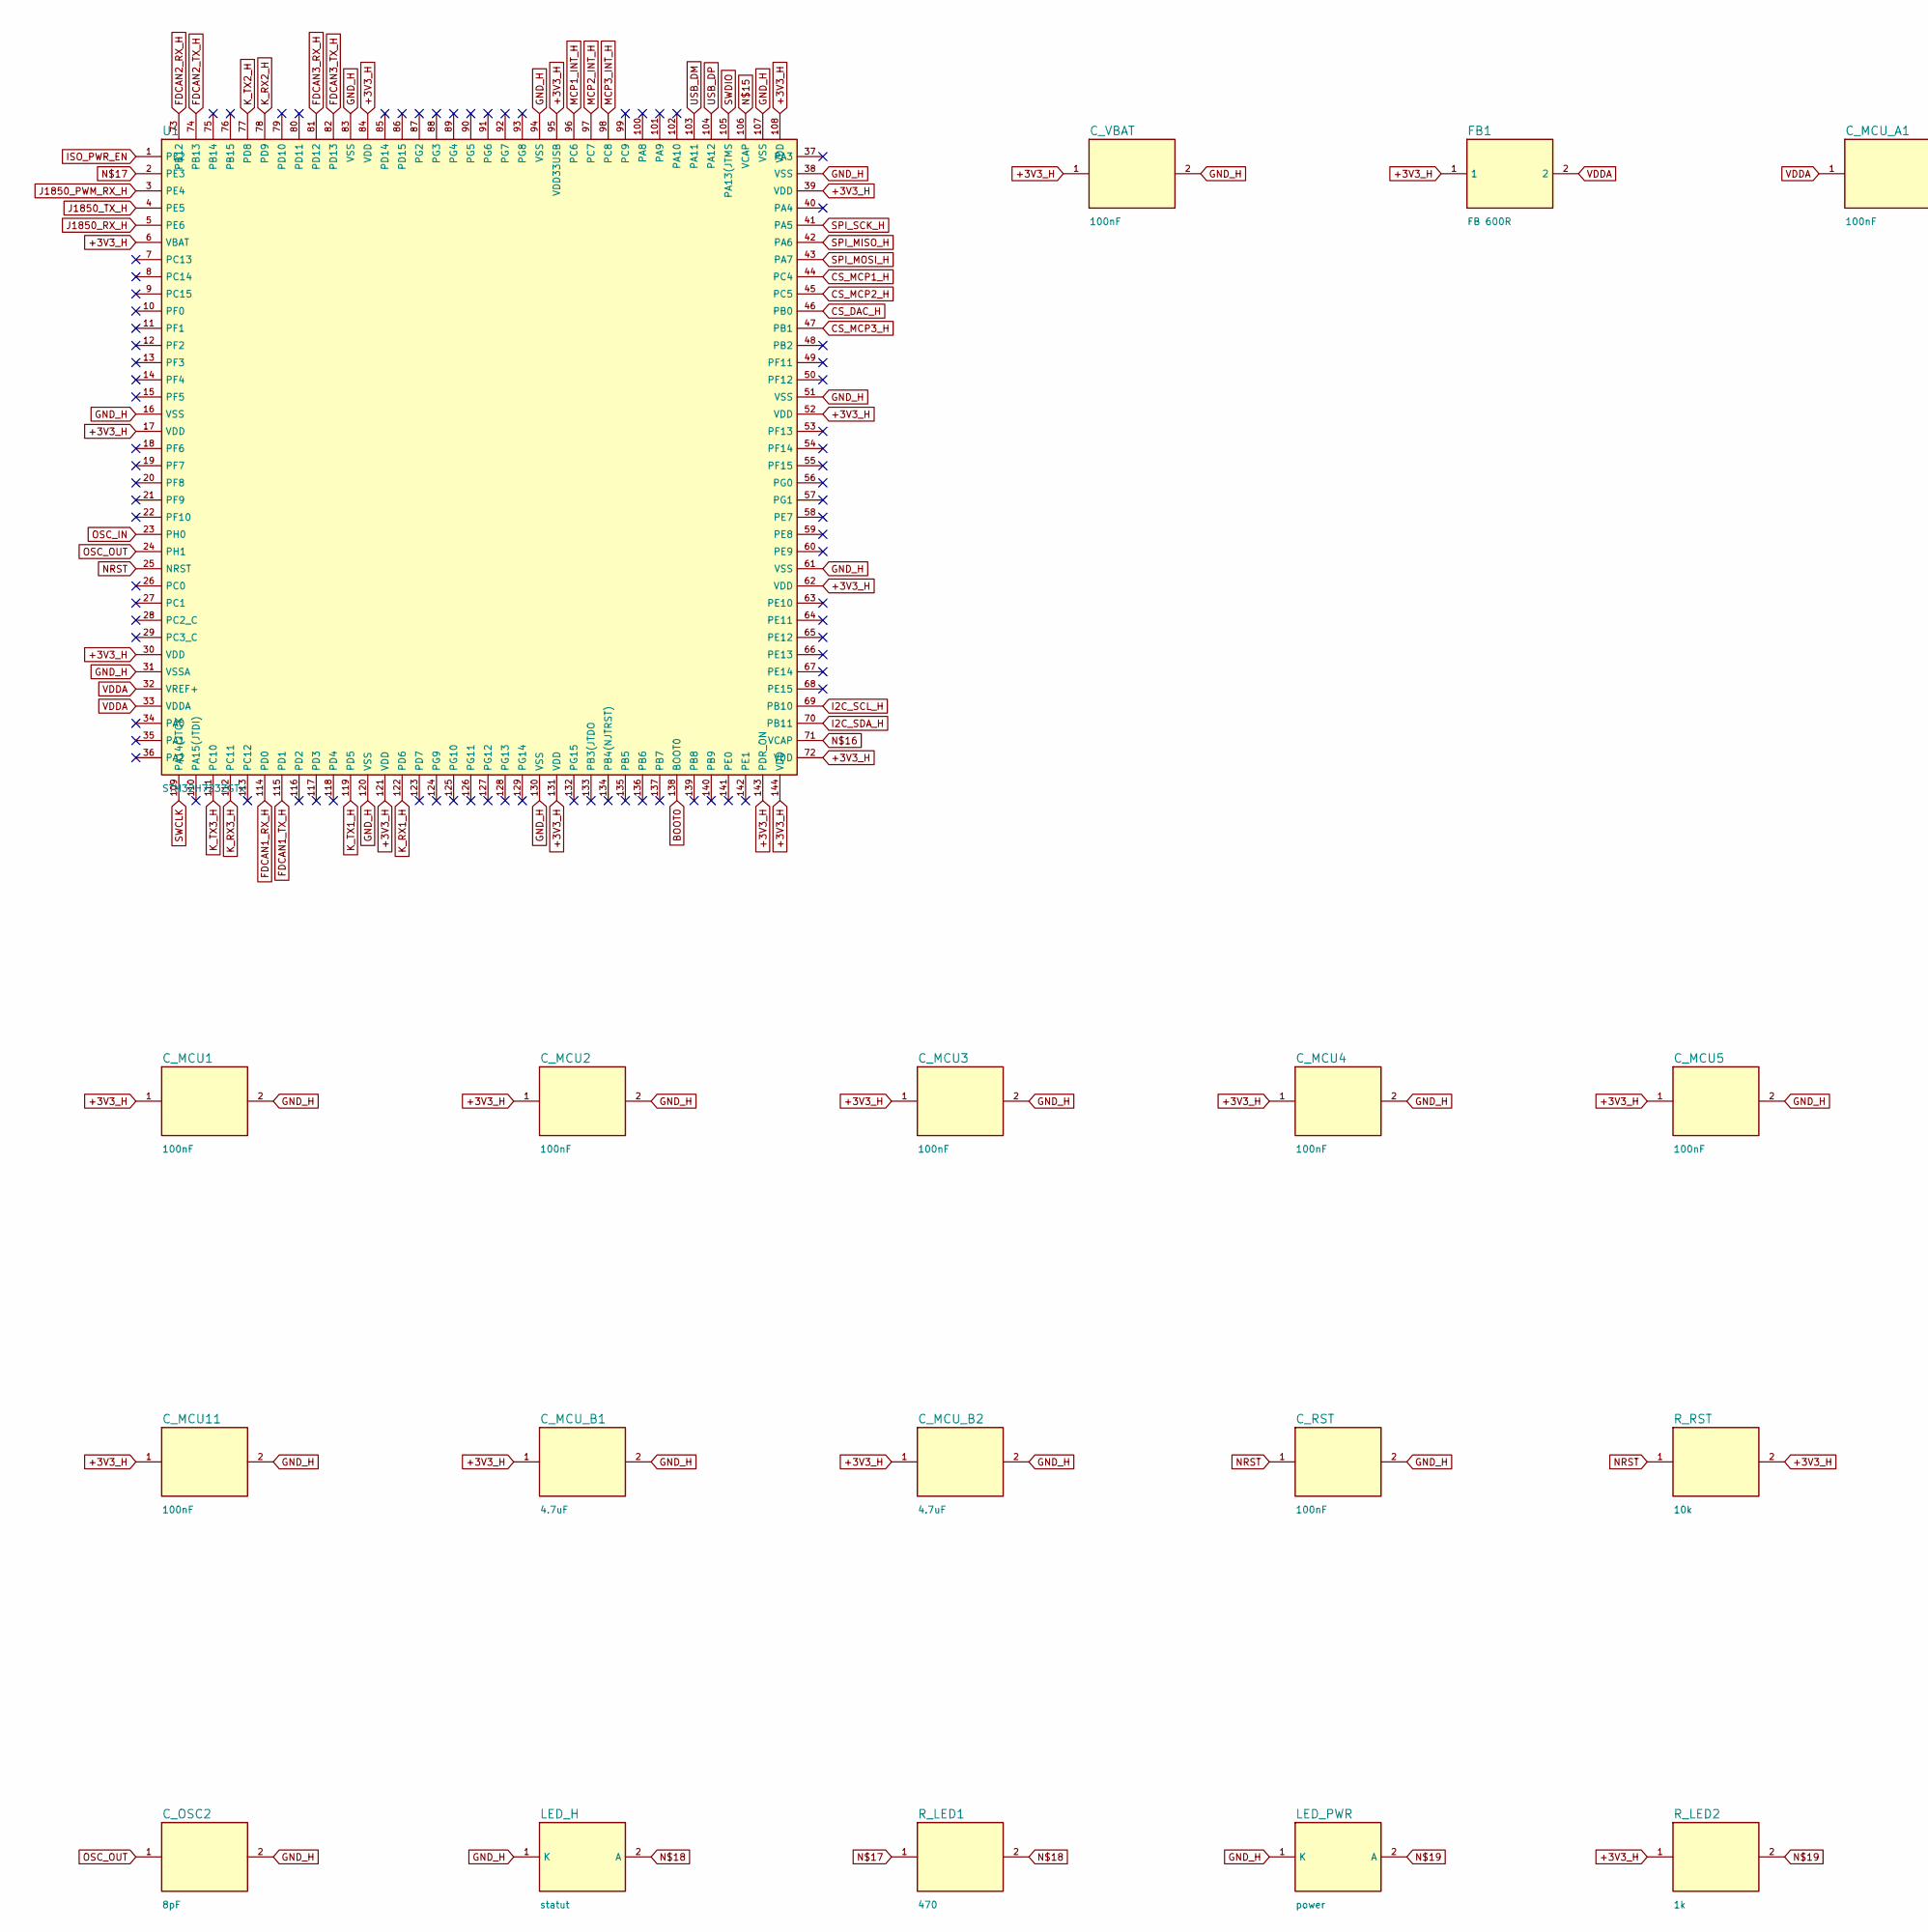
[picture p30: schematic mcu.kicad_sch, part in row 1, column 1]

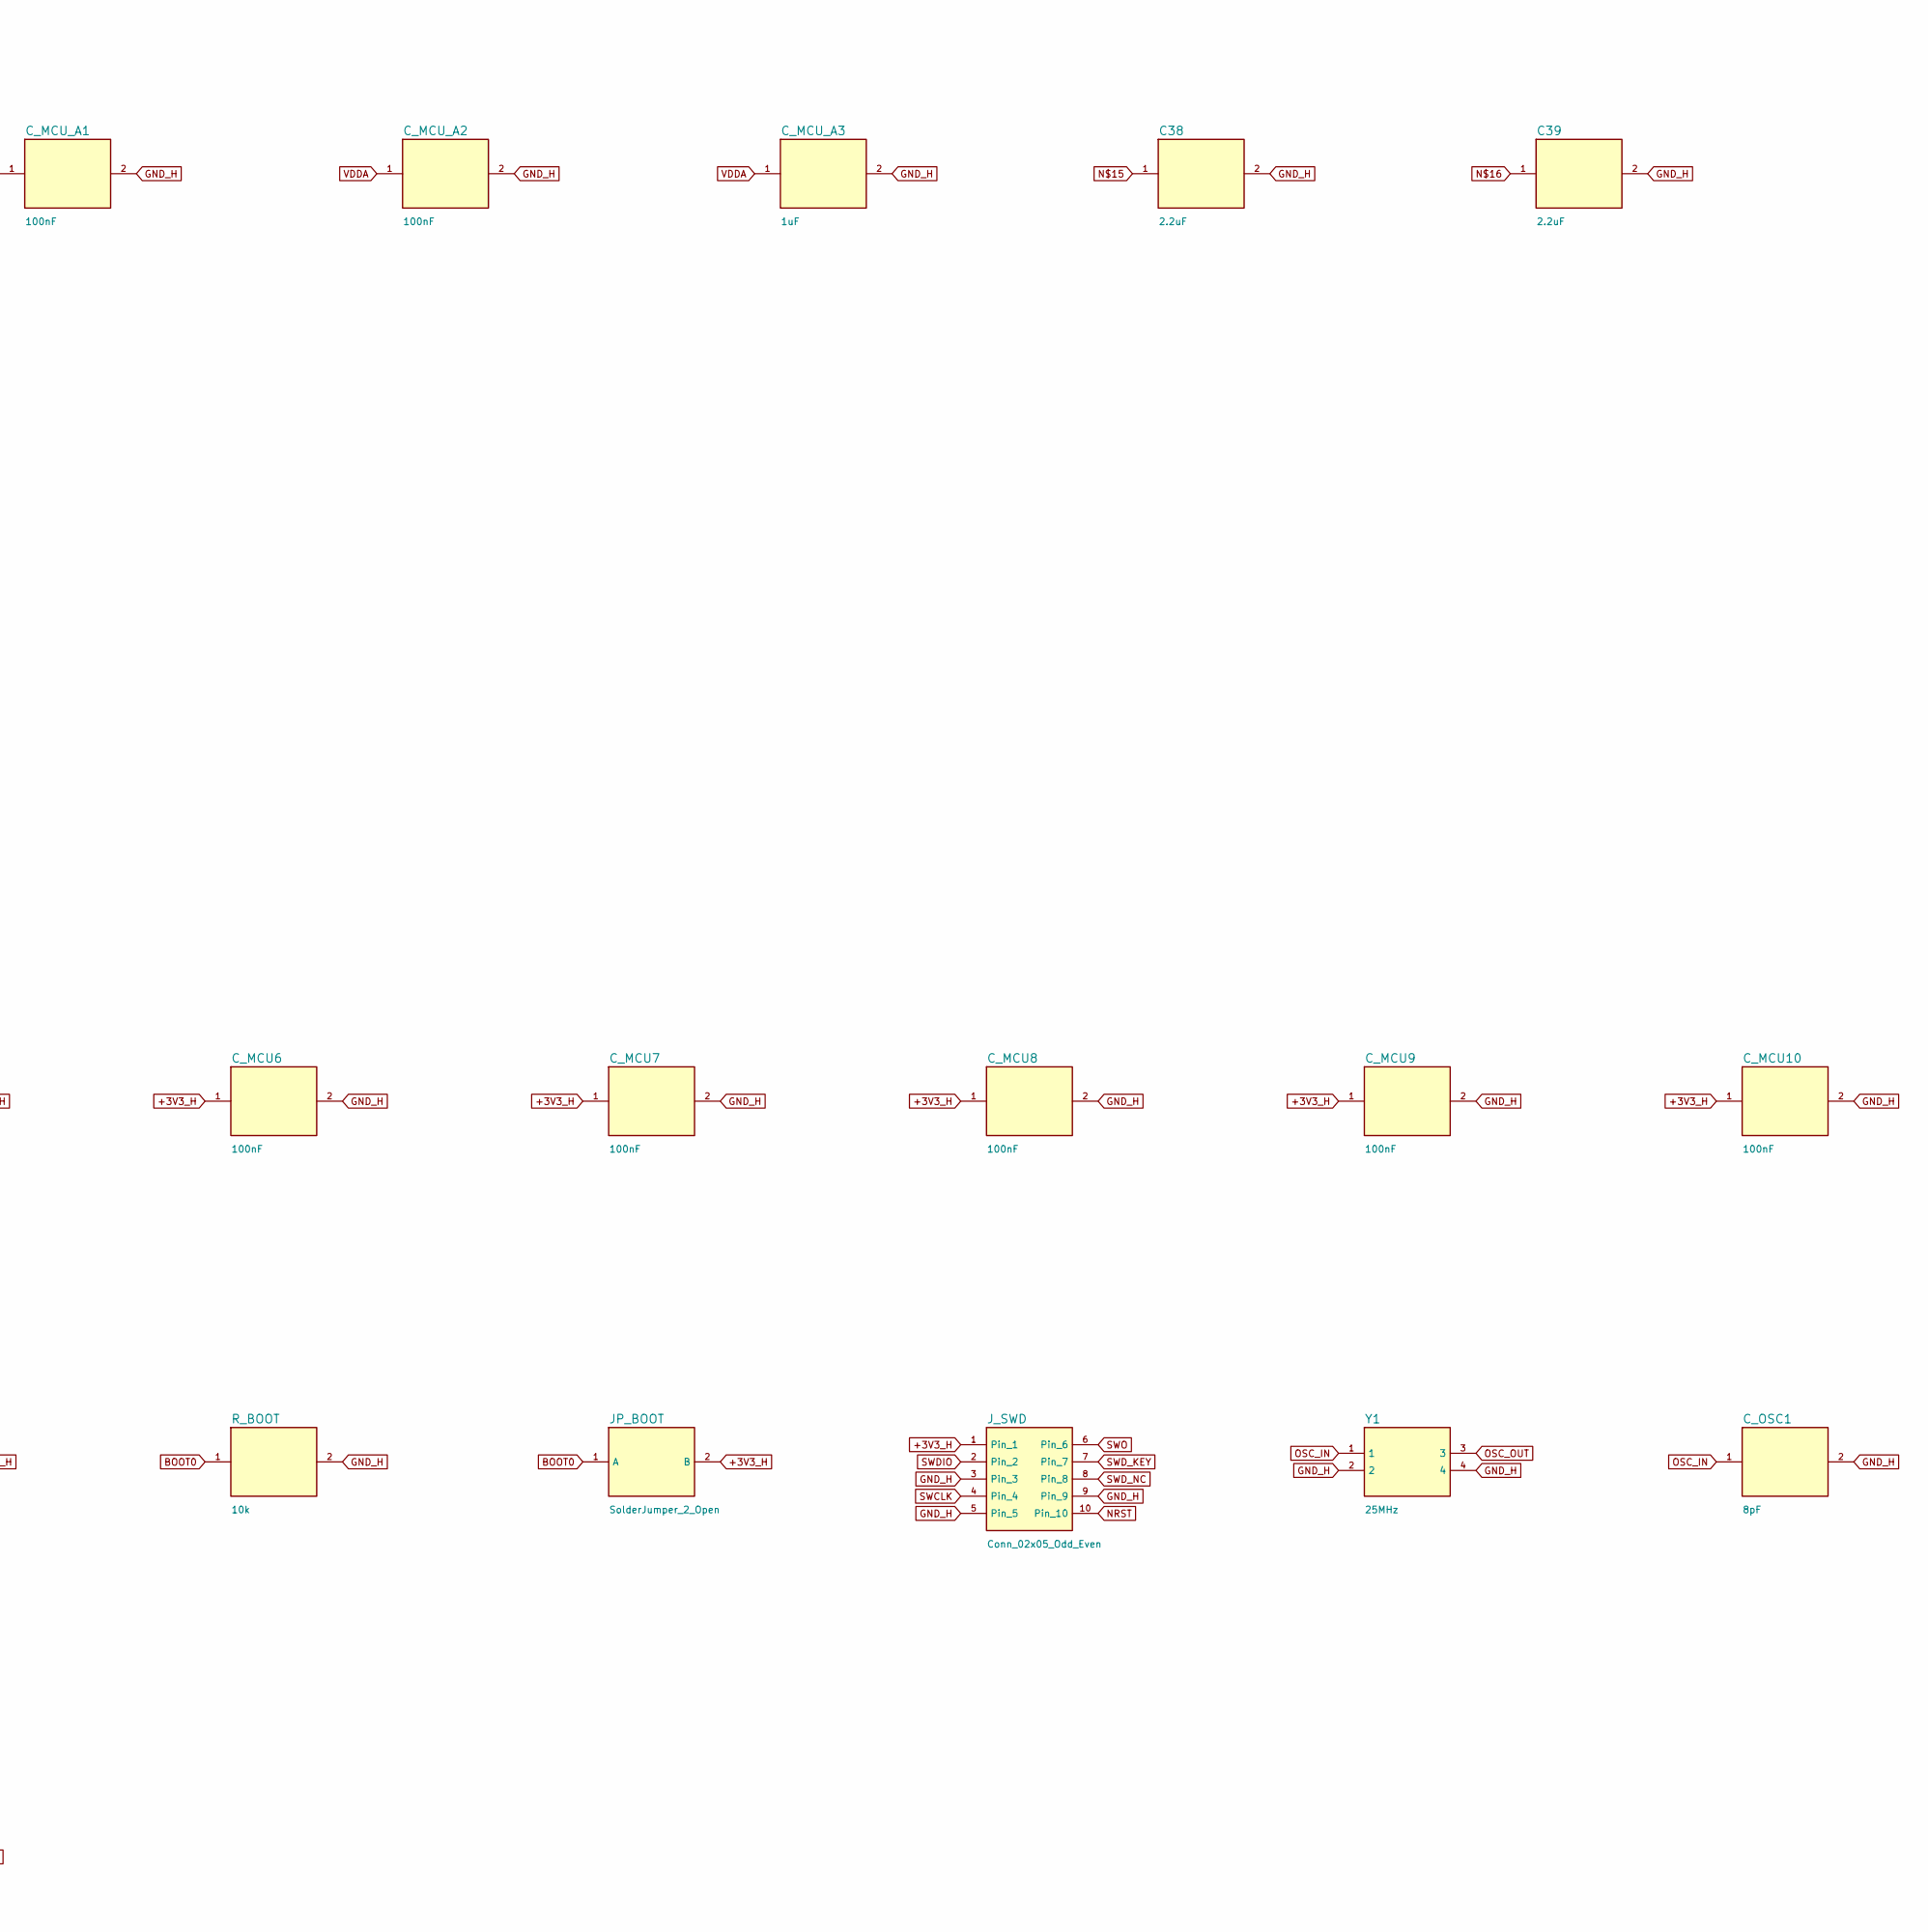
[picture p31: schematic mcu.kicad_sch, part in row 1, column 2]

Parts:
C38, C39: 2.2uF; C_0603_1608Metric
C_MCU1, C_MCU2, C_MCU3, C_MCU4, C_MCU5, C_MCU6, C_MCU7, C_MCU8, C_MCU9, C_MCU10, C_MCU11: 100nF; C_0603_1608Metric
C_MCU_A1, C_MCU_A2: 100nF; C_0603_1608Metric
C_MCU_A3: 1uF; C_0603_1608Metric
C_MCU_B1, C_MCU_B2: 4.7uF; C_0805_2012Metric
C_OSC1, C_OSC2: 8pF; C_0603_1608Metric
C_RST: 100nF; C_0603_1608Metric
C_VBAT: 100nF; C_0603_1608Metric
FB1: FB 600R; L_0603_1608Metric
JP_BOOT: SolderJumper_2_Open; SolderJumper-2_P1.3mm_Open_Pad1.0x1.5mm
J_SWD: Conn_02x05_Odd_Even; PinHeader_2x05_P1.27mm_Vertical
LED_H: statut; LED_0603_1608Metric
LED_PWR: power; LED_0603_1608Metric
R_BOOT: 10k; R_0603_1608Metric
R_LED1: 470; R_0603_1608Metric
R_LED2: 1k; R_0603_1608Metric
R_RST: 10k; R_0603_1608Metric
U1: STM32H723ZGTx; LQFP-144_20x20mm_P0.5mm
Y1: 25MHz; Crystal_SMD_3225-4Pin_3.2x2.5mm

Connections:
+3V3_H: C_MCU1.1, C_MCU2.1, C_MCU3.1, C_MCU4.1, C_MCU5.1, C_MCU6.1, C_MCU7.1, C_MCU8.1, C_MCU9.1, C_MCU10.1, C_MCU11.1, C_MCU_B1.1, C_MCU_B2.1, C_VBAT.1, FB1.1, JP_BOOT.2 (B), J_SWD.1, R_LED2.1, R_RST.2, U1.6 (VBAT), U1.17 (VDD), U1.30 (VDD), U1.39 (VDD), U1.52 (VDD), U1.62 (VDD), U1.72 (VDD), U1.84 (VDD), U1.95 (VDD33USB), U1.108 (VDD), U1.121 (VDD), U1.131 (VDD), U1.143 (PDR_ON), U1.144 (VDD)
BOOT0: JP_BOOT.1 (A), R_BOOT.1, U1.138 (BOOT0)
CS_DAC_H: U1.46 (PB0)
CS_MCP1_H: U1.44 (PC4)
CS_MCP2_H: U1.45 (PC5)
CS_MCP3_H: U1.47 (PB1)
FDCAN1_RX_H: U1.114 (PD0)
FDCAN1_TX_H: U1.115 (PD1)
FDCAN2_RX_H: U1.73 (PB12)
FDCAN2_TX_H: U1.74 (PB13)
FDCAN3_RX_H: U1.81 (PD12)
FDCAN3_TX_H: U1.82 (PD13)
GND_H: C38.2, C39.2, C_MCU1.2, C_MCU2.2, C_MCU3.2, C_MCU4.2, C_MCU5.2, C_MCU6.2, C_MCU7.2, C_MCU8.2, C_MCU9.2, C_MCU10.2, C_MCU11.2, C_MCU_A1.2, C_MCU_A2.2, C_MCU_A3.2, C_MCU_B1.2, C_MCU_B2.2, C_OSC1.2, C_OSC2.2, C_RST.2, C_VBAT.2, J_SWD.3, J_SWD.5, J_SWD.9, LED_H.1 (K), LED_PWR.1 (K), R_BOOT.2, U1.16 (VSS), U1.31 (VSSA), U1.38 (VSS), U1.51 (VSS), U1.61 (VSS), U1.83 (VSS), U1.94 (VSS), U1.107 (VSS), U1.120 (VSS), U1.130 (VSS), Y1.2, Y1.4
I2C_SCL_H: U1.69 (PB10)
I2C_SDA_H: U1.70 (PB11)
ISO_PWR_EN: U1.1 (PE2)
J1850_PWM_RX_H: U1.3 (PE4)
J1850_RX_H: U1.5 (PE6)
J1850_TX_H: U1.4 (PE5)
K_RX1_H: U1.122 (PD6)
K_RX2_H: U1.78 (PD9)
K_RX3_H: U1.112 (PC11)
K_TX1_H: U1.119 (PD5)
K_TX2_H: U1.77 (PD8)
K_TX3_H: U1.111 (PC10)
MCP1_INT_H: U1.96 (PC6)
MCP2_INT_H: U1.97 (PC7)
MCP3_INT_H: U1.98 (PC8)
unnamed: C38.1, U1.106 (VCAP)
unnamed: C39.1, U1.71 (VCAP)
unnamed: R_LED1.1, U1.2 (PE3)
unnamed: LED_H.2 (A), R_LED1.2
unnamed: LED_PWR.2 (A), R_LED2.2
NRST: C_RST.1, J_SWD.10, R_RST.1, U1.25 (NRST)
OSC_IN: C_OSC1.1, U1.23 (PH0), Y1.1
OSC_OUT: C_OSC2.1, U1.24 (PH1), Y1.3
SPI_MISO_H: U1.42 (PA6)
SPI_MOSI_H: U1.43 (PA7)
SPI_SCK_H: U1.41 (PA5)
SWCLK: J_SWD.4, U1.109 (PA14(JTCK)
SWDIO: J_SWD.2, U1.105 (PA13(JTMS)
SWD_KEY: J_SWD.7
SWD_NC: J_SWD.8
SWO: J_SWD.6
USB_DM: U1.103 (PA11)
USB_DP: U1.104 (PA12)
VDDA: C_MCU_A1.1, C_MCU_A2.1, C_MCU_A3.1, FB1.2, U1.32 (VREF+), U1.33 (VDDA)
