OmniboxCreator/OmniBox/hardware/omnibox-v1/sheets/power_protection.kicad_sch

## KiCad design hardware/omnibox-v1/sheets/power_protection.kicad_sch (2026-07-20)

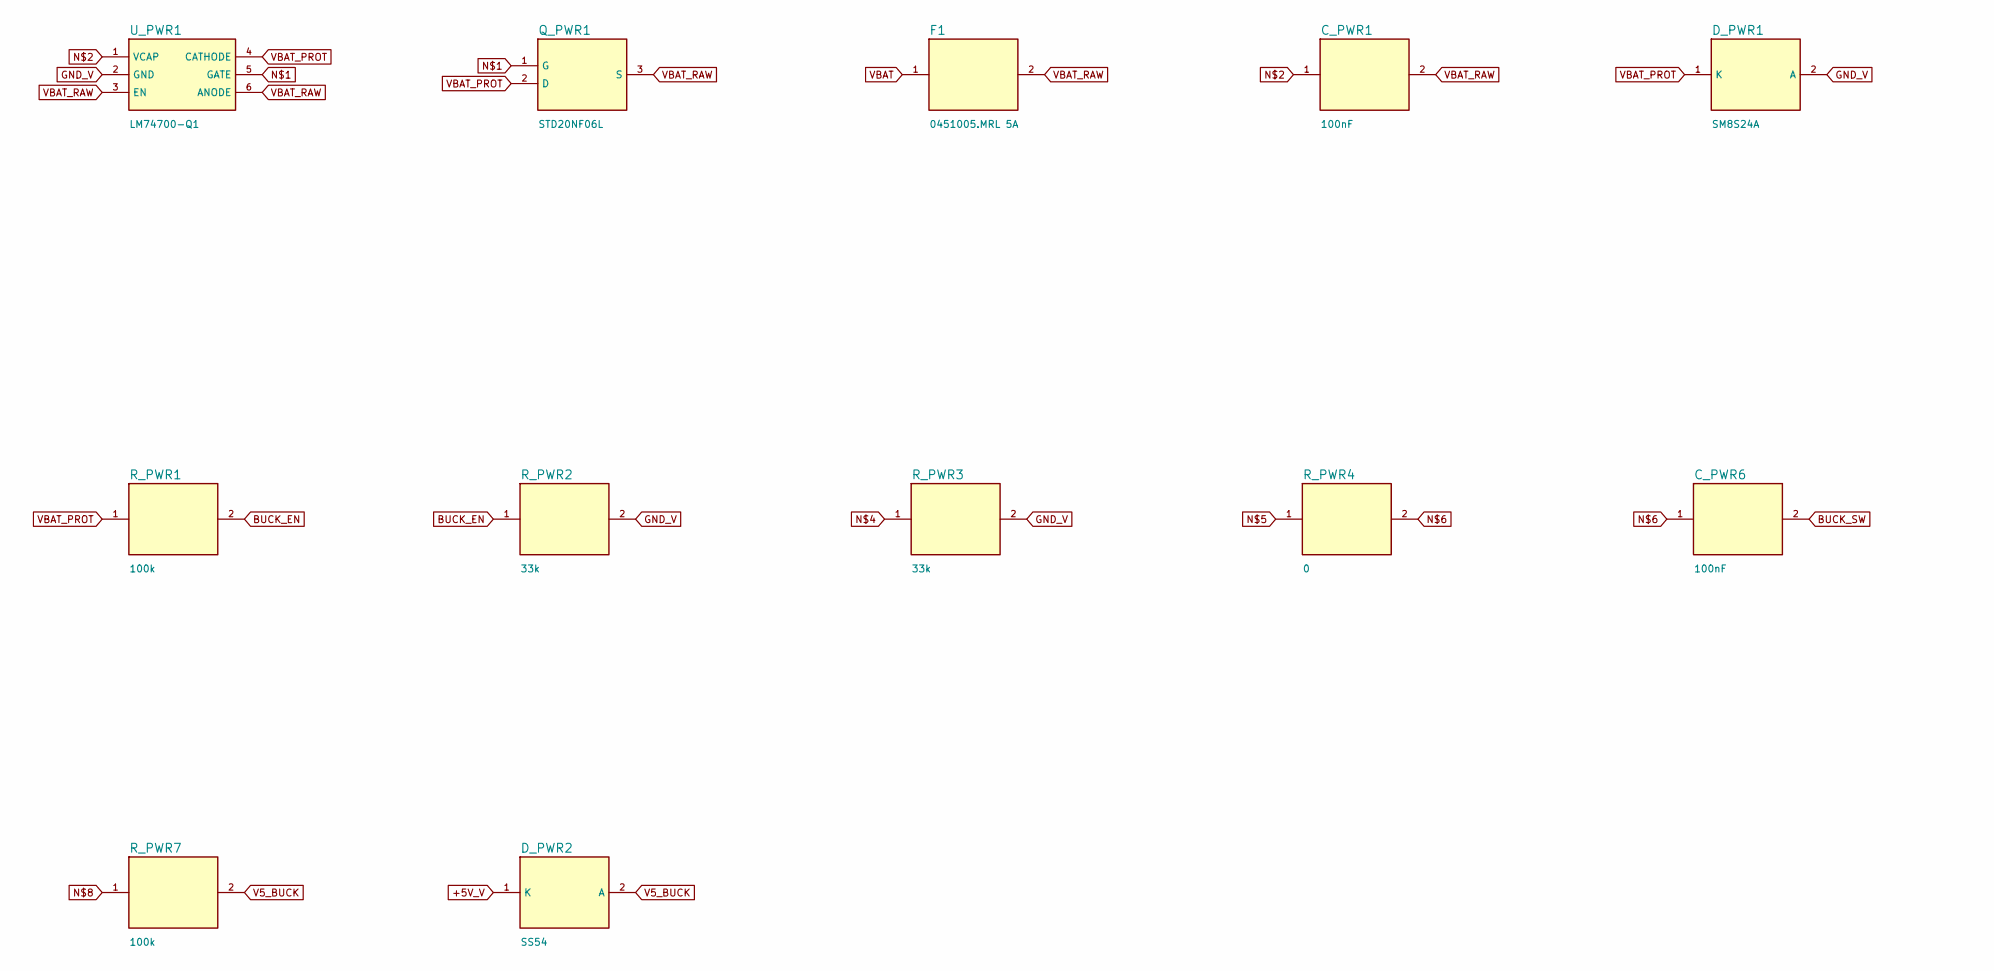
[picture p32: schematic power_protection.kicad_sch, part in row 1, column 1]

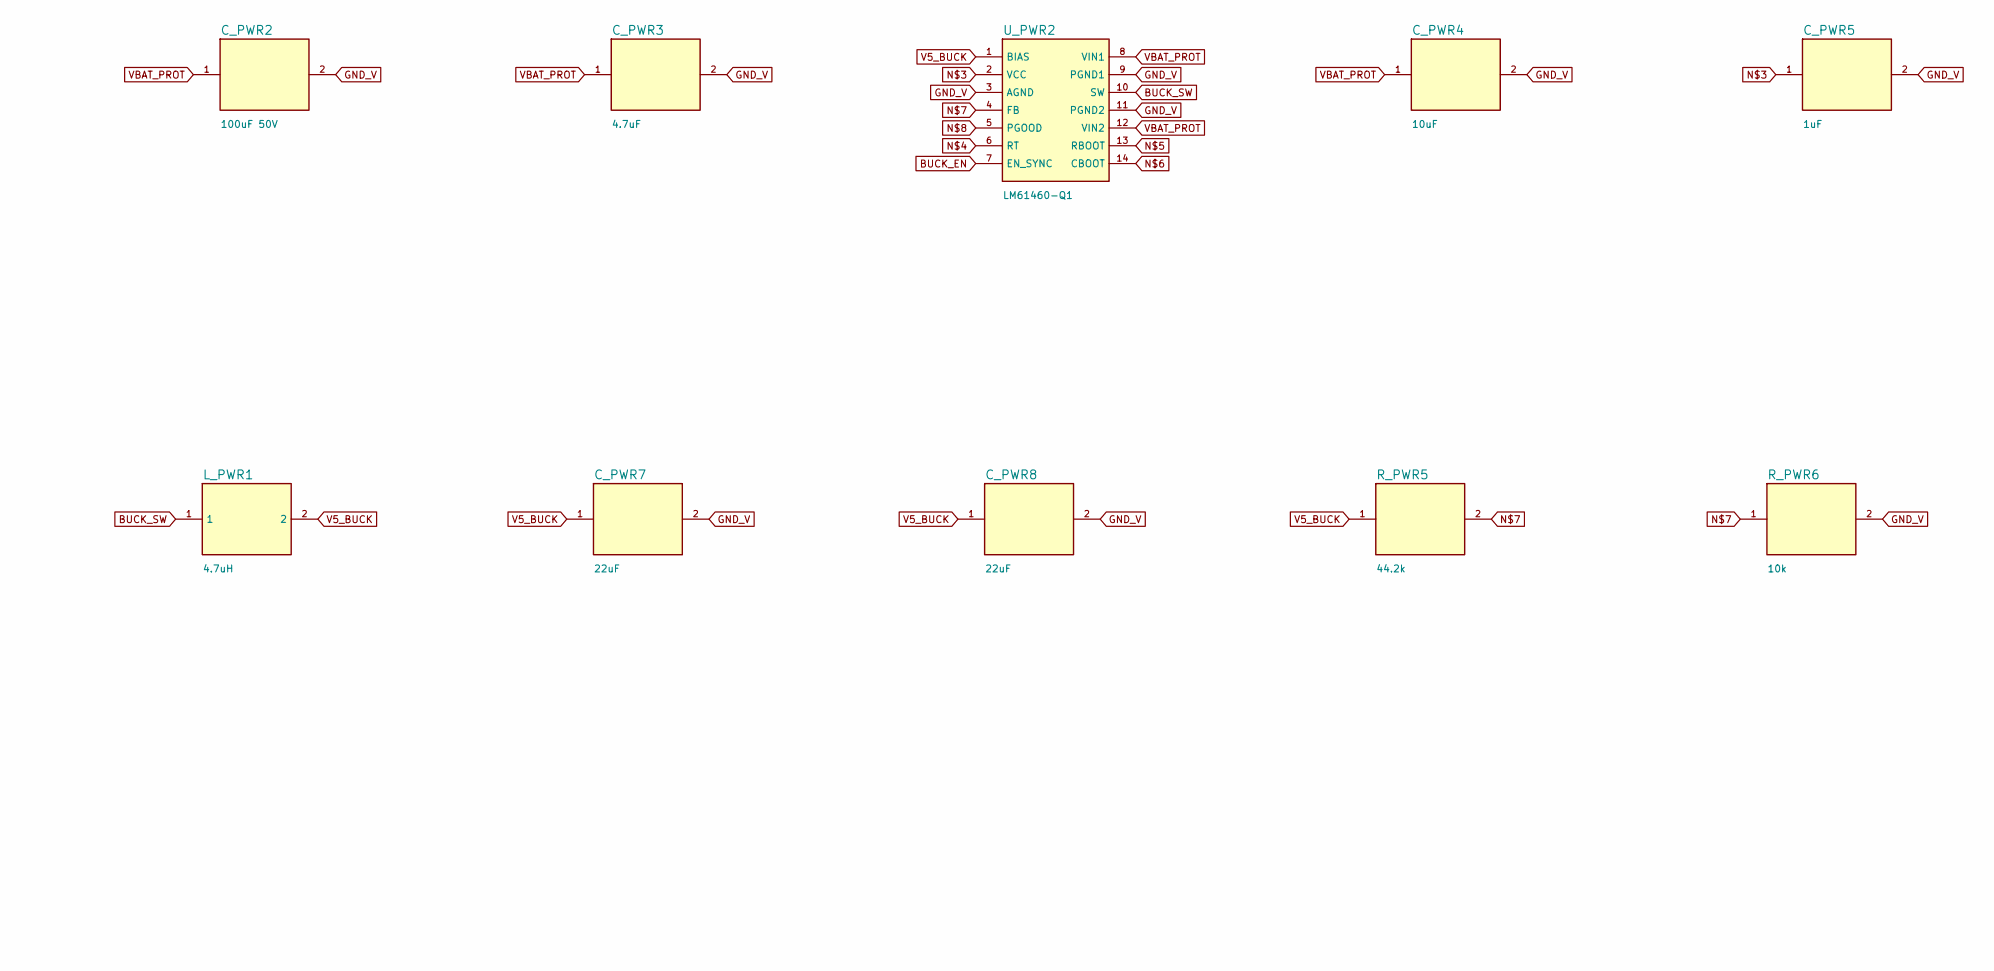
[picture p33: schematic power_protection.kicad_sch, part in row 1, column 2]

Parts:
C_PWR1, C_PWR6: 100nF; C_0603_1608Metric
C_PWR2: 100uF 50V; CP_Elec_8x10.5
C_PWR3: 4.7uF; C_0805_2012Metric
C_PWR4: 10uF; C_0805_2012Metric
C_PWR5: 1uF; C_0603_1608Metric
C_PWR7, C_PWR8: 22uF; C_0805_2012Metric
D_PWR1: SM8S24A; TVS_DO-218AB
D_PWR2: SS54; D_SMA
F1: 0451005.MRL 5A; Fuse_Littelfuse-NANO2-451_453
L_PWR1: 4.7uH; L_12x12mm_H8mm
Q_PWR1: STD20NF06L; TO-252-3_TabPin2
R_PWR1, R_PWR7: 100k; R_0603_1608Metric
R_PWR2, R_PWR3: 33k; R_0603_1608Metric
R_PWR4: 0; R_0603_1608Metric
R_PWR5: 44.2k; R_0603_1608Metric
R_PWR6: 10k; R_0603_1608Metric
U_PWR1: LM74700-Q1; SOT-23-6
U_PWR2: LM61460-Q1; LM61460_VQFN-HR-14

Connections:
+5V_V: D_PWR2.1 (K)
BUCK_EN: R_PWR1.2, R_PWR2.1, U_PWR2.7 (EN_SYNC)
BUCK_SW: C_PWR6.2, L_PWR1.1, U_PWR2.10 (SW)
GND_V: C_PWR2.2, C_PWR3.2, C_PWR4.2, C_PWR5.2, C_PWR7.2, C_PWR8.2, D_PWR1.2 (A), R_PWR2.2, R_PWR3.2, R_PWR6.2, U_PWR1.2 (GND), U_PWR2.3 (AGND), U_PWR2.9 (PGND1), U_PWR2.11 (PGND2)
unnamed: Q_PWR1.1 (G), U_PWR1.5 (GATE)
unnamed: C_PWR1.1, U_PWR1.1 (VCAP)
unnamed: C_PWR5.1, U_PWR2.2 (VCC)
unnamed: R_PWR3.1, U_PWR2.6 (RT)
unnamed: R_PWR4.1, U_PWR2.13 (RBOOT)
unnamed: C_PWR6.1, R_PWR4.2, U_PWR2.14 (CBOOT)
unnamed: R_PWR5.2, R_PWR6.1, U_PWR2.4 (FB)
unnamed: R_PWR7.1, U_PWR2.5 (PGOOD)
V5_BUCK: C_PWR7.1, C_PWR8.1, D_PWR2.2 (A), L_PWR1.2, R_PWR5.1, R_PWR7.2, U_PWR2.1 (BIAS)
VBAT: F1.1
VBAT_PROT: C_PWR2.1, C_PWR3.1, C_PWR4.1, D_PWR1.1 (K), Q_PWR1.2 (D), R_PWR1.1, U_PWR1.4 (CATHODE), U_PWR2.8 (VIN1), U_PWR2.12 (VIN2)
VBAT_RAW: C_PWR1.2, F1.2, Q_PWR1.3 (S), U_PWR1.3 (EN), U_PWR1.6 (ANODE)
