OmniboxCreator/OmniBox/hardware/omnibox-v1/sheets/routing_matrix.kicad_sch

## KiCad design hardware/omnibox-v1/sheets/routing_matrix.kicad_sch (2026-07-20)

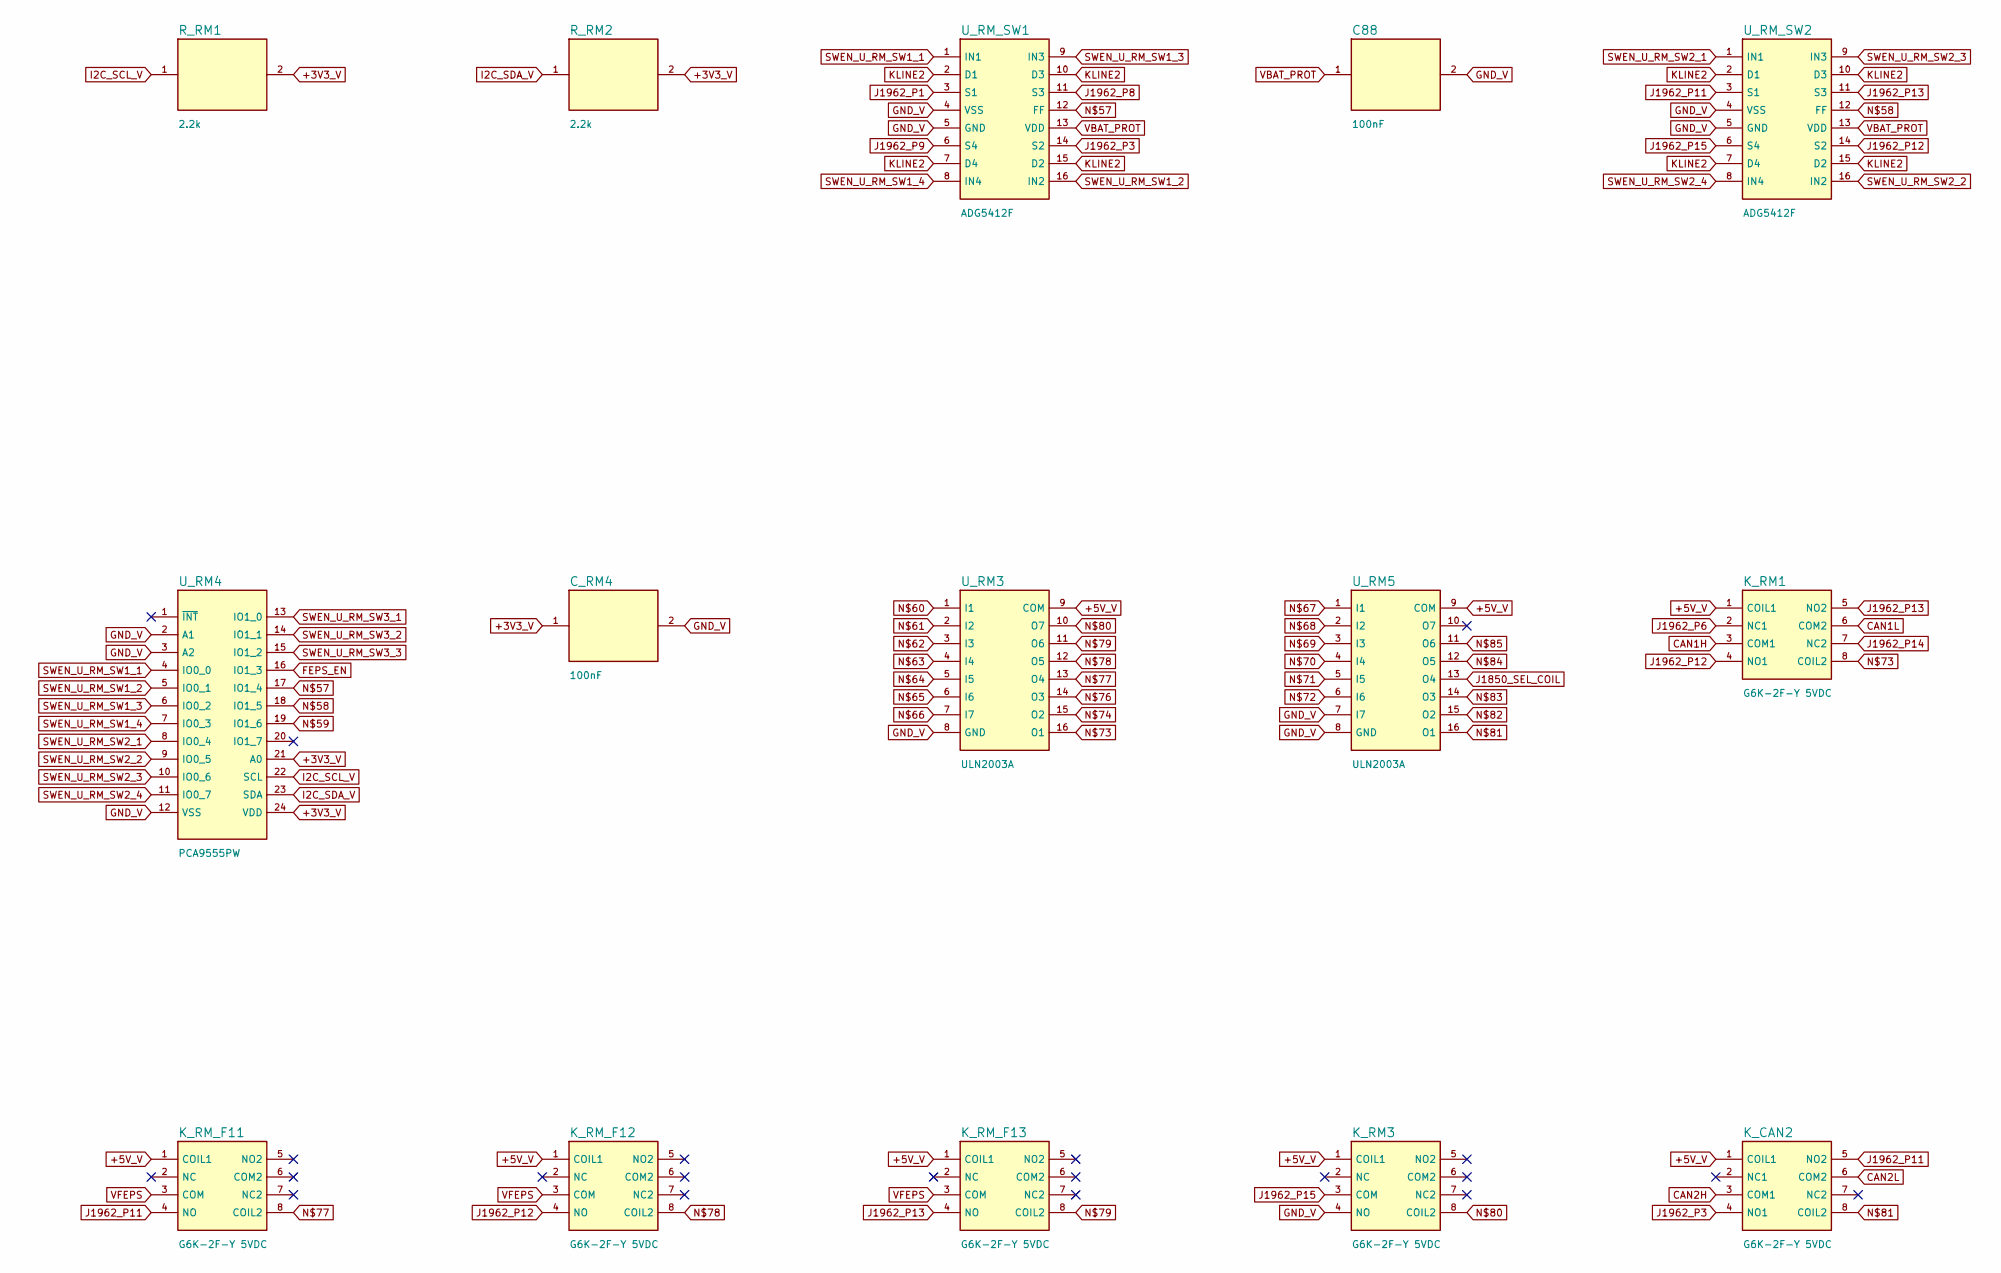
[picture p34: schematic routing_matrix.kicad_sch, part in row 1, column 1]

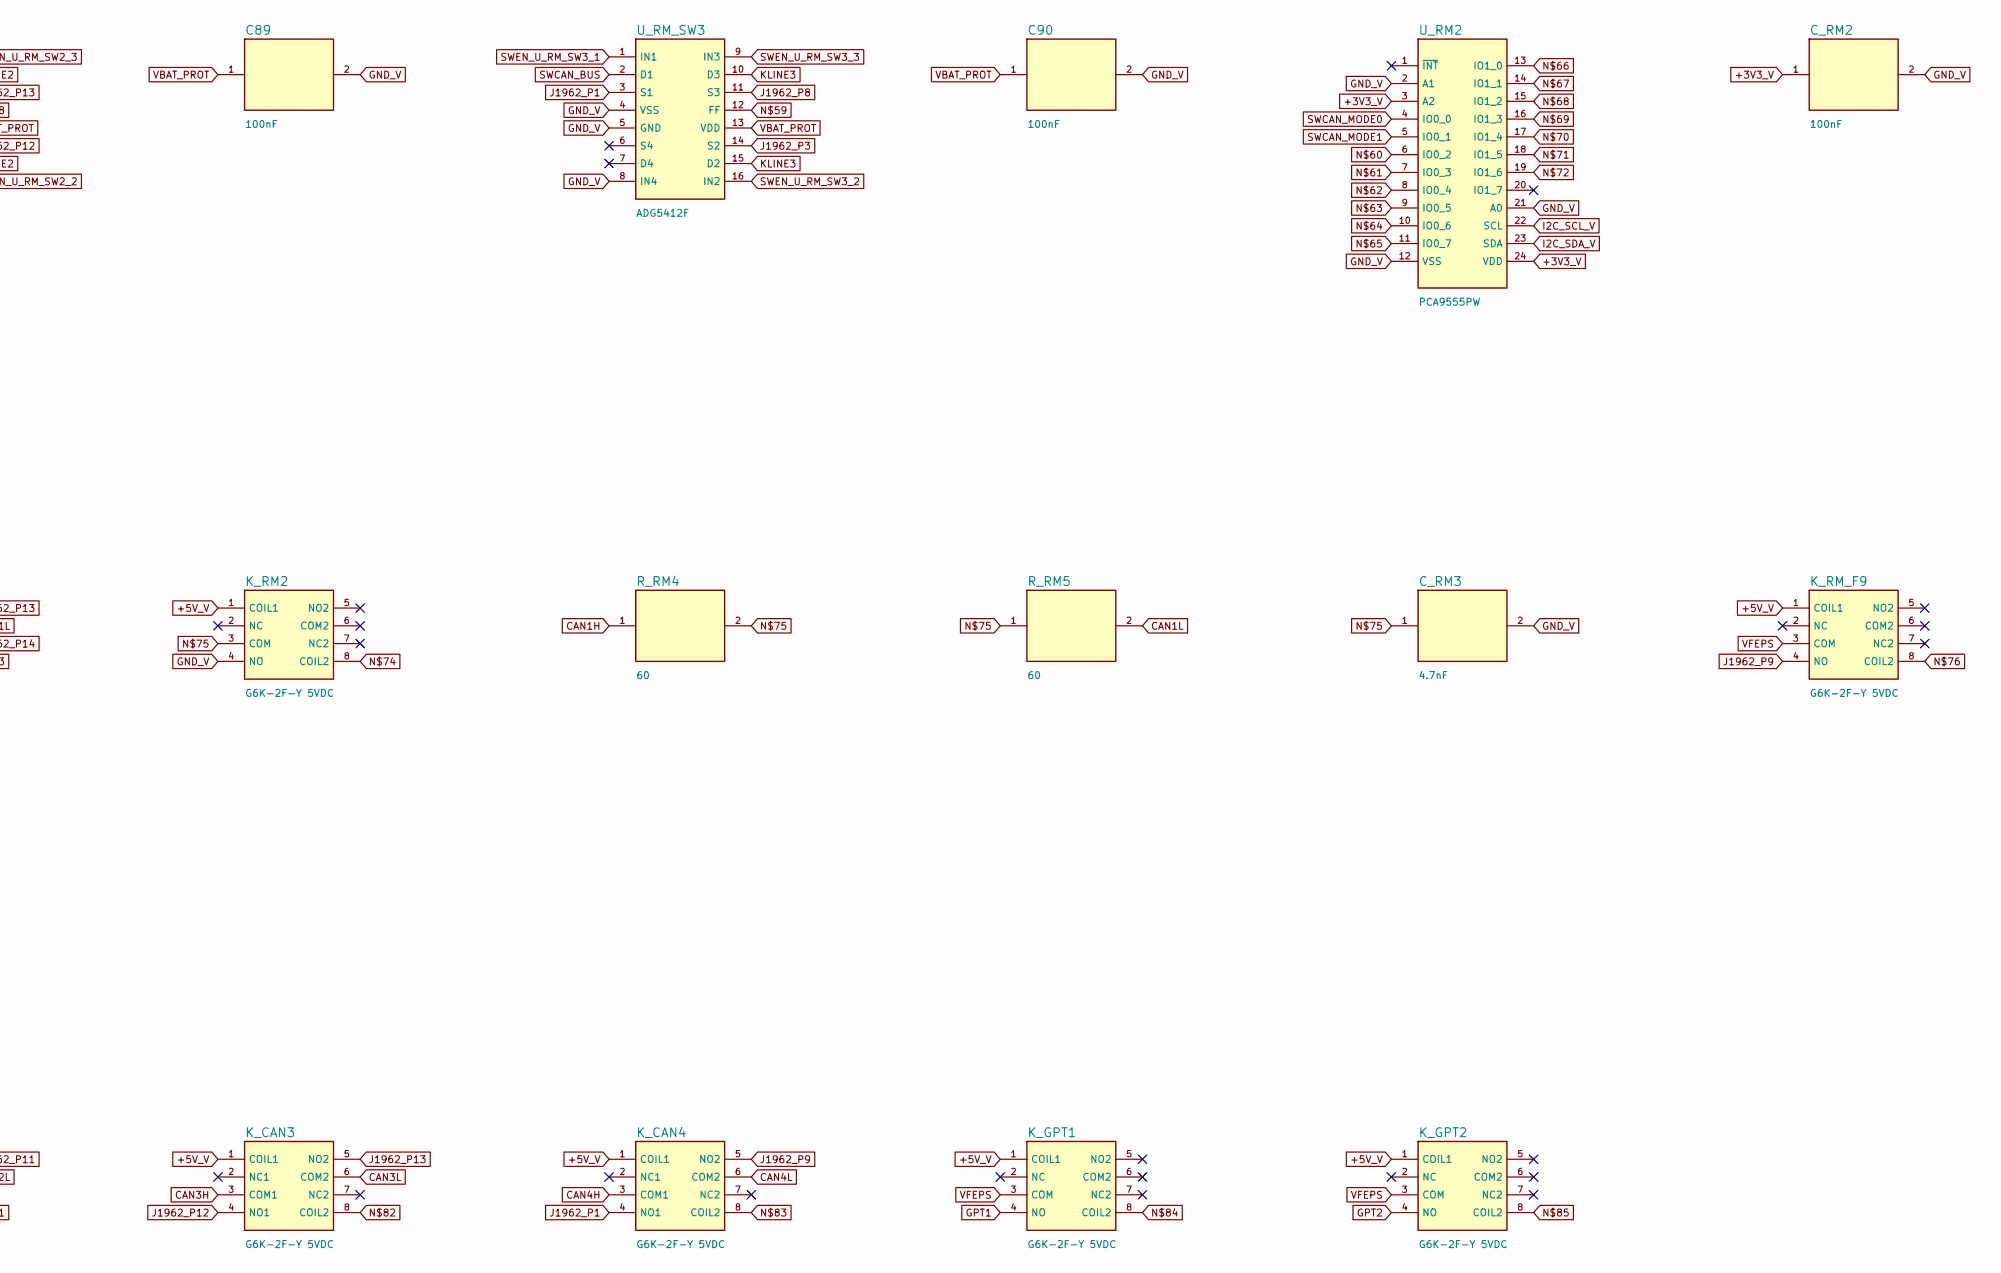
[picture p35: schematic routing_matrix.kicad_sch, part in row 1, column 2]

Parts:
C88, C89, C90: 100nF; C_0603_1608Metric
C_RM2, C_RM4: 100nF; C_0603_1608Metric
C_RM3: 4.7nF; C_0603_1608Metric
K_CAN2, K_CAN3, K_CAN4: G6K-2F-Y 5VDC; Relay_DPDT_Omron_G6K-2F-Y
K_GPT1, K_GPT2: G6K-2F-Y 5VDC; Relay_DPDT_Omron_G6K-2F-Y
K_RM1, K_RM2, K_RM3: G6K-2F-Y 5VDC; Relay_DPDT_Omron_G6K-2F-Y
K_RM_F9, K_RM_F11, K_RM_F12, K_RM_F13: G6K-2F-Y 5VDC; Relay_DPDT_Omron_G6K-2F-Y
R_RM1, R_RM2: 2.2k; R_0603_1608Metric
R_RM4, R_RM5: 60; R_0603_1608Metric
U_RM2, U_RM4: PCA9555PW; TSSOP-24_4.4x7.8mm_P0.65mm
U_RM3, U_RM5: ULN2003A; SOIC-16_3.9x9.9mm_P1.27mm
U_RM_SW1, U_RM_SW2, U_RM_SW3: ADG5412F; TSSOP-16_4.4x5mm_P0.65mm

Connections:
+3V3_V: C_RM2.1, C_RM4.1, R_RM1.2, R_RM2.2, U_RM2.3 (A2), U_RM2.24 (VDD), U_RM4.21 (A0), U_RM4.24 (VDD)
+5V_V: K_CAN2.1 (COIL1), K_CAN3.1 (COIL1), K_CAN4.1 (COIL1), K_GPT1.1 (COIL1), K_GPT2.1 (COIL1), K_RM1.1 (COIL1), K_RM2.1 (COIL1), K_RM3.1 (COIL1), K_RM_F9.1 (COIL1), K_RM_F11.1 (COIL1), K_RM_F12.1 (COIL1), K_RM_F13.1 (COIL1), U_RM3.9 (COM), U_RM5.9 (COM)
CAN1H: K_RM1.3 (COM1), R_RM4.1
CAN1L: K_RM1.6 (COM2), R_RM5.2
CAN2H: K_CAN2.3 (COM1)
CAN2L: K_CAN2.6 (COM2)
CAN3H: K_CAN3.3 (COM1)
CAN3L: K_CAN3.6 (COM2)
CAN4H: K_CAN4.3 (COM1)
CAN4L: K_CAN4.6 (COM2)
FEPS_EN: U_RM4.16 (IO1_3)
GND_V: C88.2, C89.2, C90.2, C_RM2.2, C_RM3.2, C_RM4.2, K_RM2.4 (NO), K_RM3.4 (NO), U_RM2.2 (A1), U_RM2.12 (VSS), U_RM2.21 (A0), U_RM3.8 (GND), U_RM4.2 (A1), U_RM4.3 (A2), U_RM4.12 (VSS), U_RM5.7 (I7), U_RM5.8 (GND), U_RM_SW1.4 (VSS), U_RM_SW1.5 (GND), U_RM_SW2.4 (VSS), U_RM_SW2.5 (GND), U_RM_SW3.4 (VSS), U_RM_SW3.5 (GND), U_RM_SW3.8 (IN4)
GPT1: K_GPT1.4 (NO)
GPT2: K_GPT2.4 (NO)
I2C_SCL_V: R_RM1.1, U_RM2.22 (SCL), U_RM4.22 (SCL)
I2C_SDA_V: R_RM2.1, U_RM2.23 (SDA), U_RM4.23 (SDA)
J1850_SEL_COIL: U_RM5.13 (O4)
J1962_P1: K_CAN4.4 (NO1), U_RM_SW1.3 (S1), U_RM_SW3.3 (S1)
J1962_P3: K_CAN2.4 (NO1), U_RM_SW1.14 (S2), U_RM_SW3.14 (S2)
J1962_P6: K_RM1.2 (NC1)
J1962_P8: U_RM_SW1.11 (S3), U_RM_SW3.11 (S3)
J1962_P9: K_CAN4.5 (NO2), K_RM_F9.4 (NO), U_RM_SW1.6 (S4)
J1962_P11: K_CAN2.5 (NO2), K_RM_F11.4 (NO), U_RM_SW2.3 (S1)
J1962_P12: K_CAN3.4 (NO1), K_RM1.4 (NO1), K_RM_F12.4 (NO), U_RM_SW2.14 (S2)
J1962_P13: K_CAN3.5 (NO2), K_RM1.5 (NO2), K_RM_F13.4 (NO), U_RM_SW2.11 (S3)
J1962_P14: K_RM1.7 (NC2)
J1962_P15: K_RM3.3 (COM), U_RM_SW2.6 (S4)
KLINE2: U_RM_SW1.2 (D1), U_RM_SW1.7 (D4), U_RM_SW1.10 (D3), U_RM_SW1.15 (D2), U_RM_SW2.2 (D1), U_RM_SW2.7 (D4), U_RM_SW2.10 (D3), U_RM_SW2.15 (D2)
KLINE3: U_RM_SW3.10 (D3), U_RM_SW3.15 (D2)
unnamed: U_RM4.17 (IO1_4), U_RM_SW1.12 (FF)
unnamed: U_RM4.18 (IO1_5), U_RM_SW2.12 (FF)
unnamed: U_RM4.19 (IO1_6), U_RM_SW3.12 (FF)
unnamed: U_RM2.6 (IO0_2), U_RM3.1 (I1)
unnamed: U_RM2.7 (IO0_3), U_RM3.2 (I2)
unnamed: U_RM2.8 (IO0_4), U_RM3.3 (I3)
unnamed: U_RM2.9 (IO0_5), U_RM3.4 (I4)
unnamed: U_RM2.10 (IO0_6), U_RM3.5 (I5)
unnamed: U_RM2.11 (IO0_7), U_RM3.6 (I6)
unnamed: U_RM2.13 (IO1_0), U_RM3.7 (I7)
unnamed: U_RM2.14 (IO1_1), U_RM5.1 (I1)
unnamed: U_RM2.15 (IO1_2), U_RM5.2 (I2)
unnamed: U_RM2.16 (IO1_3), U_RM5.3 (I3)
unnamed: U_RM2.17 (IO1_4), U_RM5.4 (I4)
unnamed: U_RM2.18 (IO1_5), U_RM5.5 (I5)
unnamed: U_RM2.19 (IO1_6), U_RM5.6 (I6)
unnamed: K_RM1.8 (COIL2), U_RM3.16 (O1)
unnamed: K_RM2.8 (COIL2), U_RM3.15 (O2)
unnamed: C_RM3.1, K_RM2.3 (COM), R_RM4.2, R_RM5.1
unnamed: K_RM_F9.8 (COIL2), U_RM3.14 (O3)
unnamed: K_RM_F11.8 (COIL2), U_RM3.13 (O4)
unnamed: K_RM_F12.8 (COIL2), U_RM3.12 (O5)
unnamed: K_RM_F13.8 (COIL2), U_RM3.11 (O6)
unnamed: K_RM3.8 (COIL2), U_RM3.10 (O7)
unnamed: K_CAN2.8 (COIL2), U_RM5.16 (O1)
unnamed: K_CAN3.8 (COIL2), U_RM5.15 (O2)
unnamed: K_CAN4.8 (COIL2), U_RM5.14 (O3)
unnamed: K_GPT1.8 (COIL2), U_RM5.12 (O5)
unnamed: K_GPT2.8 (COIL2), U_RM5.11 (O6)
SWCAN_BUS: U_RM_SW3.2 (D1)
SWCAN_MODE0: U_RM2.4 (IO0_0)
SWCAN_MODE1: U_RM2.5 (IO0_1)
SWEN_U_RM_SW1_1: U_RM4.4 (IO0_0), U_RM_SW1.1 (IN1)
SWEN_U_RM_SW1_2: U_RM4.5 (IO0_1), U_RM_SW1.16 (IN2)
SWEN_U_RM_SW1_3: U_RM4.6 (IO0_2), U_RM_SW1.9 (IN3)
SWEN_U_RM_SW1_4: U_RM4.7 (IO0_3), U_RM_SW1.8 (IN4)
SWEN_U_RM_SW2_1: U_RM4.8 (IO0_4), U_RM_SW2.1 (IN1)
SWEN_U_RM_SW2_2: U_RM4.9 (IO0_5), U_RM_SW2.16 (IN2)
SWEN_U_RM_SW2_3: U_RM4.10 (IO0_6), U_RM_SW2.9 (IN3)
SWEN_U_RM_SW2_4: U_RM4.11 (IO0_7), U_RM_SW2.8 (IN4)
SWEN_U_RM_SW3_1: U_RM4.13 (IO1_0), U_RM_SW3.1 (IN1)
SWEN_U_RM_SW3_2: U_RM4.14 (IO1_1), U_RM_SW3.16 (IN2)
SWEN_U_RM_SW3_3: U_RM4.15 (IO1_2), U_RM_SW3.9 (IN3)
VBAT_PROT: C88.1, C89.1, C90.1, U_RM_SW1.13 (VDD), U_RM_SW2.13 (VDD), U_RM_SW3.13 (VDD)
VFEPS: K_GPT1.3 (COM), K_GPT2.3 (COM), K_RM_F9.3 (COM), K_RM_F11.3 (COM), K_RM_F12.3 (COM), K_RM_F13.3 (COM)
