OmniboxCreator/OmniBox/hardware/omnibox-v1/sheets/swcan_j1850.kicad_sch

## KiCad design hardware/omnibox-v1/sheets/swcan_j1850.kicad_sch (2026-07-20)

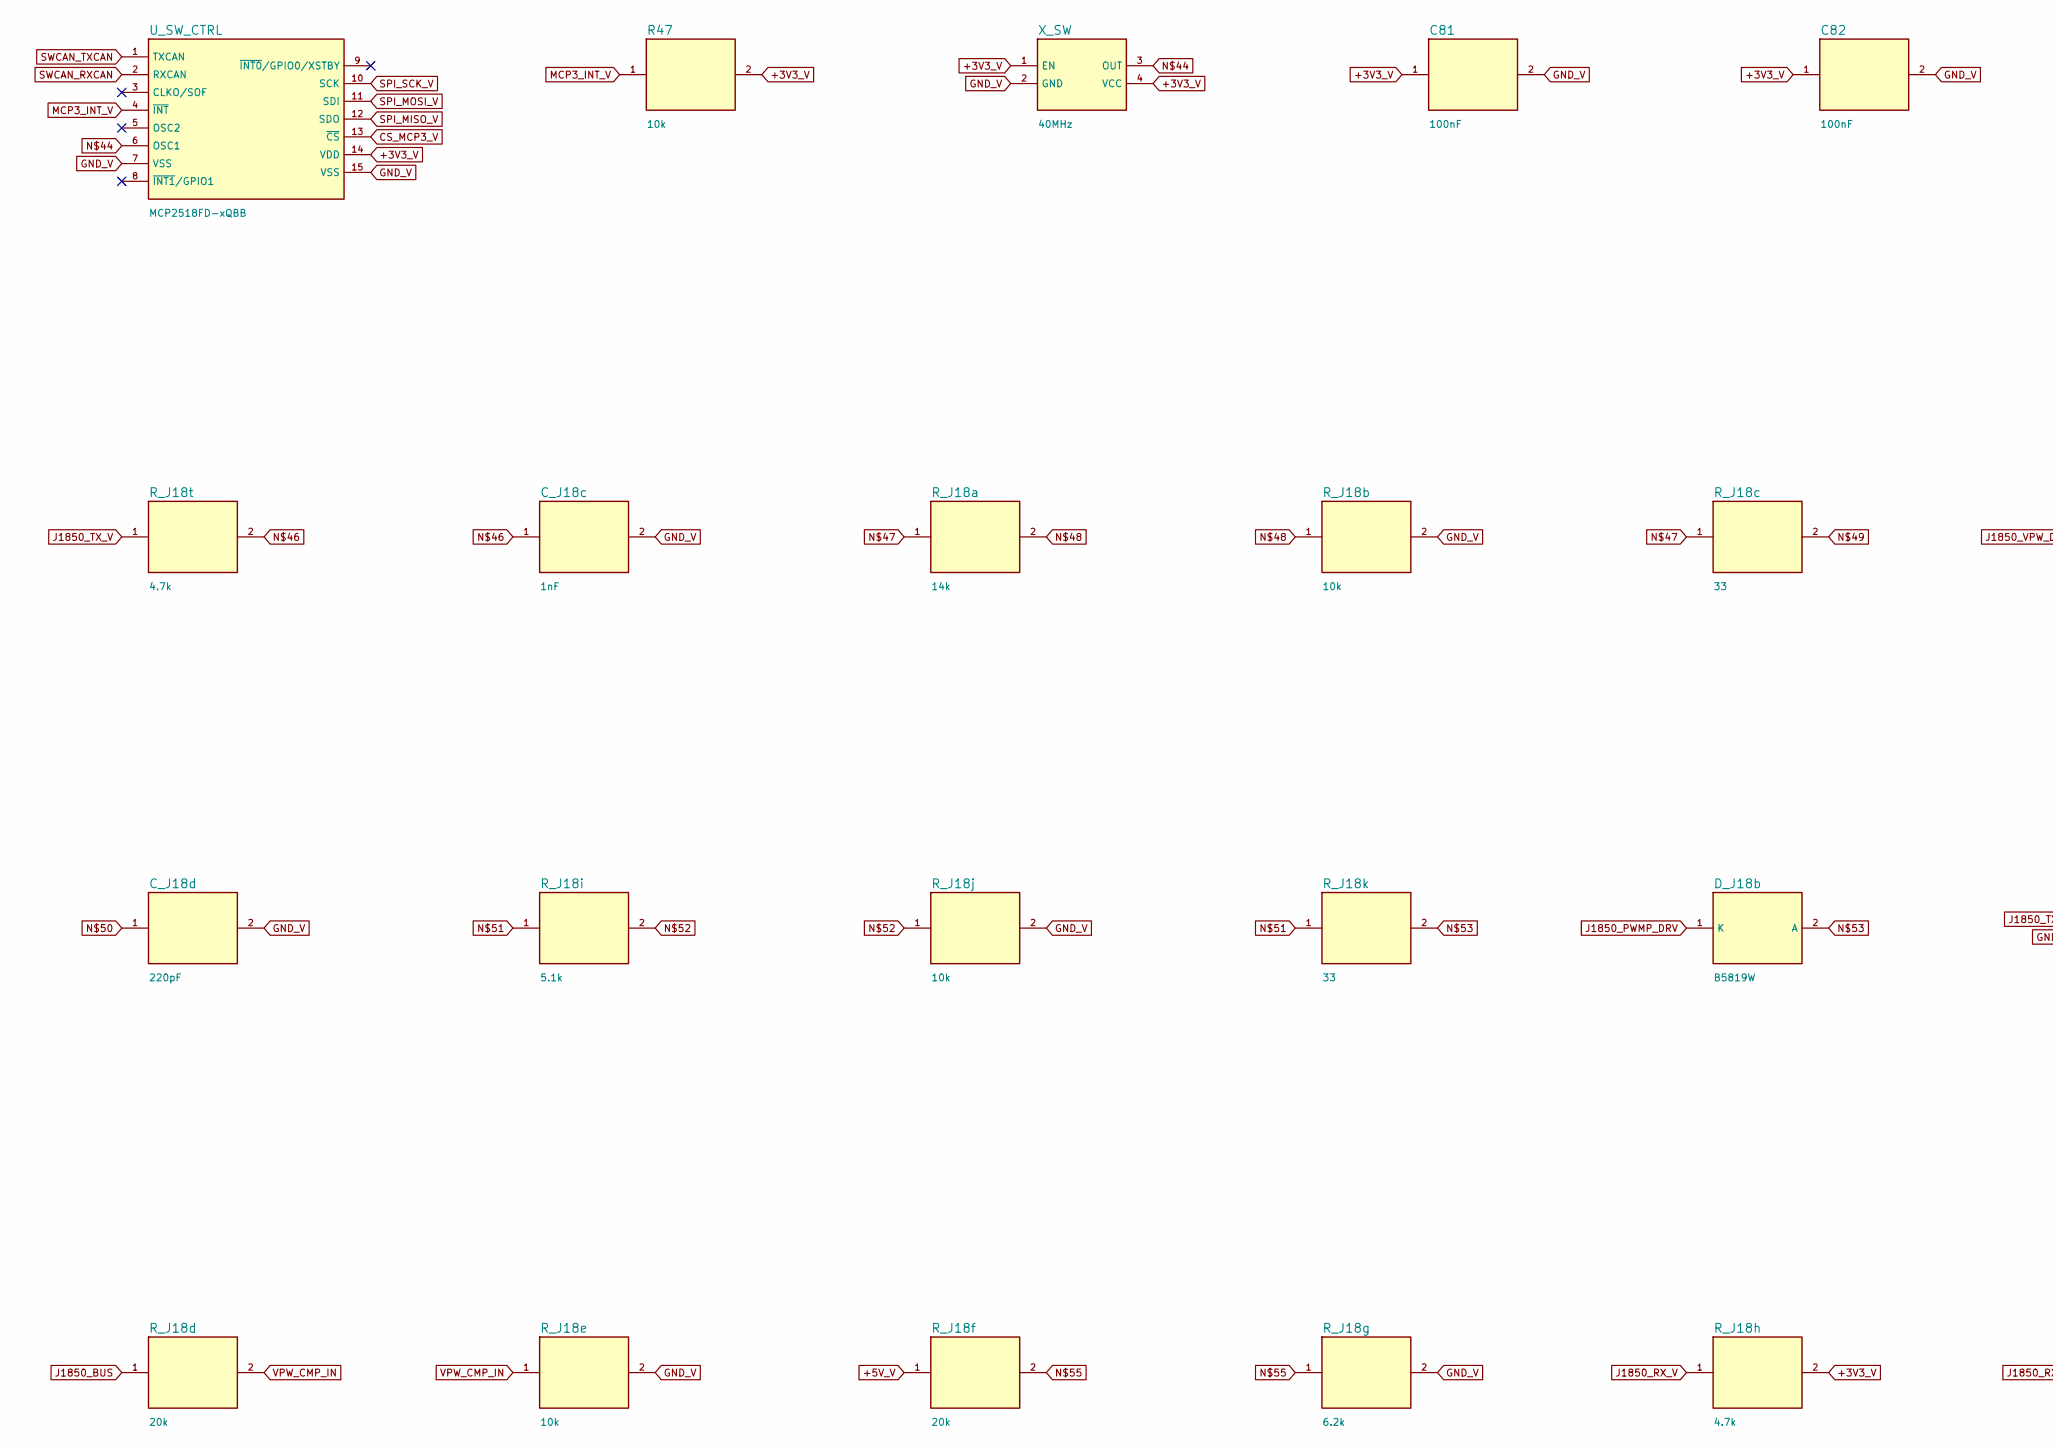
[picture p36: schematic swcan_j1850.kicad_sch, part in row 1, column 1]

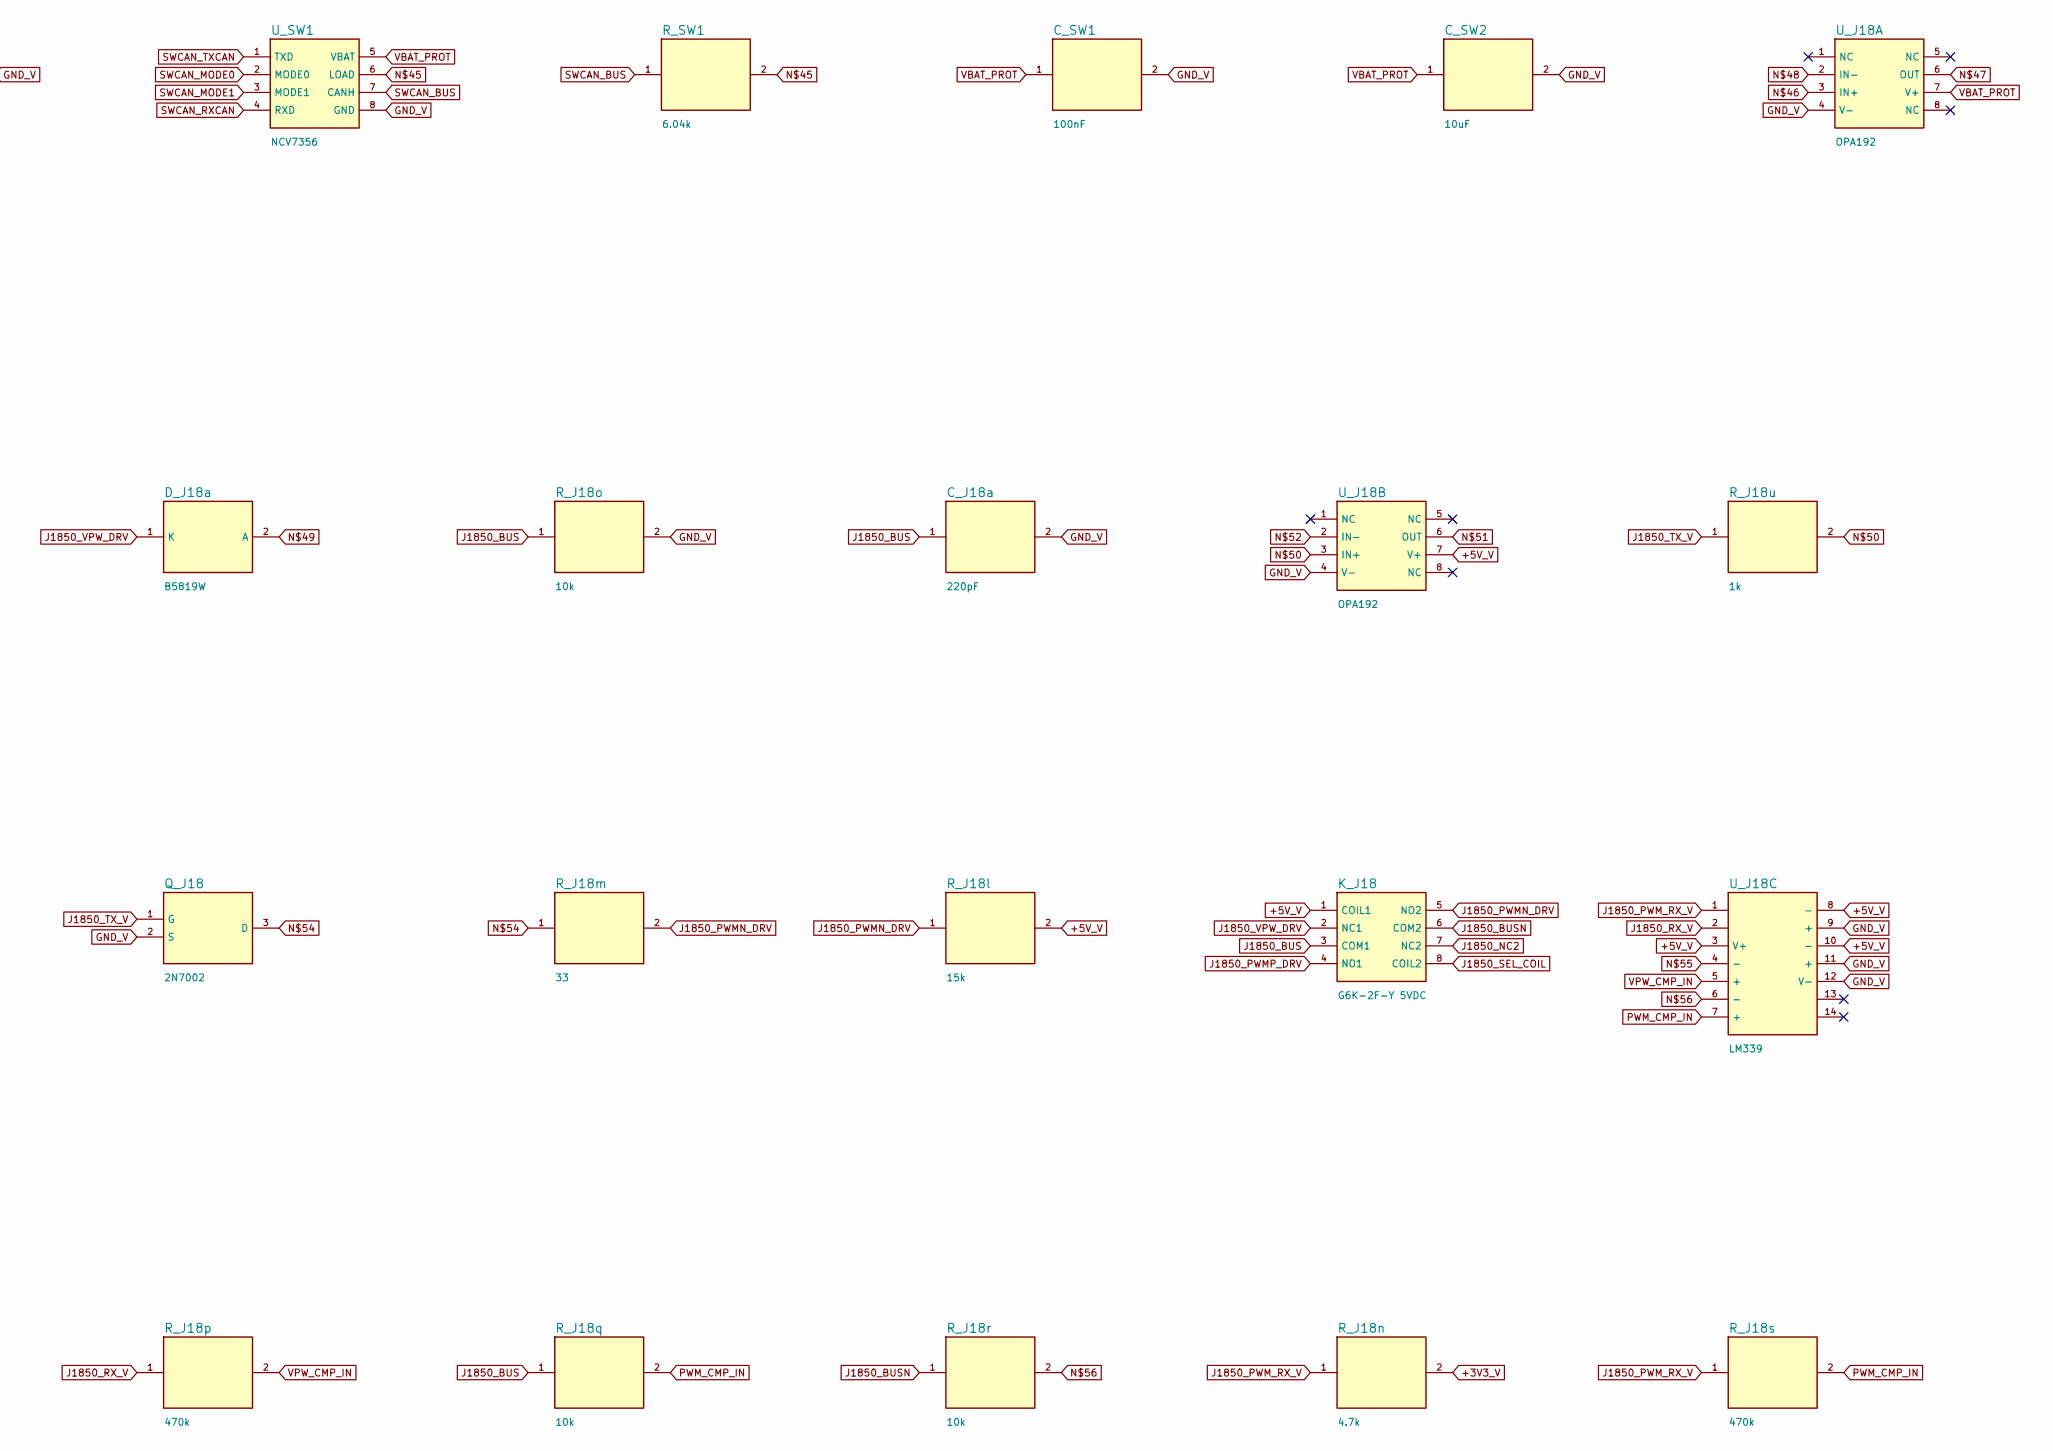
[picture p37: schematic swcan_j1850.kicad_sch, part in row 1, column 2]

Parts:
C81, C82: 100nF; C_0603_1608Metric
C_J18a, C_J18d: 220pF; C_0603_1608Metric
C_J18c: 1nF; C_0603_1608Metric
C_SW1: 100nF; C_0603_1608Metric
C_SW2: 10uF; C_0805_2012Metric
D_J18a, D_J18b: B5819W; D_SOD-123
K_J18: G6K-2F-Y 5VDC; Relay_DPDT_Omron_G6K-2F-Y
Q_J18: 2N7002; SOT-23
R47: 10k; R_0603_1608Metric
R_J18a: 14k; R_0603_1608Metric
R_J18b, R_J18e, R_J18j, R_J18o, R_J18q, R_J18r: 10k; R_0603_1608Metric
R_J18c, R_J18k, R_J18m: 33; R_0603_1608Metric
R_J18d, R_J18f: 20k; R_0603_1608Metric
R_J18g: 6.2k; R_0603_1608Metric
R_J18h, R_J18n, R_J18t: 4.7k; R_0603_1608Metric
R_J18i: 5.1k; R_0603_1608Metric
R_J18l: 15k; R_0603_1608Metric
R_J18p, R_J18s: 470k; R_0603_1608Metric
R_J18u: 1k; R_0603_1608Metric
R_SW1: 6.04k; R_0603_1608Metric
U_J18A, U_J18B: OPA192; SOIC-8_3.9x4.9mm_P1.27mm
U_J18C: LM339; SOIC-14_3.9x8.7mm_P1.27mm
U_SW1: NCV7356; SOIC-8_3.9x4.9mm_P1.27mm
U_SW_CTRL: MCP2518FD-xQBB; SOIC-14_3.9x8.7mm_P1.27mm
X_SW: 40MHz; Oscillator_SMD_Abracon_ASE-4Pin_3.2x2.5mm

Connections:
+3V3_V: C81.1, C82.1, R47.2, R_J18h.2, R_J18n.2, U_SW_CTRL.14 (VDD), X_SW.1 (EN), X_SW.4 (VCC)
+5V_V: K_J18.1 (COIL1), R_J18f.1, R_J18l.2, U_J18B.7 (V+), U_J18C.3 (V+), U_J18C.8 (-), U_J18C.10 (-)
CS_MCP3_V: U_SW_CTRL.13 (~CS)
GND_V: C81.2, C82.2, C_J18a.2, C_J18c.2, C_J18d.2, C_SW1.2, C_SW2.2, Q_J18.2 (S), R_J18b.2, R_J18e.2, R_J18g.2, R_J18j.2, R_J18o.2, U_J18A.4 (V-), U_J18B.4 (V-), U_J18C.9 (+), U_J18C.11 (+), U_J18C.12 (V-), U_SW1.8 (GND), U_SW_CTRL.7 (VSS), U_SW_CTRL.15 (VSS), X_SW.2 (GND)
J1850_BUS: C_J18a.1, K_J18.3 (COM1), R_J18d.1, R_J18o.1, R_J18q.1
J1850_BUSN: K_J18.6 (COM2), R_J18r.1
J1850_NC2: K_J18.7 (NC2)
J1850_PWMN_DRV: K_J18.5 (NO2), R_J18l.1, R_J18m.2
J1850_PWMP_DRV: D_J18b.1 (K), K_J18.4 (NO1)
J1850_PWM_RX_V: R_J18n.1, R_J18s.1, U_J18C.1
J1850_RX_V: R_J18h.1, R_J18p.1, U_J18C.2
J1850_SEL_COIL: K_J18.8 (COIL2)
J1850_TX_V: Q_J18.1 (G), R_J18t.1, R_J18u.1
J1850_VPW_DRV: D_J18a.1 (K), K_J18.2 (NC1)
MCP3_INT_V: R47.1, U_SW_CTRL.4 (~INT)
unnamed: U_SW_CTRL.6 (OSC1), X_SW.3 (OUT)
unnamed: R_SW1.2, U_SW1.6 (LOAD)
unnamed: C_J18c.1, R_J18t.2, U_J18A.3 (IN+)
unnamed: R_J18a.1, R_J18c.1, U_J18A.6 (OUT)
unnamed: R_J18a.2, R_J18b.1, U_J18A.2 (IN-)
unnamed: D_J18a.2 (A), R_J18c.2
unnamed: C_J18d.1, R_J18u.2, U_J18B.3 (IN+)
unnamed: R_J18i.1, R_J18k.1, U_J18B.6 (OUT)
unnamed: R_J18i.2, R_J18j.1, U_J18B.2 (IN-)
unnamed: D_J18b.2 (A), R_J18k.2
unnamed: Q_J18.3 (D), R_J18m.1
unnamed: R_J18f.2, R_J18g.1, U_J18C.4 (-)
unnamed: R_J18r.2, U_J18C.6 (-)
PWM_CMP_IN: R_J18q.2, R_J18s.2, U_J18C.7 (+)
SPI_MISO_V: U_SW_CTRL.12 (SDO)
SPI_MOSI_V: U_SW_CTRL.11 (SDI)
SPI_SCK_V: U_SW_CTRL.10 (SCK)
SWCAN_BUS: R_SW1.1, U_SW1.7 (CANH)
SWCAN_MODE0: U_SW1.2 (MODE0)
SWCAN_MODE1: U_SW1.3 (MODE1)
SWCAN_RXCAN: U_SW1.4 (RXD), U_SW_CTRL.2 (RXCAN)
SWCAN_TXCAN: U_SW1.1 (TXD), U_SW_CTRL.1 (TXCAN)
VBAT_PROT: C_SW1.1, C_SW2.1, U_J18A.7 (V+), U_SW1.5 (VBAT)
VPW_CMP_IN: R_J18d.2, R_J18e.1, R_J18p.2, U_J18C.5 (+)
