OmniboxCreator/OmniBox/hardware/omnibox-v1/sheets/usb_isolated.kicad_sch

## KiCad design hardware/omnibox-v1/sheets/usb_isolated.kicad_sch (2026-07-20)

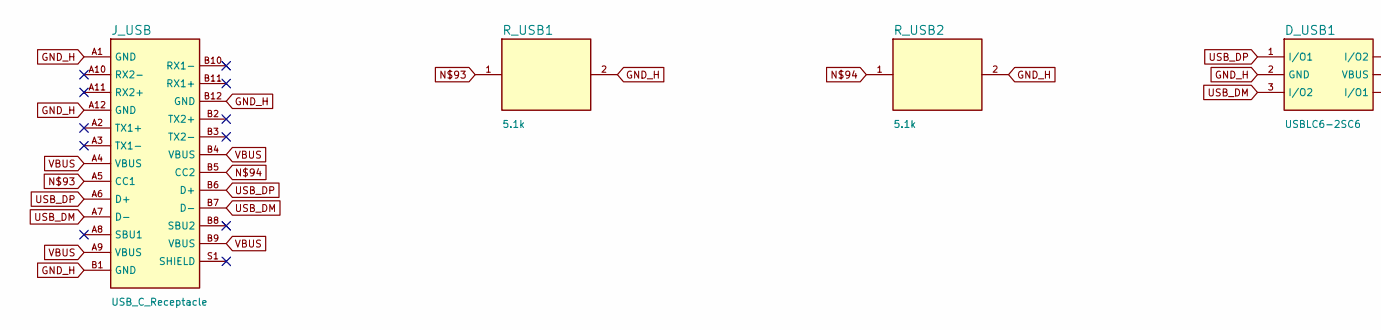
[picture p38: schematic usb_isolated.kicad_sch, part in row 1, column 1]

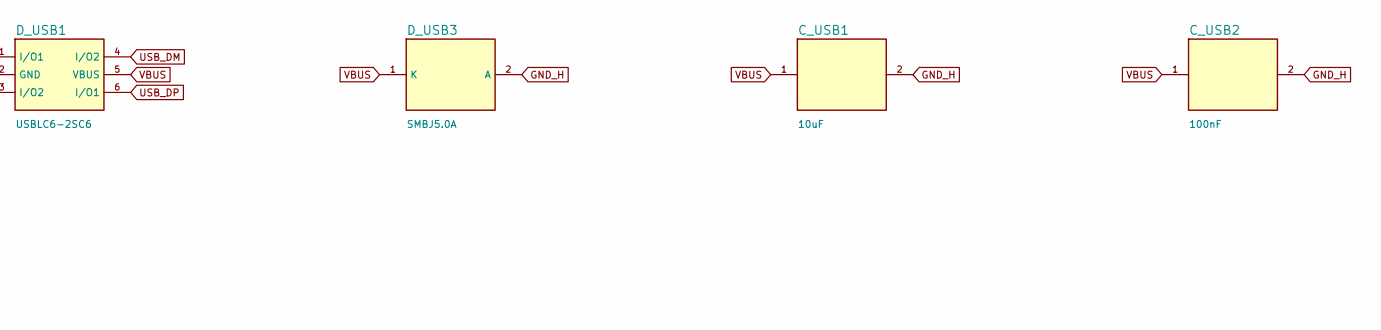
[picture p39: schematic usb_isolated.kicad_sch, part in row 1, column 2]

Parts:
C_USB1: 10uF; C_0805_2012Metric
C_USB2: 100nF; C_0603_1608Metric
D_USB1: USBLC6-2SC6; SOT-23-6
D_USB3: SMBJ5.0A; D_SMB
J_USB: USB_C_Receptacle; USB_C_Receptacle_GCT_USB4085
R_USB1, R_USB2: 5.1k; R_0603_1608Metric

Connections:
GND_H: C_USB1.2, C_USB2.2, D_USB1.2 (GND), D_USB3.2 (A), J_USB.A1 (GND), J_USB.A12 (GND), J_USB.B1 (GND), J_USB.B12 (GND), R_USB1.2, R_USB2.2
unnamed: J_USB.A5 (CC1), R_USB1.1
unnamed: J_USB.B5 (CC2), R_USB2.1
USB_DM: D_USB1.3 (I/O2), D_USB1.4 (I/O2), J_USB.A7 (D-), J_USB.B7 (D-)
USB_DP: D_USB1.1 (I/O1), D_USB1.6 (I/O1), J_USB.A6 (D+), J_USB.B6 (D+)
VBUS: C_USB1.1, C_USB2.1, D_USB1.5 (VBUS), D_USB3.1 (K), J_USB.A4 (VBUS), J_USB.A9 (VBUS), J_USB.B4 (VBUS), J_USB.B9 (VBUS)
