OmniboxCreator/OmniBox/firmware/src/drivers/mcp2518fd.h

#ifndef MCP2518FD_H
#define MCP2518FD_H

#include <stdint.h>

int mcp_init(uint8_t idx, uint32_t nominal_baud, uint32_t data_baud);
int mcp_tx(uint8_t idx, uint32_t id, const uint8_t *data, uint8_t len, uint32_t flags);
int mcp_read(uint8_t idx, uint32_t *id, uint8_t *data, uint8_t *len, uint32_t *flags);

#endif 
