OmniboxCreator/OmniBox/firmware/src/j2534/j2534_defs.h

#ifndef J2534_DEFS_H
#define J2534_DEFS_H

#include <stdint.h>


enum {
  J2534_J1850VPW   = 0x01,
  J2534_J1850PWM   = 0x02,
  J2534_ISO9141    = 0x03,
  J2534_ISO14230   = 0x04,
  J2534_CAN      = 0x05,
  J2534_ISO15765   = 0x06,
  J2534_SCI_A_ENGINE = 0x07,
  J2534_SCI_A_TRANS  = 0x08,
  J2534_SCI_B_ENGINE = 0x09,
  J2534_SCI_B_TRANS  = 0x0A,
};


enum {
  J2534_J1850VPW_PS  = 0x8000,
  J2534_J1850PWM_PS  = 0x8001,
  J2534_ISO9141_PS  = 0x8002,
  J2534_ISO14230_PS  = 0x8003,
  J2534_CAN_PS    = 0x8004,
  J2534_ISO15765_PS  = 0x8005,
  J2534_J2610_PS   = 0x8006,
  J2534_SW_ISO15765_PS= 0x8007,
  J2534_SW_CAN_PS   = 0x8008,  
  J2534_GM_UART_PS  = 0x8009,
  J2534_HONDA_DIAGH_PS= 0x800B,
  J2534_TP2_0_PS   = 0x800E,  
  J2534_FT_CAN_PS   = 0x800F,
};


enum {
  J2534_STATUS_NOERROR    = 0x00,
  J2534_ERR_NOT_SUPPORTED   = 0x01,
  J2534_ERR_INVALID_CHANNEL_ID= 0x02,
  J2534_ERR_INVALID_PROTOCOL_ID = 0x03,
  J2534_ERR_NULL_PARAMETER  = 0x04,
  J2534_ERR_TIMEOUT      = 0x09,
  J2534_ERR_INVALID_MSG    = 0x0A,
  J2534_ERR_BUFFER_EMPTY   = 0x10,
  J2534_ERR_BUFFER_FULL    = 0x11,
  J2534_ERR_BUFFER_OVERFLOW  = 0x12,  
  J2534_ERR_DEVICE_NOT_CONNECTED = 0x14,
  J2534_ERR_FAILED      = 0x16,
};


enum {
  J2534_GET_CONFIG      = 0x01,
  J2534_SET_CONFIG      = 0x02,
  J2534_READ_VBATT      = 0x03,  
  J2534_FIVE_BAUD_INIT    = 0x04,
  J2534_FAST_INIT      = 0x05,
  J2534_CLEAR_TX_BUFFER   = 0x07,
  J2534_CLEAR_RX_BUFFER   = 0x08,
  J2534_CLEAR_PERIODIC_MSGS = 0x09,
  J2534_CLEAR_MSG_FILTERS  = 0x0A,
  J2534_READ_PROG_VOLTAGE  = 0x0E,  
};


enum {
  J2534_PIN_AUX = 0, J2534_PIN_6 = 6, J2534_PIN_9 = 9, J2534_PIN_11 = 11,
  J2534_PIN_12 = 12, J2534_PIN_13 = 13, J2534_PIN_14 = 14, J2534_PIN_15 = 15,
};
#define J2534_VOLTAGE_OFF   0xFFFFFFFFu
#define J2534_SHORT_TO_GROUND 0xFFFFFFFEu
#define J2534_FEPS_MAX_MV   24000u  


enum { J2534_PASS_FILTER = 1, J2534_BLOCK_FILTER = 2, J2534_FLOW_CONTROL_FILTER = 3 };


enum {
  J2534_CFG_DATA_RATE    = 0x01,
  J2534_CFG_LOOPBACK     = 0x03,
  J2534_CFG_ISO15765_BS   = 0x1E,  
  J2534_CFG_ISO15765_STMIN  = 0x1F,  
  J2534_CFG_BS_TX      = 0x22,
  J2534_CFG_STMIN_TX     = 0x23,
  OMNI_CFG_PHYSICAL_BUS   = 0x7001,
  OMNI_CFG_OBD_PIN      = 0x7002,
  OMNI_CFG_TERMINATION   = 0x7003,
  OMNI_CFG_CAN_SWAP     = 0x7004,
  OMNI_CFG_CAN_DATA_RATE  = 0x7005,
  OMNI_CFG_CAN_FD      = 0x7006,
  OMNI_CFG_SWCAN_MODE    = 0x7007,
};


#define J2534_CAN_29BIT_ID   0x00000100u
#define J2534_ISO15765_FRAME_PAD 0x00000040u
#define J2534_TX_MSG_TYPE   0x00000001u
#define OMNI_CAN_FD_FRAME   0x40000000u
#define OMNI_CAN_BRS       0x20000000u


#define J2534_MSG_DATA_MAX 4128
typedef struct {
  uint32_t protocol_id;
  uint32_t rx_status;
  uint32_t tx_flags;
  uint32_t timestamp;
  uint32_t data_size;
  uint32_t extra_data_index;
  uint8_t data[J2534_MSG_DATA_MAX];
} j2534_msg_t;

#endif 
