OmniboxCreator/OmniBox/(notices)

Notices in the files:
README.md:
License: non-commercial
